frc971/971-Robot-Code/y2023_bot3/autonomous/splines/README.md

# Spline Descriptions
This folder contains reference material for what each spline does
