frc971/971-Robot-Code/y2022/localizer/kernel/README

As of 2022.02.08 this is the current version of the imu kernel driver being used
