frc971/971-Robot-Code/y2016/control_loops/python/2016_Controls_Physics_modeling.odt

2016 Robot Intake Physics Model

Michael Schuh

Spartan Robotics FRC Team 971

February 28, 2016

Models the chain on the intake as a spring. In the end, this problem was fixed by going from 25 chain to 35 chain. We considered including this physics model in the control code but never wrote code for it.

Notation

- i = i Subscript is for the Intake
- m = m Subscript is for the Motor
- B = Dampening Coefficient in N m/(rad/sec)
- G = the gear ratio and is dimensionless
- J = rotational inertia in kg m²
- Ks = Spring Constant in Nm/rad and %theta_{ i } is in rad.
- Kt = Motor Torque constant in N m/amp
- Kv = Motor Voltage constant in (rad/sec)/volt
- R = Resistance of the motor in ohms
- %theta = rotational angle in rad.
- ddot %theta = rotational angular speed in rad/sec
- ddot %theta = rotational angular acceleration in rad/sec²
- %tau = Torque in N m
- V = Volts in volts

The torques required to accelerate the inlet and motor rotational inertias are:

{%tau}_{Inertia_inlet} = {{ddot %theta}_{i} {J }_{i}} over {G} , {%tau}_{Inertia_motor} = {{ddot %theta}_{m} {J }_{m}} over {G}

As the motor angle moves ahead of the intake angle, the spring force increase and accelerates the intake faster in the positive %theta_{ m } direction and slows the motor.

{ %tau}_{Spring} = K_{s}( {{%theta}_{m}} over {G} - { %theta_{i}})

As the motor rotational speed moves ahead of the intake rotational speed, the damper force increase and accelerates the intake faster in the positive %theta_{ m } direction and slows the motor.

{ %tau}_{Damper} = B({ {{{dot %theta}}_{m}} over {G} - {dot %theta}_{i}} )

{ %tau}_{Motor} = {V K_{t}} over {R}- { {{{dot %theta}}_{m}} over {R {K}_{v}}}

The torques must balance on both the motor side of the chain and the intake side of the chain. It is easier to model the chain as a torsional spring with a damper than mess with the different radii. This will break down as the radius of the sprockets on the motor side and the intake side of the chain differ from each other.

For the motor,

{%tau}_{Inertia_motor} = {%tau}_{Motor}-{%tau}_{Spring} - {%tau}_{Damper}

{{ddot %theta}_{m} {J }_{m}} over {G} ~ = ~
{V K_{t}} over {R} ~ - ~ { {{{dot %theta}}_{m}} over {R {K}_{v}}}
~ - ~ K_{s}({{{%theta}_{m}} over {G}- %theta_{i} } )
~ - ~ B({{{{dot %theta}}_{m}} over {G} - {dot %theta}_{i}} )

collecting terms and isolating

{ddot %theta}_m ~ = ~

{G K_{t}} over {{R J_m}}V
~ - ~ { G over {R {K}_v J_m}}{{dot %theta}_m}
~ - ~ K_{s} over { J_m } {{%theta}_m}
~ + ~ {{ K_{s}G} over {J_m}%theta_i}
~ - ~ B over { J_m } {{dot %theta}_m}
~ + ~ {{ BG} over {J_m}{dot %theta}_i}

{ddot %theta}_m ~ = ~

~ - K_{s} over { J_m } {{%theta}_m}
~ - ~ ({{ G over {R {K}_v J_m}} + B over { J_m }}) {{dot %theta}_m}

~ + ~ {{ K_{s}G} over {J_m}%theta_i}
~ + ~ {{ BG} over {J_m}{dot %theta}_i}
~ + ~ {G K_{t}} over {{R J_m}}V

rewriting using coefficients

{ddot %theta }_m ~ = ~ -C_1 %theta_m
~ - ~ C_2 {dot%theta}_m
~ + ~ C_3 %theta_i
~ + ~ C_4 {dot%theta}_i
~ + ~ C_9 V

for the intake,

{%tau}_{Inertia_intake} = {%tau}_{Spring} + {%tau}_{Damper}

{{ddot %theta}_{i} {J }_{i}} over {G} = K_{s}( {{%theta}_{m}} over {G} - { %theta_{i}}) " " + " " B({ {{{dot %theta}}_{m}} over {G} - {dot %theta}_{i}} )

collecting terms and isolating {ddot %theta}_i

{ddot %theta}_i ~ = ~
K_{s} over { J_i } {{%theta}_m}
~ - ~ {{ K_{s}G} over {J_i}%theta_i}
~ + ~ B over { J_i } {{dot %theta}_m}
~ - ~ {{ BG} over {J_i}{dot %theta}_i}

rearranging

{ddot %theta}_i ~ = ~
K_{s} over { J_i } {{%theta}_m}
~ + ~ B over { J_i } {{dot %theta}_m}
~ - ~ {{ K_{s}G} over {J_i}%theta_i}
~ - ~ {{ BG} over {J_i}{dot %theta}_i}

{ddot %theta }_i ~ = ~ C_5 %theta_m
~ + ~ C_6 {dot%theta}_m
~ - ~ C_7 %theta_i
~ - ~ C_8 {dot%theta}_i

Putting in matrix form:

dot { left [ matrix{%theta_m ## %omega_m ## %theta_i ## %omega_i} right ] } ~ = ~
left [ matrix{ 0 # 1 # 0 # 0 ##
-C_1 #-C_2 # C_3 # C_4 ##
0 # 0 # 0 # 1 ##
C_5 # C_6 #-C_7 #-C_8} right ]
left [ matrix{%theta_m ## %omega_m ## %theta_i ## %omega_i} right ]
~ + ~ left [ matrix{ 0 ## C_9 ## 0 ## 0 } right ]left[ V right ]
