frc971/971-Robot-Code/documentation/README.md

# Robot Code Documentation
This folder contains reference material for how to write robot code, organized
as a set of markdown files.

# Tutorials Index

## Basic setup and development tools
* [Getting started](tutorials/getting-started.md)
* [Git and Gerrit basics](tutorials/git-and-gerrit-basics.md)
* [Submitting code for review](tutorials/submitting-code-for-a-review.md)
* [Set up access to the build server using vscode](tutorials/setup-ssh-vscode.md)
* [Install PyCharm on the build server](tutorials/setup-pycharm-on-build-server.md)

## Working with the robot
* [Putting code on the robot](tutorials/download-code-to-the-robot.md)
* [Network troubleshooting](tutorials/network_troubleshooting.md)
* [Running gdb on the rio](tutorials/rio-gdb.md)
