frc971/971-Robot-Code/frc971/control_loops/python/field_images/2019.png

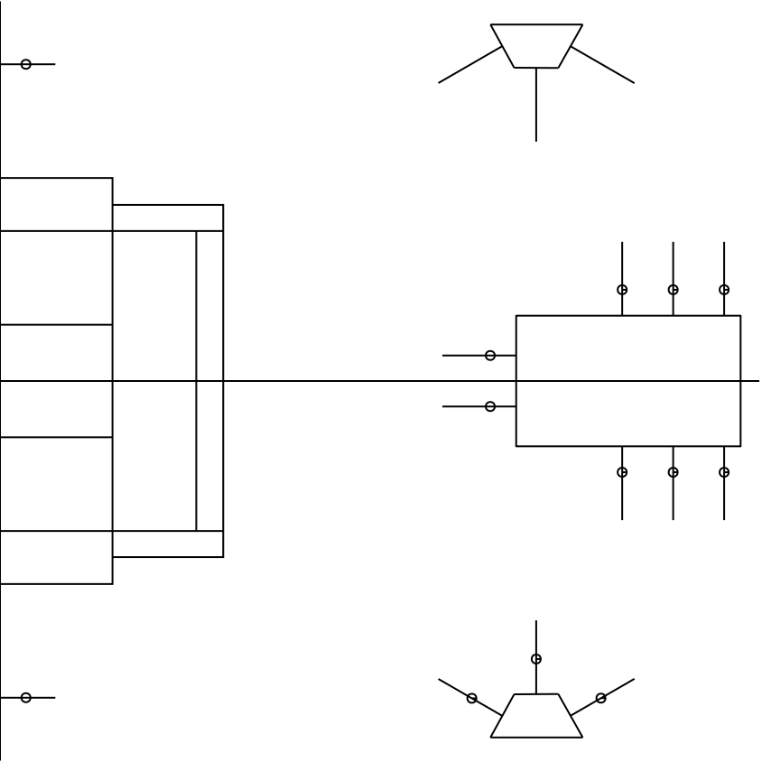
frc971/control_loops/python/field_images/2019.png
