frc971/971-Robot-Code/frc971/control_loops/python/field_images/autonav_barrel.png

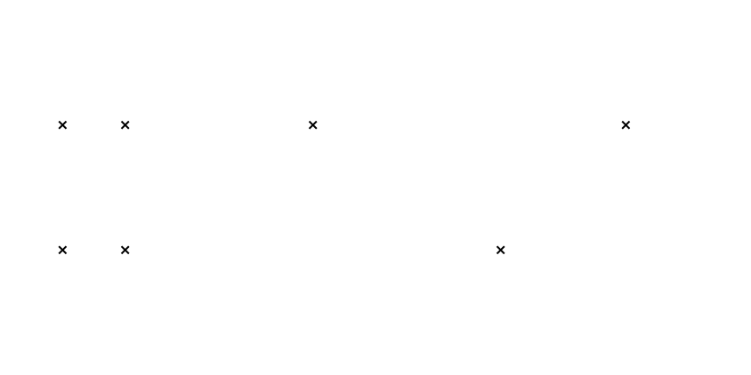
frc971/control_loops/python/field_images/autonav_barrel.png
