frc971/971-Robot-Code/frc971/control_loops/python/field_images/autonav_bounce.png

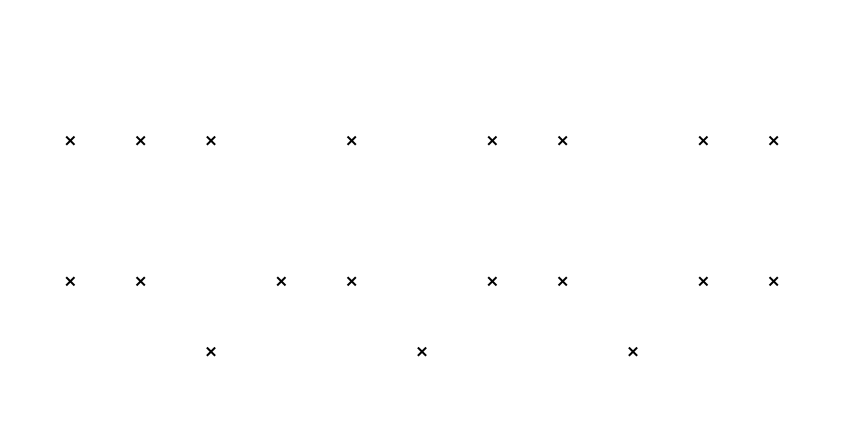
frc971/control_loops/python/field_images/autonav_bounce.png
