frc971/971-Robot-Code/frc971/control_loops/python/field_images/blue_b.png

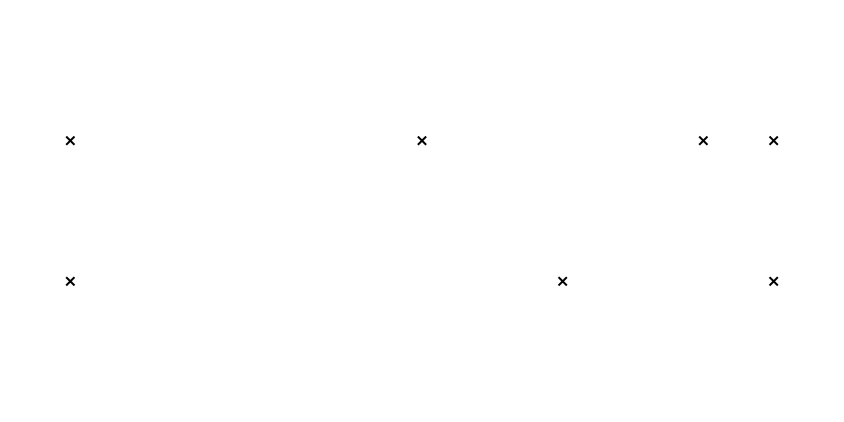
frc971/control_loops/python/field_images/blue_b.png
