frc971/971-Robot-Code/frc971/vision_codelab/blue_a.png

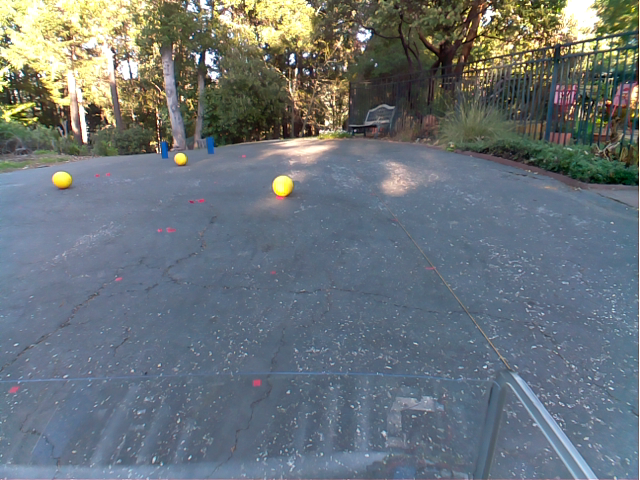
frc971/vision_codelab/blue_a.png
