frc971/971-Robot-Code/frc971/vision_codelab/red_b.png

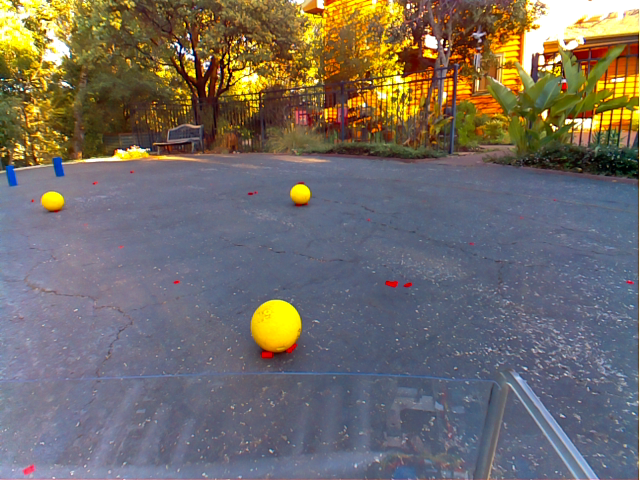
frc971/vision_codelab/red_b.png
