frc971/971-Robot-Code/frc971/vision_codelab/unknown.png

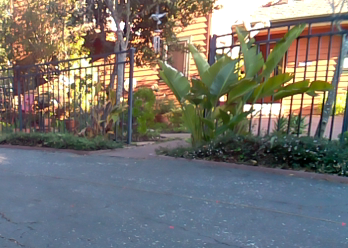
frc971/vision_codelab/unknown.png
