frc971/971-Robot-Code/scouting/www/assets/971_144.png

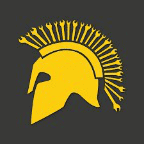
scouting/www/assets/971_144.png
