frc971/971-Robot-Code/circuit_boards/BuckBoost/RockPI-Power-Board/3dModels/IHLP2020CZ.step

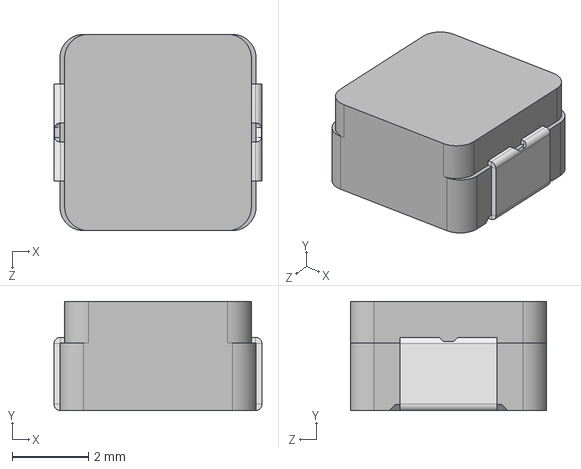
[picture p16: CAD file, 2022-12-15, last stored version]
circuit_boards/BuckBoost/RockPI-Power-Board/3dModels/IHLP2020CZ.step
5.45 x 2.86 x 5.15 mm
