frc971/971-Robot-Code/circuit_boards/BuckBoost/RockPI-Power-Board/Components/heatsink-1225-al-1.stp

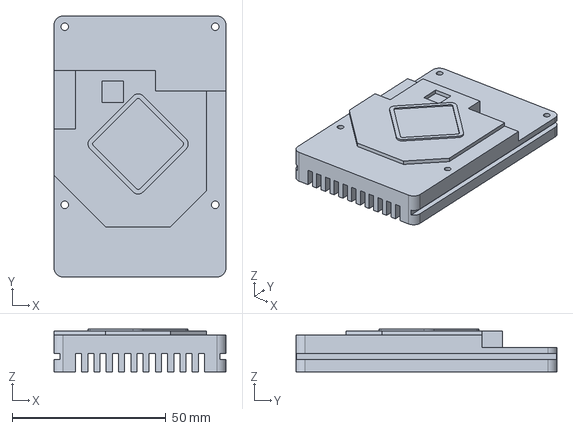
[picture p17: CAD file, 2022-12-15, last stored version]
circuit_boards/BuckBoost/RockPI-Power-Board/Components/heatsink-1225-al-1.stp
56.0 x 85.0 x 14.0 mm
