frc971/971-Robot-Code/circuit_boards/connector_boards/potentiometer_adapter/3d models/Bourns-3547.step

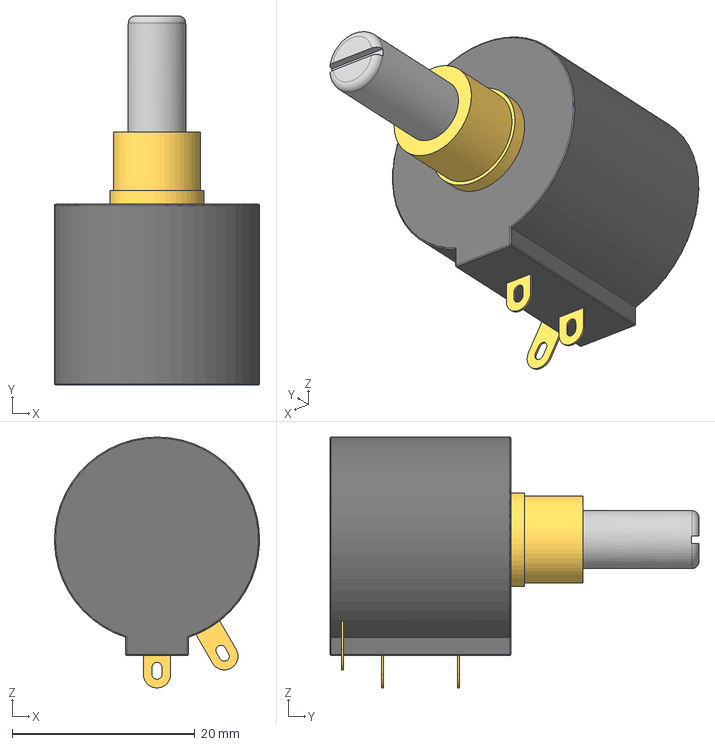
[picture p18: CAD file, 2022-10-24, last stored version]
circuit_boards/connector_boards/potentiometer_adapter/3d models/Bourns-3547.step
22.5 x 40.4 x 27.5 mm
