frc971/971-Robot-Code/circuit_boards/led-ring-driver/kicad/components/3D_Step/10 SIZE CODE G-L.stp

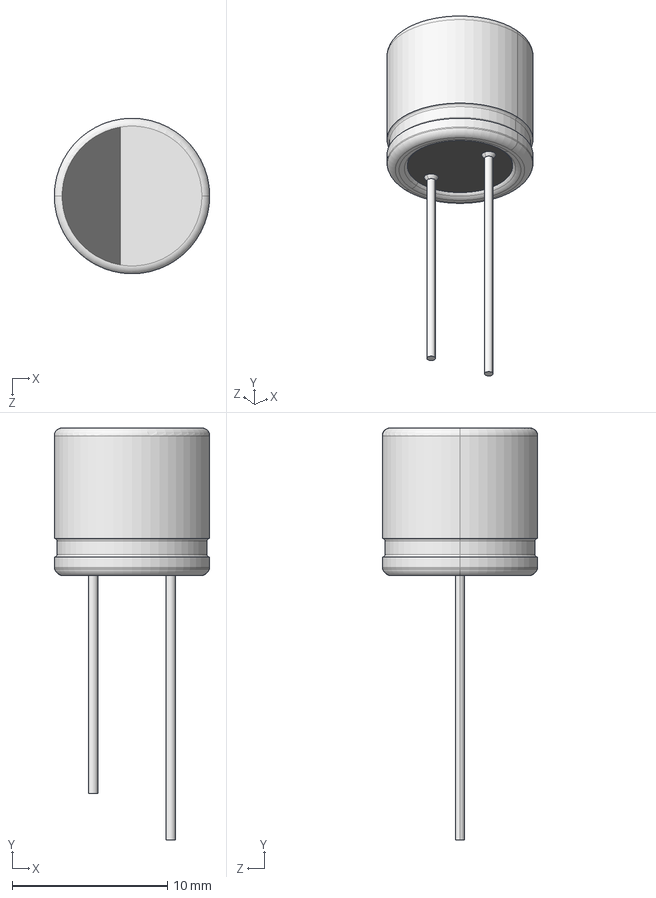
[picture p19: CAD file, 2022-02-21, last stored version]
circuit_boards/led-ring-driver/kicad/components/3D_Step/10 SIZE CODE G-L.stp
10.0 x 26.5 x 10.0 mm
