frc971/971-Robot-Code/circuit_boards/connector_boards/encoder_adapter/3d-model/CRCW08051K20FKEAC.STEP

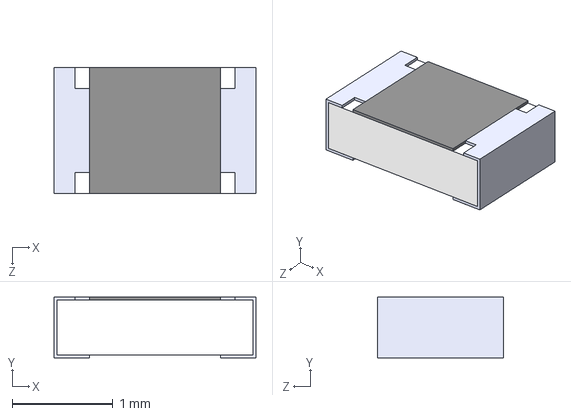
[picture p20: CAD file, 2022-10-15, last stored version]
circuit_boards/connector_boards/encoder_adapter/3d-model/CRCW08051K20FKEAC.STEP
2.00 x 0.6 x 1.25 mm
