frc971/971-Robot-Code/circuit_boards/led-ring-driver/kicad/components/3D_Step/LUXEON_2835_20160407_STEP.STEP

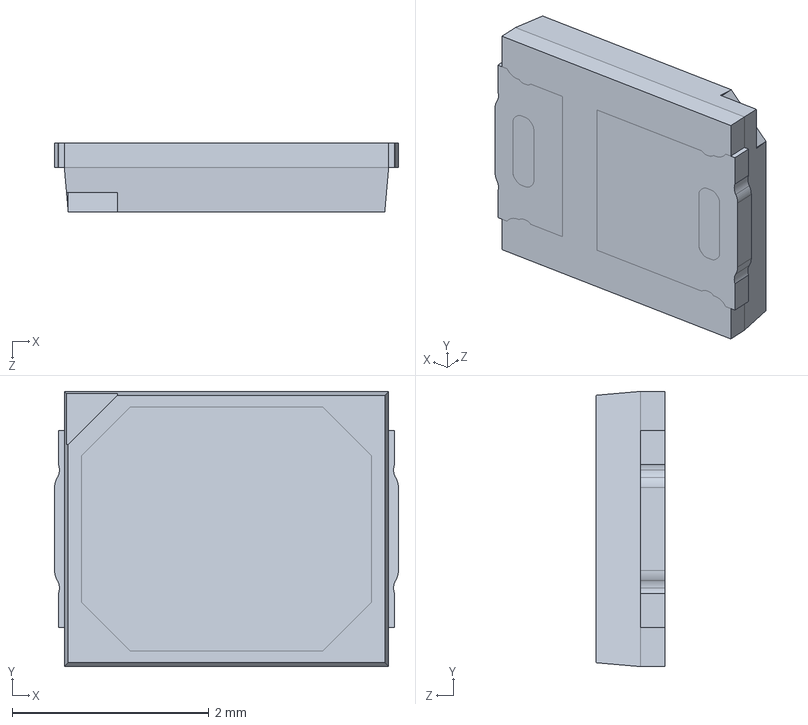
[picture p21: CAD file, 2022-02-21, last stored version]
circuit_boards/led-ring-driver/kicad/components/3D_Step/LUXEON_2835_20160407_STEP.STEP
3.50 x 2.80 x 0.701 mm
