frc971/971-Robot-Code/circuit_boards/BuckBoost/RockPI-Power-Board/3dModels/ECS-5032MV-400-CN-TR.STEP

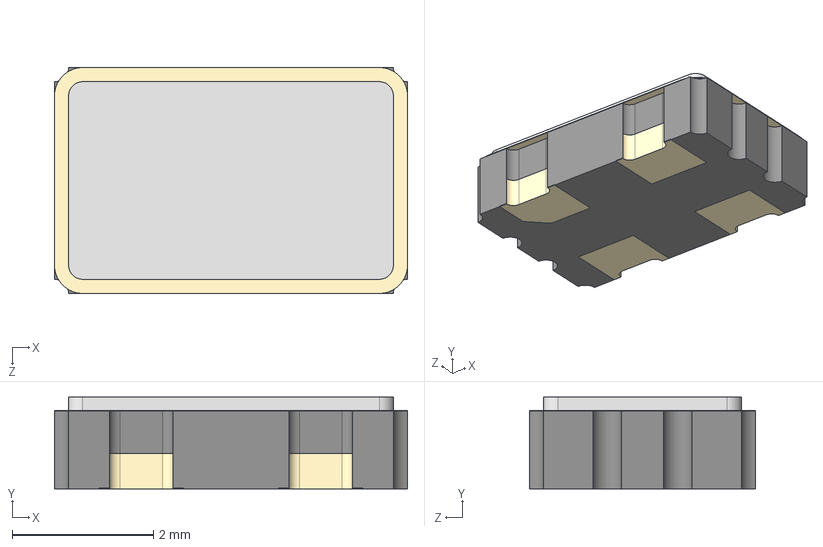
[picture p22: CAD file, 2022-12-15, last stored version]
circuit_boards/BuckBoost/RockPI-Power-Board/3dModels/ECS-5032MV-400-CN-TR.STEP
5.00 x 1.30 x 3.20 mm
