frc971/971-Robot-Code/circuit_boards/led-ring-driver/kicad/components/3D_Step/SRP3020C-1R0M_BRN.step

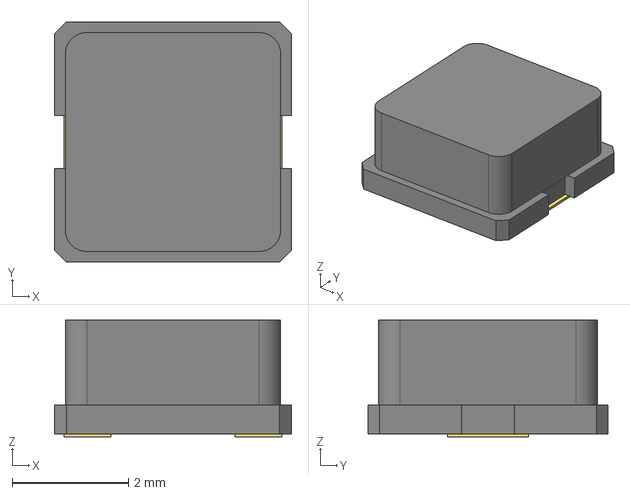
[picture p23: CAD file, 2022-02-21, last stored version]
circuit_boards/led-ring-driver/kicad/components/3D_Step/SRP3020C-1R0M_BRN.step
4.07 x 4.13 x 2.01 mm
