frc971/971-Robot-Code/circuit_boards/connector_boards/encoder_adapter/3d-model/S1-X-250-X-B-D.STEP

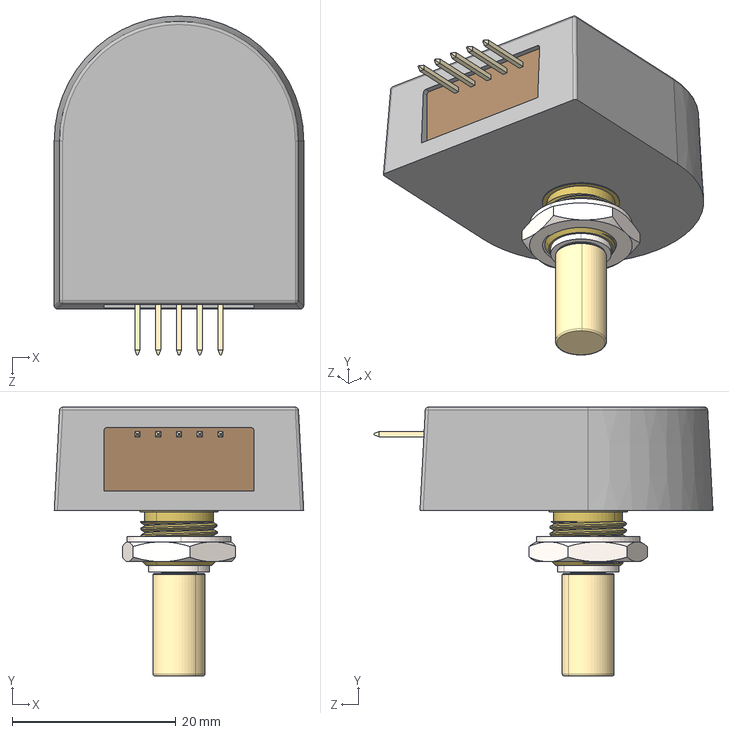
[picture p24: CAD file, 2022-10-15, last stored version]
circuit_boards/connector_boards/encoder_adapter/3d-model/S1-X-250-X-B-D.STEP
30.5 x 32.8 x 41.4 mm
