frc971/971-Robot-Code/circuit_boards/BuckBoost/RockPI-Power-Board/3dModels/VSON8-DQJ0008A.stp

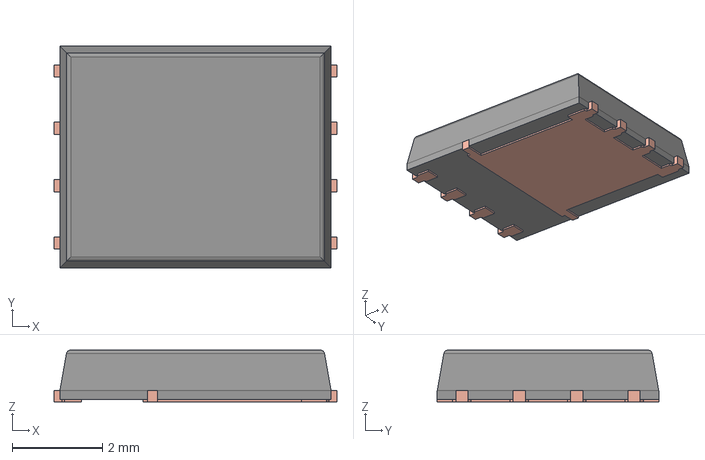
[picture p25: CAD file, 2022-12-15, last stored version]
circuit_boards/BuckBoost/RockPI-Power-Board/3dModels/VSON8-DQJ0008A.stp
6.26 x 4.90 x 1.15 mm
FRAME
MOLD
