frc971/971-Robot-Code/circuit_boards/BuckBoost/RockPI-Power-Board/3dModels/SH-7010TA.stp

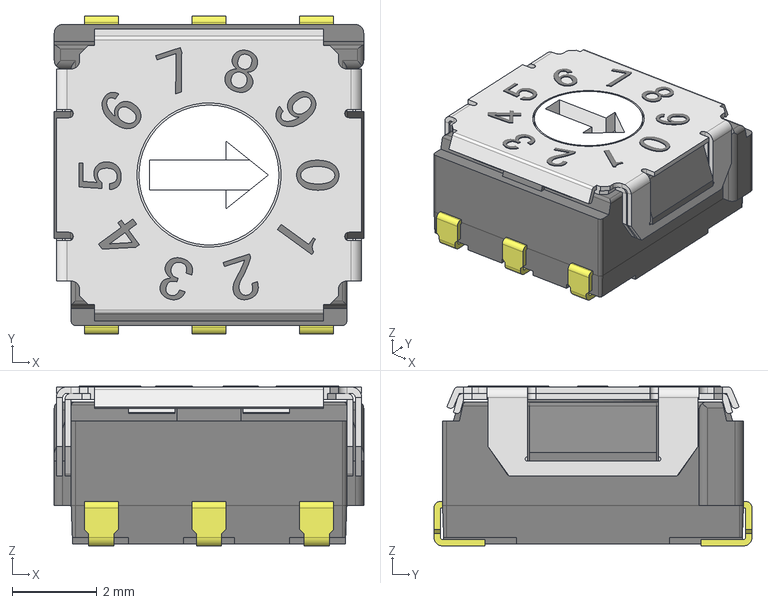
[picture p26: CAD file, 2022-12-15, last stored version]
circuit_boards/BuckBoost/RockPI-Power-Board/3dModels/SH-7010TA.stp
7.30 x 7.50 x 3.77 mm
SH-700-Without knob (Minus slot)
SH-7010A_body
