frc971/971-Robot-Code/circuit_boards/BuckBoost/RockPI-Power-Board/3dModels/m20-7812045_asm.stp

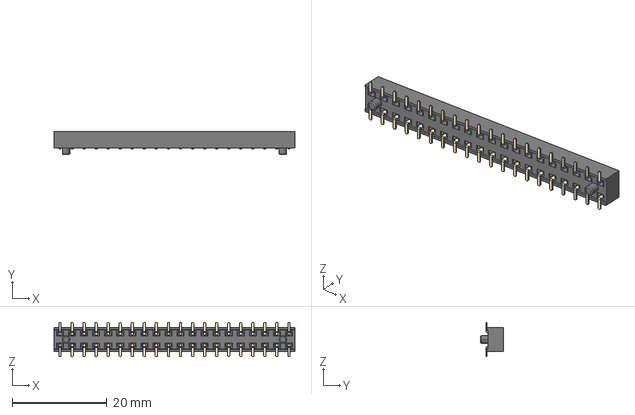
[picture p27: CAD file, 2022-12-15, last stored version]
circuit_boards/BuckBoost/RockPI-Power-Board/3dModels/m20-7812045_asm.stp
50.8 x 4.95 x 7.20 mm
M20-78120_MOULD
M20-781_CONTACT x 40
