frc971/971-Robot-Code/circuit_boards/BuckBoost/RockPI-Power-Board/3dModels/70555-0003.stp/705550003.stp

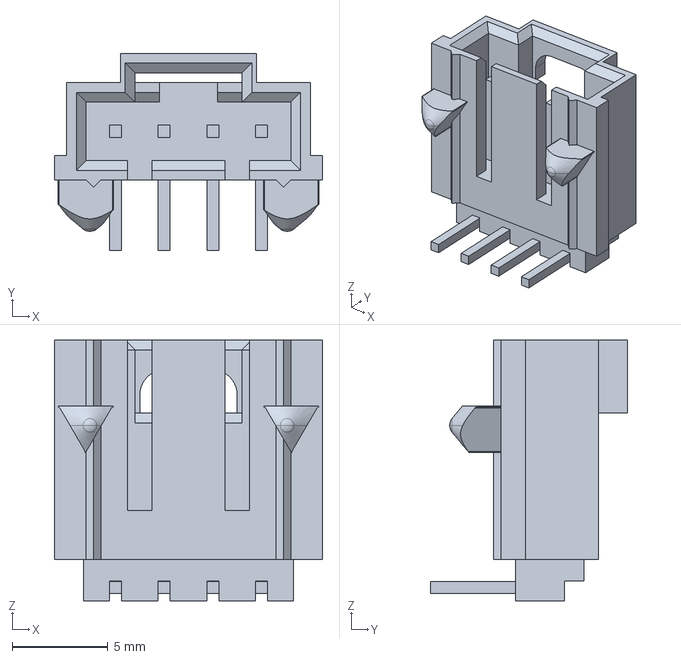
[picture p28: CAD file, 2022-12-15, last stored version]
circuit_boards/BuckBoost/RockPI-Power-Board/3dModels/70555-0003.stp/705550003.stp
14.0 x 10.3 x 13.6 mm
