frc971/971-Robot-Code/circuit_boards/CAN_boards/CAN_Terminator/3D model/70555-0036_stp/705550036.stp

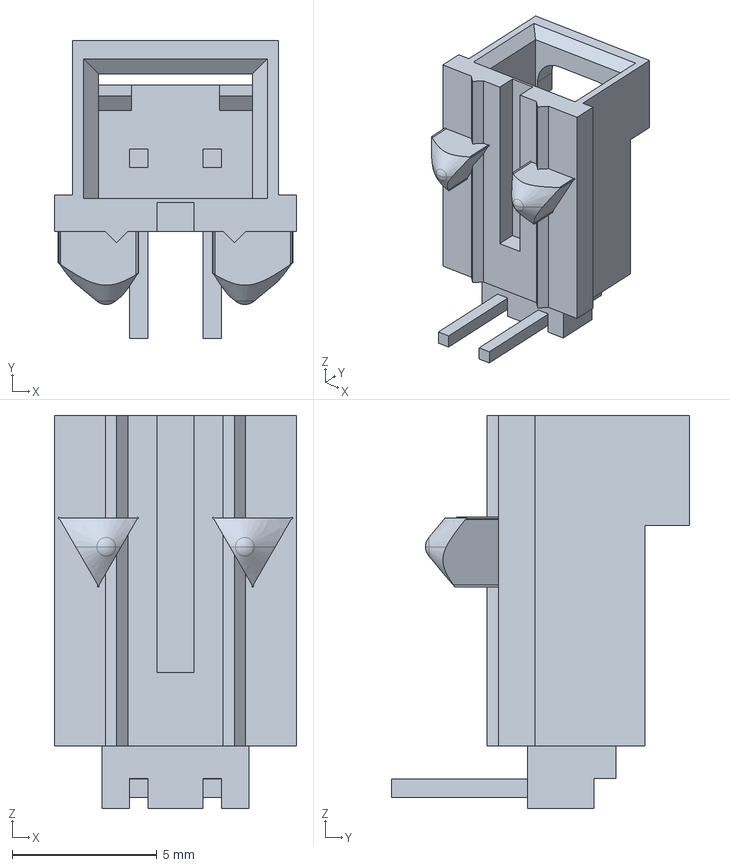
[picture p29: CAD file, 2024-02-19, last stored version]
circuit_boards/CAN_boards/CAN_Terminator/3D model/70555-0036_stp/705550036.stp
8.38 x 10.3 x 13.6 mm
