frc971/971-Robot-Code/circuit_boards/connector_boards/encoder_adapter/3d-model/150080AS75000_Download_STP_WL-SMCW-0805_rev1.stp

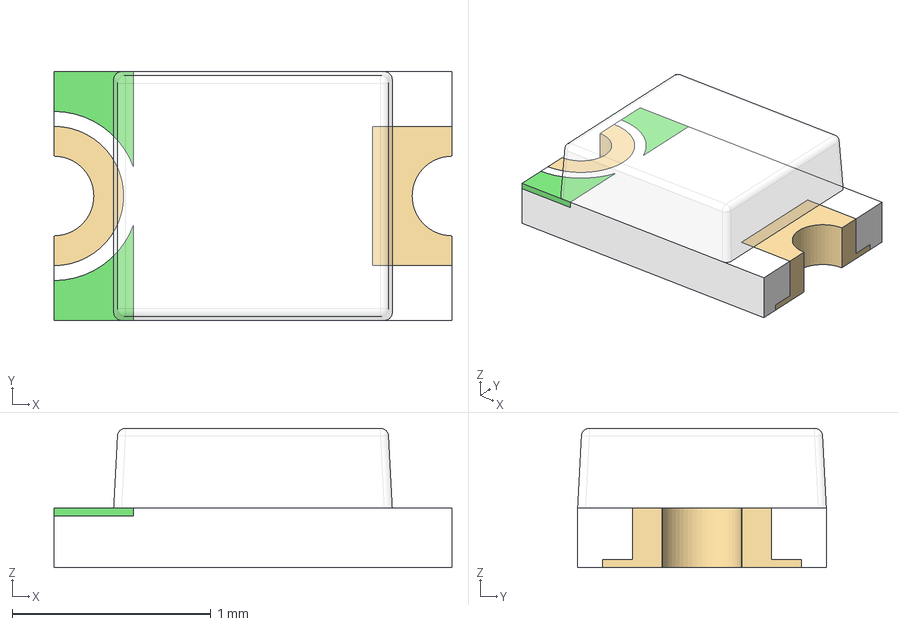
[picture p30: CAD file, 2022-10-15, last stored version]
circuit_boards/connector_boards/encoder_adapter/3d-model/150080AS75000_Download_STP_WL-SMCW-0805_rev1.stp
2.00 x 1.25 x 0.7 mm
housing
marking x 2
cover
base_2
base
