frc971/971-Robot-Code/circuit_boards/connector_boards/MAG_encoder_adapter/3D models/70555-0005--3DModel-STEP-361473.STEP

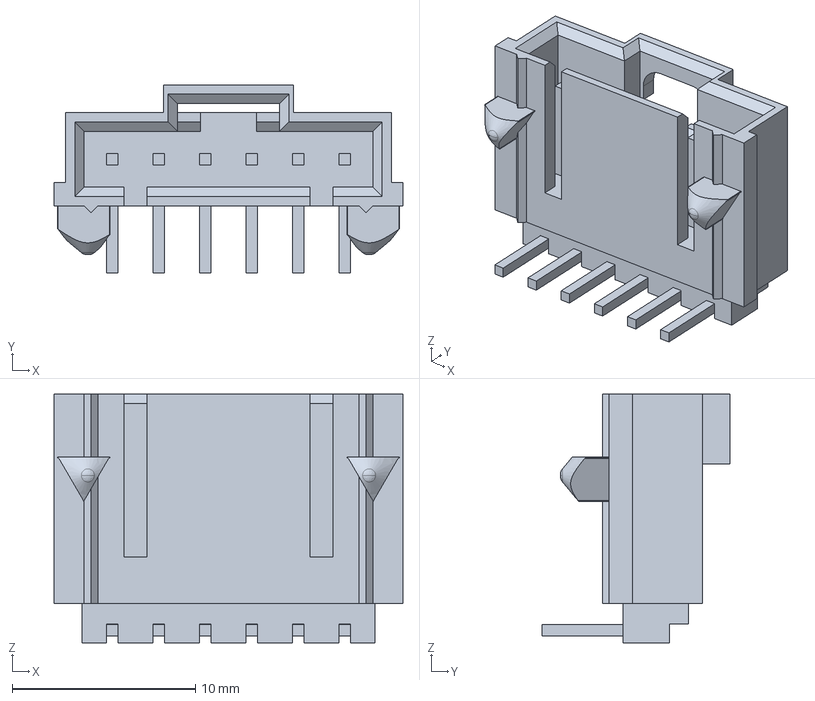
[picture p31: CAD file, 2022-10-24, last stored version]
circuit_boards/connector_boards/MAG_encoder_adapter/3D models/70555-0005--3DModel-STEP-361473.STEP
19.1 x 10.3 x 13.6 mm
