frc971/971-Robot-Code/circuit_boards/connector_boards/RRIB2/3dModels/705410005.stp

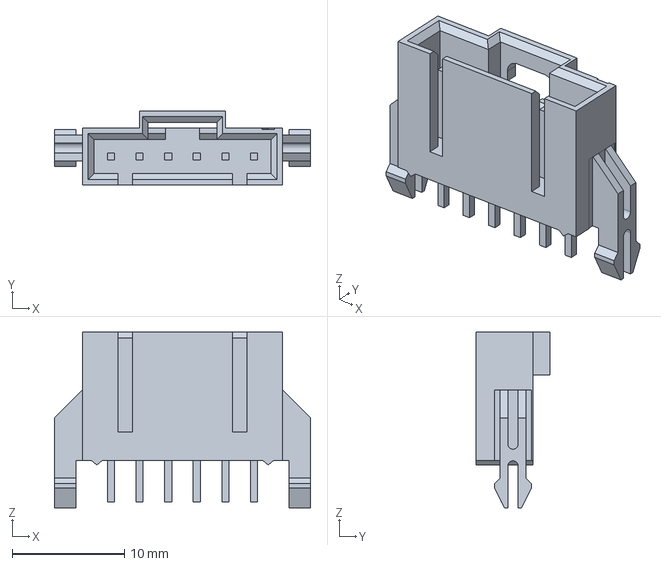
[picture p32: CAD file, 2023-02-12, last stored version]
circuit_boards/connector_boards/RRIB2/3dModels/705410005.stp
22.8 x 6.60 x 15.6 mm
