frc971/971-Robot-Code/(list of files, cad)

Other CAD files:
circuit_boards/BuckBoost/RockPI-Power-Board/3dModels/705550001.stp
circuit_boards/BuckBoost/RockPI-Power-Board/3dModels/705550002.stp
circuit_boards/BuckBoost/RockPI-Power-Board/3dModels/705550011.stp
circuit_boards/BuckBoost/RockPI-Power-Board/3dModels/744031001_Download_STP_WE-TPC-3816_rev1.stp
circuit_boards/connector_boards/MAG_encoder_adapter/3D models/20021521-00010XXLFc.stp
circuit_boards/connector_boards/MAG_encoder_adapter/3D models/705550002.stp
circuit_boards/connector_boards/RRIB2/3dModels/705410001.stp
circuit_boards/connector_boards/RRIB2/3dModels/705410002.stp
circuit_boards/connector_boards/RRIB2/3dModels/705410003.stp
circuit_boards/connector_boards/RRIB2/3dModels/705410004.stp
circuit_boards/connector_boards/RRIB2/3dModels/705410006.stp
circuit_boards/connector_boards/encoder_adapter/3d-model/705410074.stp
circuit_boards/hall-effect/3D-models/015913034.stp
circuit_boards/led-ring-driver/kicad/components/3D_Step/430450601.stp
motors/led-ring-driver/kicad/components/3D_Step/430450601.stp
