frc971/971-Robot-Code/y2020/vision/tools/python_code/test_images/test_game_manual.png

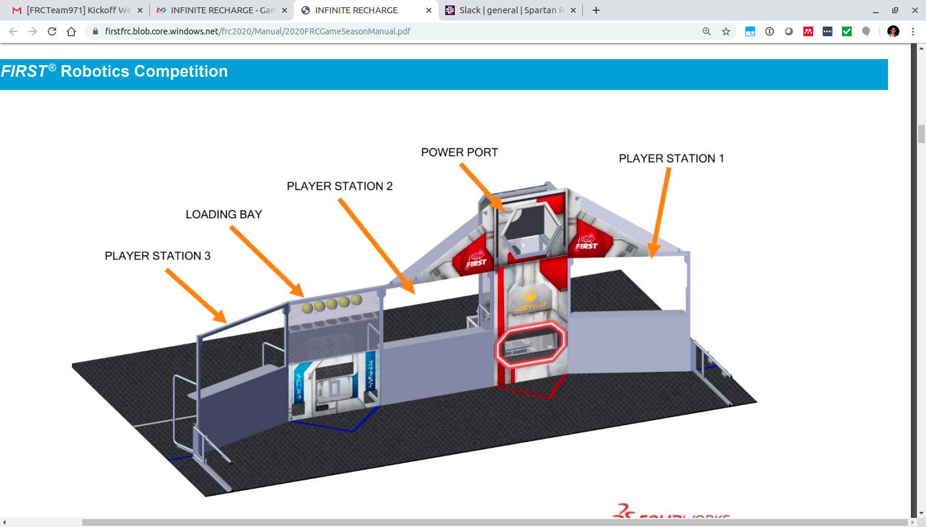
y2020/vision/tools/python_code/test_images/test_game_manual.png
