frc971/971-Robot-Code/y2020/vision/tools/python_code/test_images/cc_loading_bay_red-2021-10-29.png

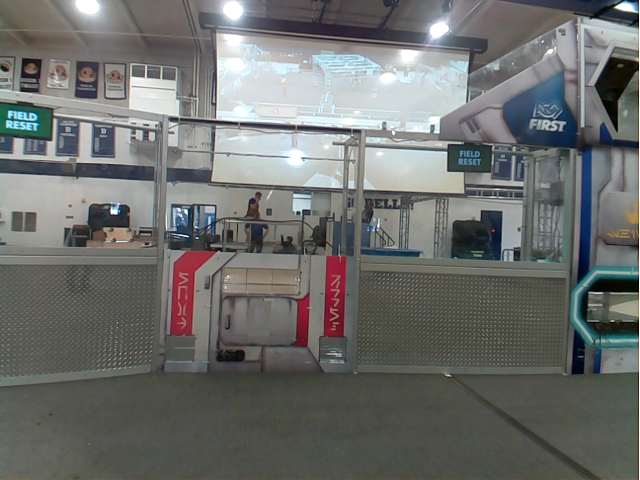
y2020/vision/tools/python_code/test_images/cc_loading_bay_red-2021-10-29.png
