frc971/971-Robot-Code/y2020/vision/tools/python_code/test_images/cc_power_port_blue-2021-10-29.png

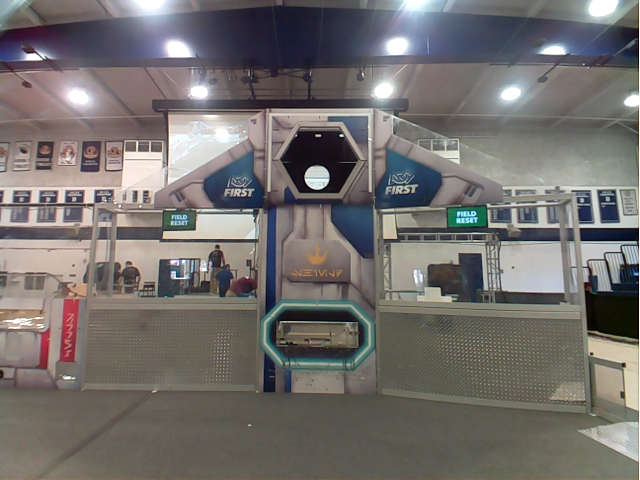
y2020/vision/tools/python_code/test_images/cc_power_port_blue-2021-10-29.png
