frc971/971-Robot-Code/y2020/vision/tools/python_code/test_images/ideal_loading_bay_blue.png

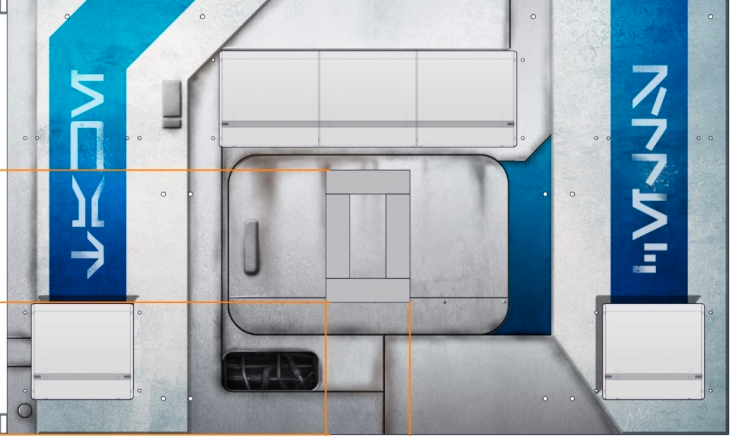
y2020/vision/tools/python_code/test_images/ideal_loading_bay_blue.png
