frc971/971-Robot-Code/y2020/vision/tools/python_code/test_images/ideal_power_port_red.png

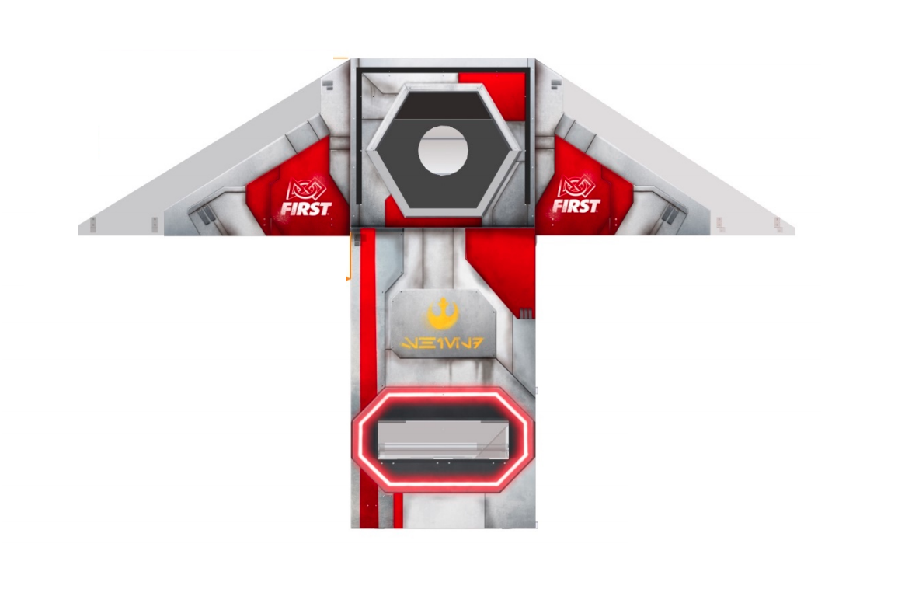
y2020/vision/tools/python_code/test_images/ideal_power_port_red.png
