frc971/971-Robot-Code/y2020/vision/tools/python_code/test_images/mvhs_power_port_red-2021-11-06.png

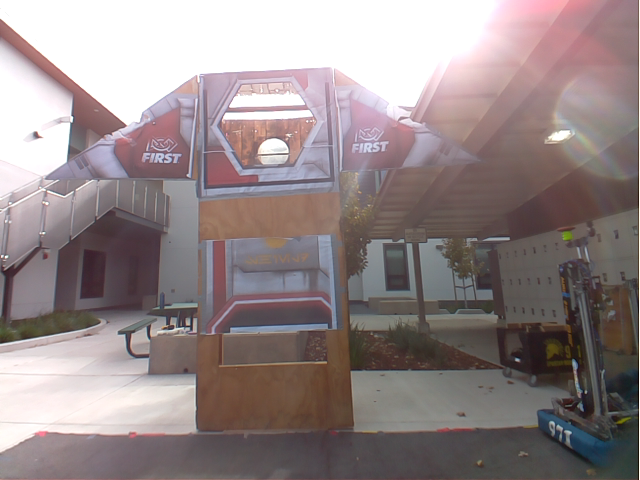
y2020/vision/tools/python_code/test_images/mvhs_power_port_red-2021-11-06.png
