frc971/971-Robot-Code/y2020/vision/tools/python_code/test_images/partial_971_power_port_red_daytime_far.png

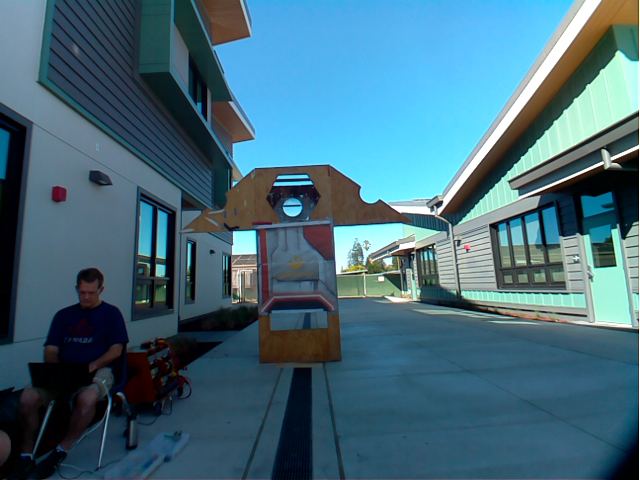
y2020/vision/tools/python_code/test_images/partial_971_power_port_red_daytime_far.png
