frc971/971-Robot-Code/y2020/vision/tools/python_code/test_images/test_train_shift_right_100.png

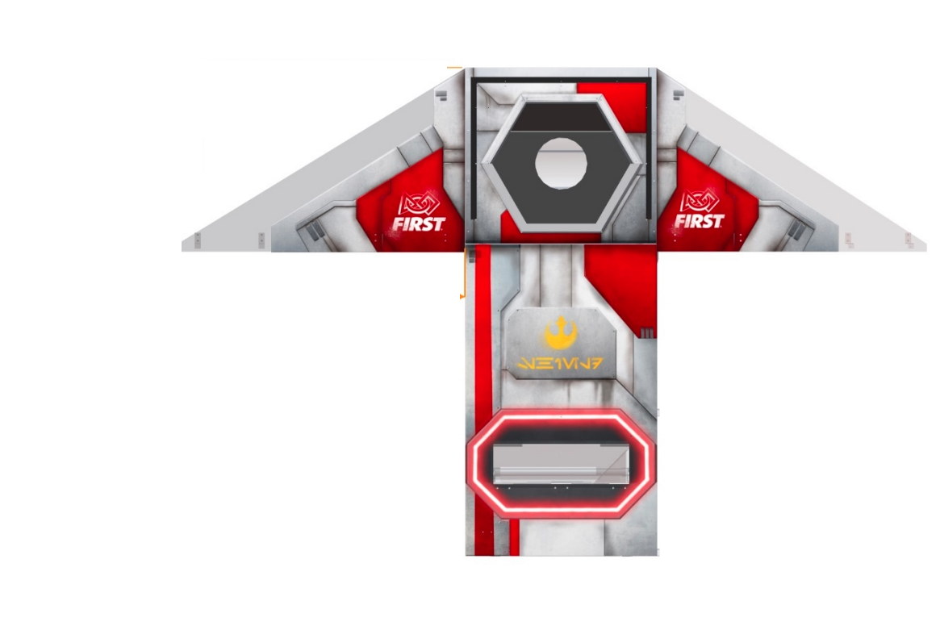
y2020/vision/tools/python_code/test_images/test_train_shift_right_100.png
