frc971/971-Robot-Code/y2020/vision/tools/python_code/test_images/train_power_port_red_webcam.png

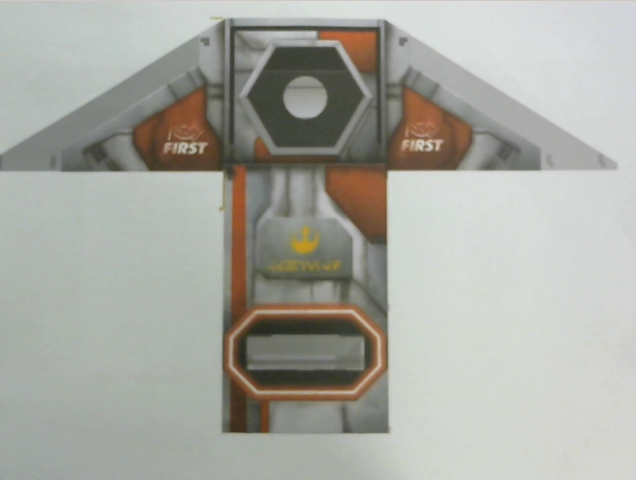
y2020/vision/tools/python_code/test_images/train_power_port_red_webcam.png
