frc971/971-Robot-Code/y2022/vision/test_ball_color_image.jpg

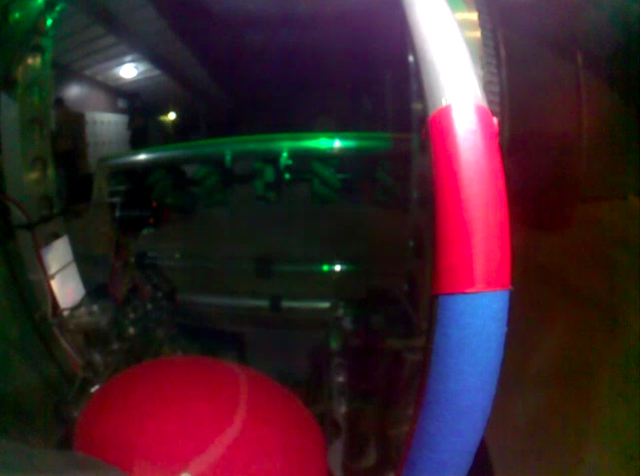
y2022/vision/test_ball_color_image.jpg
