frc971/971-Robot-Code/(threads)

Thread 6 (2022-03-13):

Add improved flatbuffer building API

jkuszmaul, 2022-03-13:
The current API is cumbersome, confusing, and prone to human error.

bsilver8192, 2022-03-13:
Oops, I opened #8 for this halfway through reading my notifications (before seeing this). Lots more detail over there.

Closed 2022-03-13.

Thread 8 (2022-03-13):

Better C++ flatbuffers API

bsilver8192, 2022-03-13:
The current flatbuffers C++ API requires building up messages inside-out. It should be possible to use the C++ stack for this instead, to allow the C++ code to build up messages from the outside in (which is often more natural).

More concretely, this means generating C++ classes for each flatbuffer struct which hold values for each field (and track which ones are set). Nested structs should be contained in their parent objects, because a major use case is calling functions which return a nested object, and there's no other easy place to store these objects. Then, these objects can do a depth-first traversal of the C++ object graph to actually write the flatbuffer (aka each object writes out its children, tracking the resulting offsets in local variables, then writes out itself and returns the offset to its parent).

I think writing the buffer should be done in a `offset_t Write` method (or similar), which is passed the FlatBufferBuilder. The top-level will normally be called via a templated wrapper type that holds onto the fbb with a destructor which calls `Write` on the top-level object and then `Finish`, to keep everything in outside-in order.

An alternative would be holding the fbb in each object, and then having their destructors write it out, but that means more stack space and makes it impossible to decide to skip writing it out later (for example, build up a sub object and then realize it's not actually needed, without taking up any space in the final buffer). Doing it in the destructor also means the parent object has to keep track of where the offsets to all its children are coming from.

Need to think through handling arrays of primitives. These can be big and variable-sized, neither of which interacts well with putting them on the stack. At the same time, allocating them immediately unlike other objects makes for a confusing API. Maybe provide APIs for both?

Handling arrays of objects is tricky. `ArrayWriter<T> StartArray(int max_size)` would work well for many cases, with convenience `void CreateArray(span<const T>)` when the temporary storage is managed externally. However, there's no place to stash C++ pointers to the intermediate objects. The flatbuffers array needs to be placed after those objects in the buffer, and C++ pointers are larger than offsets on 64-bit platforms. Forcing the user to allocate that array externally goes against making this API nice and easy to use, but that's the best I can think of right now. `void CreateArray(span<const T*>)`, with an extra level of indirection, could be handy but also looks like a big foot-gun with dangling references.

Do we need to manage shared subobjects? Writing them out redundantly is easy, but not helpful for space efficiency. Maybe use a bit in the bitmask to track whether it's been written out, and make a union for all the variable storage which gets overwritten to the offset it was written to?

This will increase stack usage, which may be undesirable. It's probably worth using a bitmask in the generated code to track which fields are set, rather than using `std::optional` or a separate `bool` for each one.

Copying sub-objects could become expensive. It should be possible to structure this so that RVO (return value optimization) constructs the sub-objects in place for the common case of a function returning an entire sub-object.

These classes end up looking similar to the existing `TableT`, but without storing data in the objects. Do we want to expose reading the fields (and checking if they're set) and/or building them from a `const Table*`?

Thread 11 (2022-04-02):

Dropping sent-too-fast messages in LogReader makes unreadable logs

jkuszmaul, 2022-04-02:
We currently drop replayed messages if they get sent too fast when replaying a log. This is itself somewhat dubious behavior, but also creates an issue where if you create a log of the replay, then you can get errors like

```F0402 12:20:39.001713  8892 logfile_utils.cc:1506] Check failed: result.timestamp == monotonic_remote_time ({.boot=0, .time=160.591261903sec} vs. {.boot=0, .time=160.623109070sec}) : Queue index matches, but timestamp doesn't.  Please investigate!```

jkuszmaul, 2022-05-06:
We now allow logger to send too fast.

Closed 2022-05-06.

Thread 15 (2022-05-16):

aos_dump doesn't respect maps

AustinSchuh, 2022-05-16:
If you have `/camera` -> `/pi1/camera` on pi1, `aos_dump /camera` complains and doesn't respect the map.

This is a bit subtle, since we really would like aos_dump to be able to subscribe to any channel for debugging.  But, it would also be nice to have aos_dump properly respect remaps.

Closed 2025-04-24.

Thread 19 (2022-08-03):

OOM killer leaks messages

AustinSchuh, 2022-08-03:
If the OOM killer kills a process, all it's handles get leaked.  This is because the OOM killer doesn't run the robust futex cleanup to free the messages.

It actually looks like /proc/pid/stat has a start time for the thread.  When opening the queue, we could look for any PIDs which are nonzero, see if they exist, and then check that the start time matches.  If it does, it's pretty much guaranteed to be the same process, and is actually running.

bsilver8192, 2022-08-03:
Another option is generating a unique ID and putting it into the environment (which can be read via /proc/pid/environ), and record that in shared memory so other threads can check it.

If there's currently a task with a matching TID but its environ either doesn't have the variable or has a different value, then it's a different process.

Closed 2025-04-24.

Thread 20 (2022-10-15):

JSON config should not accept timestamp_logger_nodes that different from source_node

yimmy13, 2022-10-15:
Guided by Austin-- I was looking at the following code out of y2022_roborio.json:

`    {
      "name": "/drivetrain",
      "type": "frc971.control_loops.drivetrain.Output",
      "source_node": "roborio",
      "frequency": 400,
      "max_size": 80,
      "num_senders": 2,
      "logger": "LOCAL_AND_REMOTE_LOGGER",
      "logger_nodes": [
        "imu"
      ],
      "destination_nodes": [
        {
          "name": "imu",
          "priority": 5,
          "timestamp_logger": "LOCAL_AND_REMOTE_LOGGER",
          "timestamp_logger_nodes": [
            "imu"
          ],
          "time_to_live": 5000000
        }
      ]
    },
`
The timestamp_logger_nodes should be the source_node, "roborio", rather than currently as "imu".  Our json creation/merging shouldn't accept other choices than the source_node.

Closed 2025-04-24.

Thread 23 (2023-01-17):

Year 2018 arm feedforward

gaborszita, 2023-01-17:
Hey,

I'm Gabor from team 114 and we're looking at your arm feed forward code to try to implement it in our robot. It's in the `y2018/control_loops/python/arm_trajectory.py` file. Can you please explain us a few things?

1. What are the `G1` and `G2` constants? I think this is the gear ratio of the motors, but I'm not 100% sure.

The following questions are not essential to be answered, but if you have time, we'd appreciate if you do

2. What is the difference between the `K2` and `K4` matrices? I understand what the other matrices do, but `K2` and `K4` are both multiplied by omega - which would imply that both are used to relate torque to omega. But I don't understand why you would need two matrices for the same thing. Can you please clarify what the exact purpose of these matrices are?
3. Can you please clarify how exactly the constant matrices are calculated and what the values in it are?

@AustinSchuh @platipus25 I'm pinging you because it seems that you are the contributors to this file, so I assume you know the implementation details.

Thanks in advance,
Gabor and team 114

jkuszmaul, 2023-01-21:
@gaborszita

* G1 and G2 are gear ratios for each joint
* K2 and K4 capture different physical effects. K2 has to do with the impacts of centripetal accelerations/coriolis force; K4 has to do with the backEMF of the motors.
* Not sure what you are asking re: constant matrices.

AustinSchuh, 2023-01-24:
I think we've lost the derivation over time, but the derivation is done using lagrangian mechanics.  These things suck to do by hand.

Closed 2023-03-27.

Thread 25 (2023-04-09):

Ran out of signals

AustinSchuh, 2023-04-09:
We have a watcher which blocks forever (different bug).  This makes it so the event loop isn't able to process signals.

RT signals queue up.  RLIMIT_SIGPENDING is the limit per process, which defaults to somewhere around 7k of them.

Once this happens, we are unable to wake up any process, and everything gets triggered off timers.  We need a way to not accumulate signals forever.

Closed 2025-04-24.

Thread 26 (2023-04-12):

irq_affinity should report top results

AustinSchuh, 2023-04-12:
This would be incredibly handy to be able to debug what is happening when something goes wrong to see what else is happening in the system.  1hz is plenty (as we dredge through /proc to see how things are going), or lower frequency when we are dredging through.

We should also put the scheduler + affinity + priority in that report too, along with memory usage.

Thread 30 (2023-08-14):

Faster DARE solver

calcmogul, 2023-08-14:
I thought you may be interested that I contributed a [new DARE solver](https://github.com/wpilibsuite/allwpilib/pull/5536) to WPILib that's 2.8x faster than SLICOT, the solver you use now, based on [roboRIO benchmarking](https://github.com/calcmogul/DAREBench/#roborio) on a 5 state, 2 input differential drive LQR problem.

The gist of the algorithm from DOI 10.1080/00207170410001714988 is:
```cpp
#include <Eigen/Cholesky>
#include <Eigen/Core>
#include <Eigen/LU>

template <int States, int Inputs>
Eigen::Matrix<double, States, States> DARE(
    const Eigen::Matrix<double, States, States>& A,
    const Eigen::Matrix<double, States, Inputs>& B,
    const Eigen::Matrix<double, States, States>& Q,
    const Eigen::Matrix<double, Inputs, Inputs>& R) {
  // [1] E. K.-W. Chu, H.-Y. Fan, W.-W. Lin & C.-S. Wang
  //     "Structure-Preserving Algorithms for Periodic Discrete-Time
  //     Algebraic Riccati Equations",
  //     International Journal of Control, 77:8, 767-788, 2004.
  //     DOI: 10.1080/00207170410001714988
  //
  // Implements SDA algorithm on p. 5 of [1] (initial A, G, H are from (4)).
  using StateMatrix = Eigen::Matrix<double, States, States>;

  StateMatrix A_k = A;
  StateMatrix G_k = B * R.llt().solve(B.transpose());
  StateMatrix H_k;
  StateMatrix H_k1 = Q;

  do {
    H_k = H_k1;

    StateMatrix W = StateMatrix::Identity() + G_k * H_k;
    auto W_solver = W.lu();

    StateMatrix V_1 = W_solver.solve(A_k);

    // Solve V₂Wᵀ = Gₖ for V₂
    //
    // V₂Wᵀ = Gₖ
    // (V₂Wᵀ)ᵀ = Gₖᵀ
    // WV₂ᵀ = Gₖᵀ
    // V₂ᵀ = W.solve(Gₖᵀ)
    // V₂ = W.solve(Gₖᵀ)ᵀ
    StateMatrix V_2 = W_solver.solve(G_k.transpose()).transpose();

    G_k += A_k * V_2 * A_k.transpose();
    H_k1 = H_k + V_1.transpose() * H_k * A_k;
    A_k *= V_1;
  } while ((H_k1 - H_k).norm() > 1e-10 * H_k1.norm());

  return H_k1;
}
```
The preconditions necessary for convergence are:
1. Q is symmetric positive semidefinite
2. R is symmetric positive definite
3. The (A, B) pair is stabilizable
4. The (A, C) pair where Q = CᵀC is detectable

The paper proves convergence under weaker conditions, but it seems to involve solving a generalized eigenvalue problem with the QZ algorithm. SLICOT and Drake use that to solve the whole problem, so it seemed too expensive to bother attempting.

The precondition checks turned out to be 50-60% of the total algorithm runtime, so WPILib exposed a function that skips them if the user knows they'll be satisfied. This would be a good candidate for your Kalman filter error covariance init code, since a comment in there mentioned it didn't use the DARE solver because it had unnecessary checks.

Here's WPILib's impl, which supports static sizing (for performance) and dynamic sizing (for JNI) and throws exceptions on precondition violations.
https://github.com/wpilibsuite/allwpilib/blob/main/wpimath/src/main/native/include/frc/DARE.h

I'd recommend [std::expected](https://en.cppreference.com/w/cpp/utility/expected) instead of exceptions for your use case.

jkuszmaul, 2023-08-14:
Thanks for the heads up! May swap this in if we end up leaning heavily on this again. I don't think that DARE solving has been _the_ bottleneck on anything recently, although discretization definitely has been, so this'll be helpful.

Closed 2025-04-24.

Thread 35 (2024-10-08):

static flatbuffers codegen doesn't place nice with external repos

jameskuszmaul-brt, 2024-10-08:
Currently the codegen for the static flatbuffers API produces `#include`s with an `external/` prefix (when generating code inside of an external repo) which doesn't seem to play too nice; try to provide better options for specifying how include paths get generated.

Closed 2025-04-24.
