frc971/971-Robot-Code/(list of files, drawings)

Other design files:
bbb_cape/schematic/cape.pcb
circuit_boards/BuckBoost/RspBuckBoost/RspPiPS.pcb
circuit_boards/BuckBoost/RspBuckBoostv2/RspPiPS.pcb
circuit_boards/BuckBoost/RspBuckBoostv3/RspPiPS.pcb
motors/big_schematic/control.pcb
motors/big_schematic/fet12.pcb
motors/big_schematic/fet12connectors.pcb
motors/big_schematic/fet12logic.pcb
motors/big_schematic/fet12v2.pcb
motors/big_schematic/fet12v2accessory.pcb
motors/big_schematic/fet12v2logic.pcb
motors/big_schematic/power.pcb
motors/encoder_schematic/board.pcb
motors/encoder_schematic/commutation.pcb
motors/hid_schematic/board.pcb
motors/hid_schematic/led.pcb
motors/little_schematic/board.pcb
motors/receiver_schematic/board.pcb
motors/receiver_schematic/capx4.pcb
motors/receiver_schematic/simple.pcb
motors/RspBuckBoost/RspPiPS.pcb
motors/RspBuckBoostv2/RspPiPS.pcb
motors/RspBuckBoostv3/RspPiPS.pcb
motors/uart_schematic/uart.pcb
