frc971/971-Robot-Code/circuit_boards/connector_boards/MAG_encoder_adapter/MAG_encoder_adapter.kicad_pcb

## KiCad design circuit_boards/connector_boards/MAG_encoder_adapter/MAG_encoder_adapter.kicad_pcb (2023-02-12, last stored version)

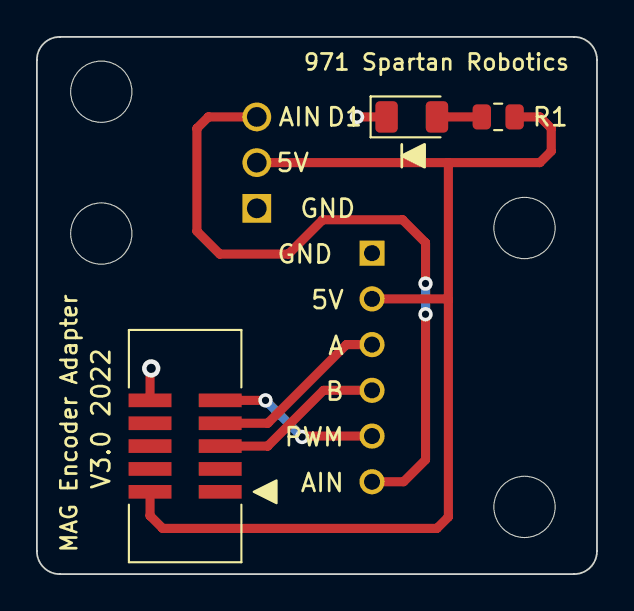
[picture p49: board MAG_encoder_adapter.kicad_pcb from above]

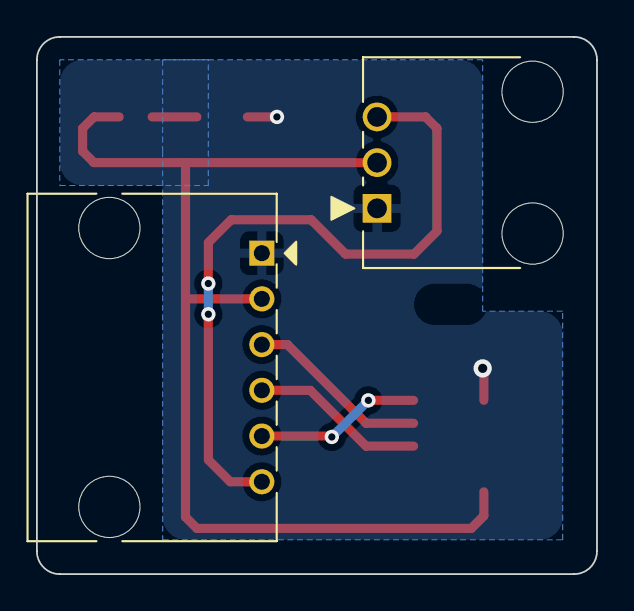
[picture p50: board MAG_encoder_adapter.kicad_pcb from below]

Board: 2 copper layers, 31.1 x 29.8 mm, 5 parts (2 on the bottom side), 7 nets.

Parts:
D1: LED; LED_1206_3216Metric
J2: POT; 70555-0002
J3: RIO; 705550005
R1: 2.0k 1%; R_0805_2012Metric
locked: Mag-encoder; 20021521-00010T1LF

Connections:
+5V: J2.2, J3.2, R1.2, locked.2
/A: J3.3, locked.7
/AIN: J2.3, J3.6
/B: J3.4, locked.5
/PWM: J3.5, locked.9
GND: D1.1 (K), J2.1, J3.1, locked.10
unnamed: D1.2 (A), R1.1
