frc971/971-Robot-Code/circuit_boards/hall-effect/hall-effect.kicad_pcb

## KiCad design circuit_boards/hall-effect/hall-effect.kicad_pcb (2023-02-12, last stored version)

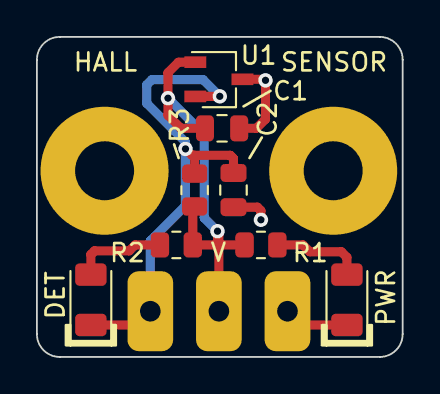
[picture p51: board hall-effect.kicad_pcb from above]

Board: 2 copper layers, 20.3 x 17.8 mm, 11 parts (0 on the bottom side), 5 nets.

Parts:
C1: 0.1uF-25V-0805; C_0805_2012Metric
C2: 4.7nF-50V-0805; C_0805_2012Metric
D1: PWR; LED_1206_3216Metric
D2: DET; LED_1206_3216Metric
H1, H2: mounting-hole
J1: Conn_01x03_Male; 3PIN header
R1, R2: 1.0k-1%-0805; R_0805_2012Metric
R3: 10k-1%-0805; R_0805_2012Metric
U1: US5881LSE; TSOT-23

Connections:
/5V0: C1.1, J1.2, R1.1, R2.1, R3.1, U1.1 (VDD)
/GND: C1.2, C2.2, D1.1 (K), J1.1, U1.3 (GND)
/OUT: C2.1, D2.1 (K), J1.3, R3.2, U1.2 (OUT)
unnamed: D1.2 (A), R1.2
unnamed: D2.2 (A), R2.2
