frc971/971-Robot-Code/circuit_boards/BuckBoost/RockPI-Power-Board/PI-Power-Board.kicad_pcb

## KiCad design circuit_boards/BuckBoost/RockPI-Power-Board/PI-Power-Board.kicad_pcb (2022-12-15, last stored version)

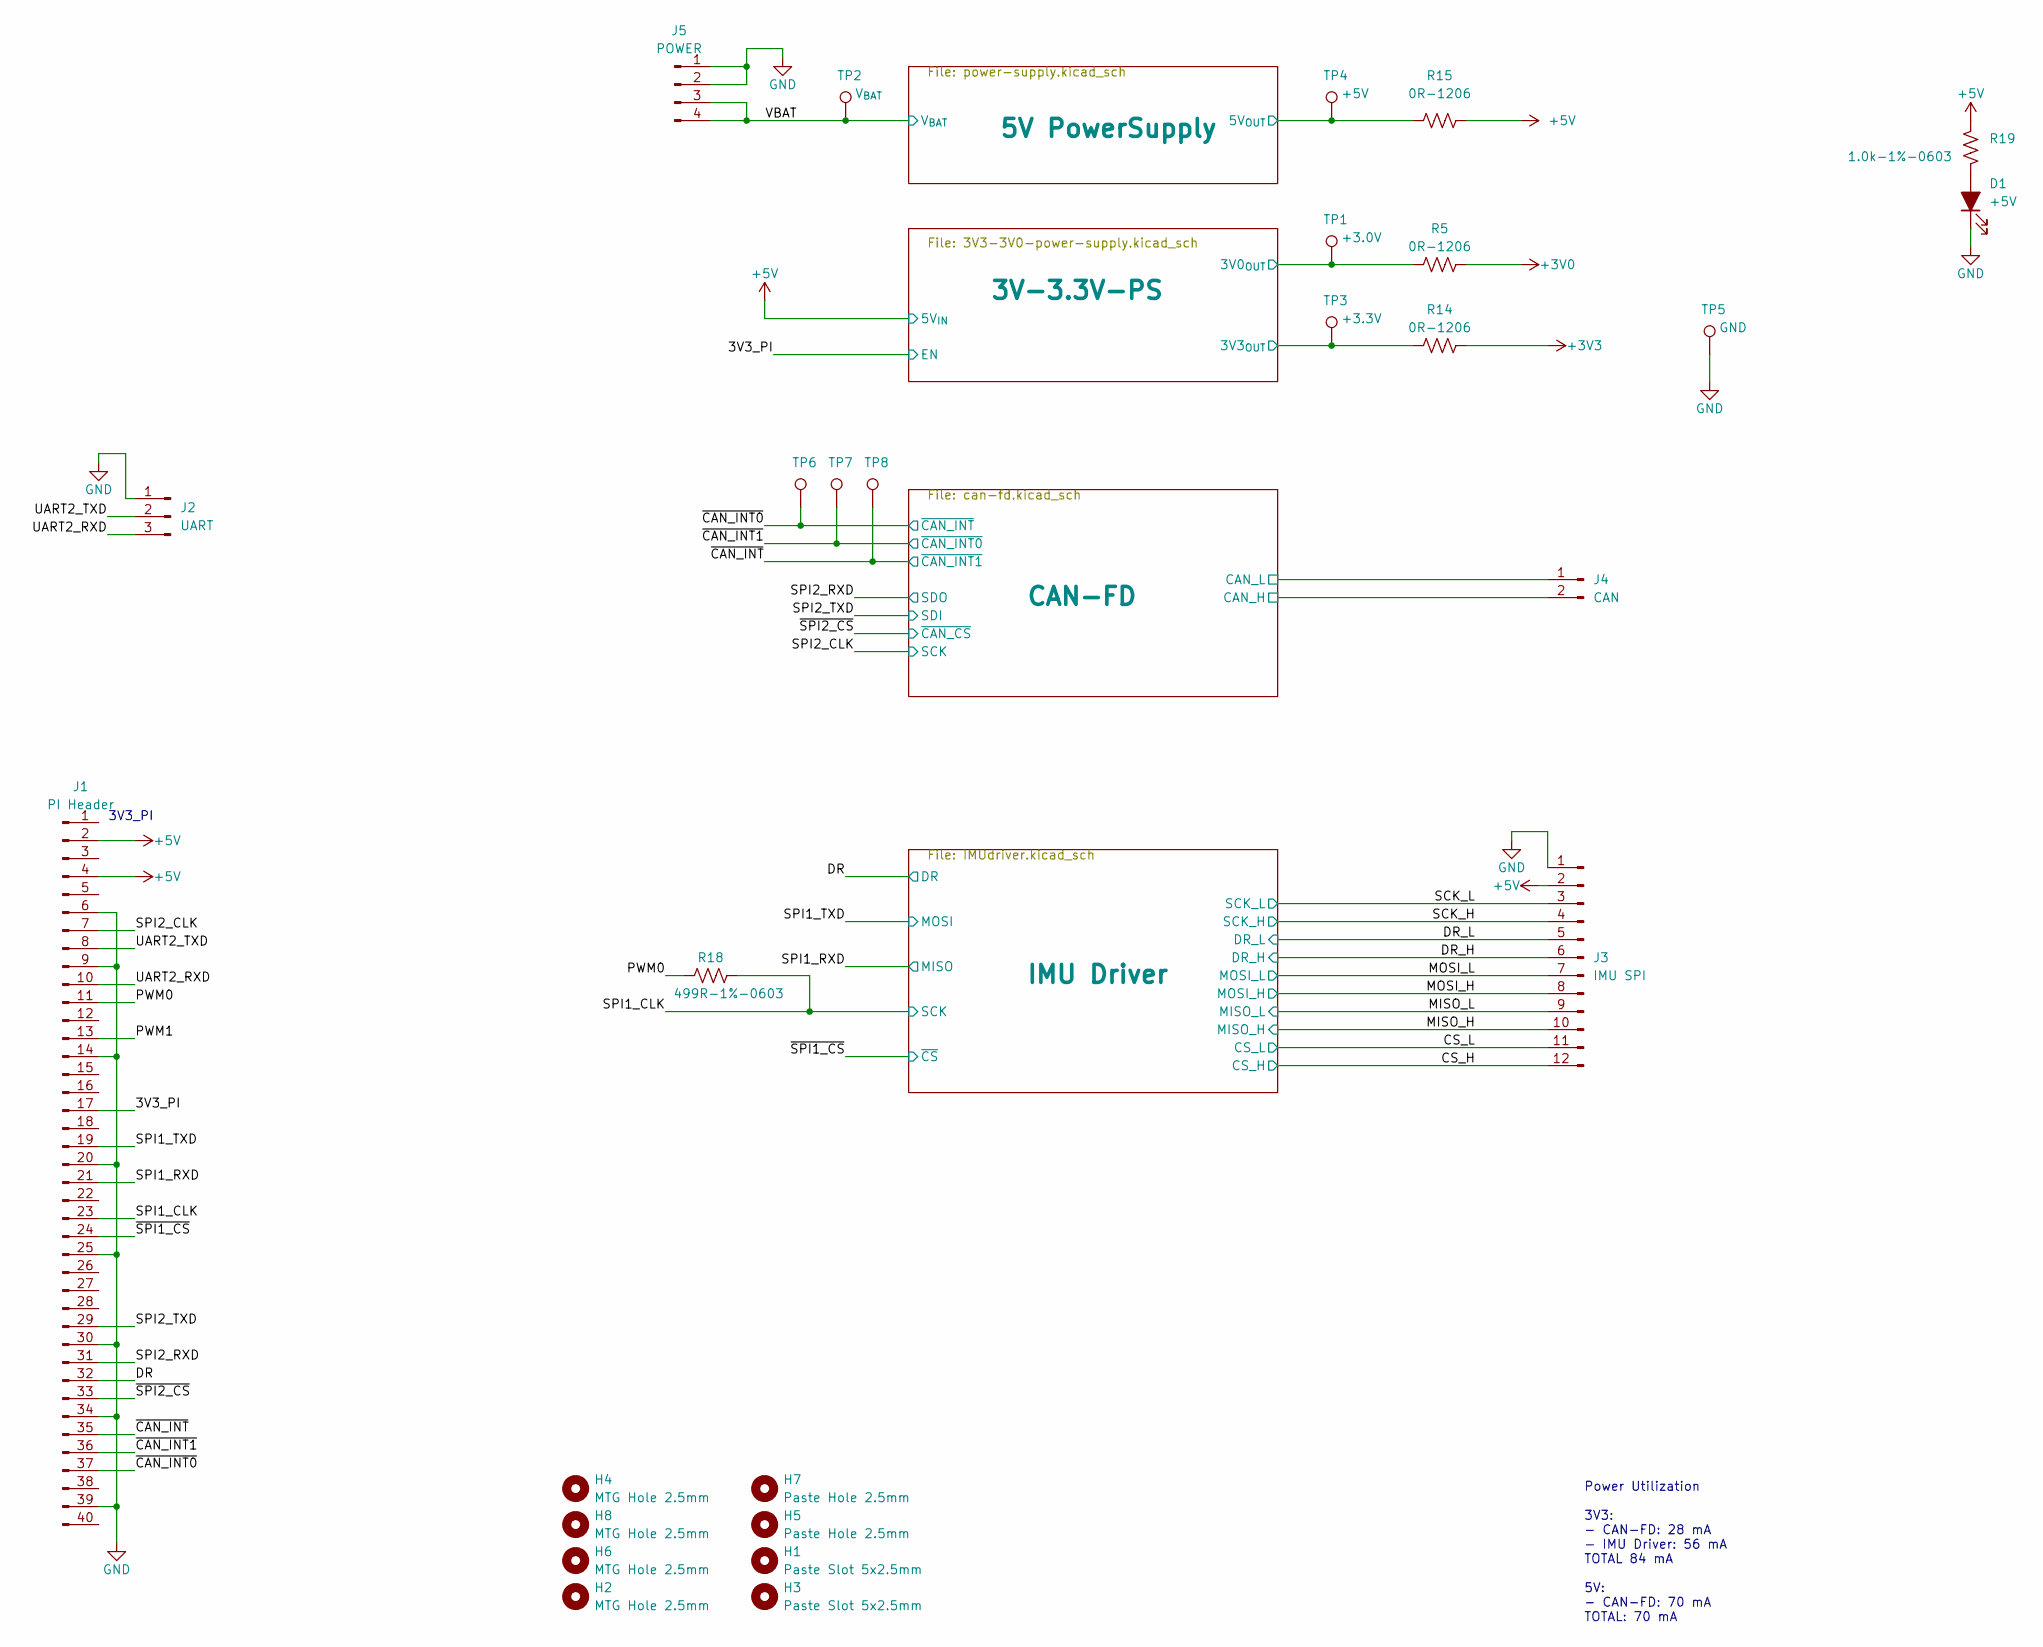
[picture p52: schematic PI-Power-Board.kicad_sch, Pi Power Board 2]

Parts:
D1: +5V; LED_1206_3216Metric; MFG P/N QTLP650D4TR
H1, H3: Paste Slot 5x2.5mm; PASTE-SLOT-5x2.5mm
H2, H4, H6, H8: MTG Hole 2.5mm; MountingHole_2.5mm
H5, H7: Paste Hole 2.5mm; PASTE-HOLE-2.5mm
J1: PI Header; M20-782045; MFG P/N M20-7812045
J2: UART; 70555-0002; MFG P/N 70555-0002
J3: IMU SPI; 70555-0011; MFG P/N 70555-0011
J4: CAN; 70555-0001; MFG P/N 70555-0001
J5: POWER; 70555-0003; MFG P/N 70555-0003
R5, R14, R15: 0R-1206; R_1206_3216Metric; MFG P/N RC1206JR-070RL
R18: 499R-1%-0603; R_0603_1608Metric; MFG P/N RC0603FR-07499RL
R19: 1.0k-1%-0603; R_0603_1608Metric; MFG P/N RC0603FR-071KL
TP1: +3.0V; TestPoint_Keystone_5000-5004_Miniature; MFG P/N 5002
TP2: V_{BAT}; TestPoint_Keystone_5000-5004_Miniature; MFG P/N 5002
TP3, TP6, TP7, TP8: +3.3V; TestPoint_Keystone_5000-5004_Miniature; MFG P/N 5002
TP4: +5V; TestPoint_Keystone_5000-5004_Miniature; MFG P/N 5002
TP5: GND; TestPoint_Keystone_5000-5004_Miniature; MFG P/N 5002

Connections:
+3V0: R5.2; also elsewhere on the board
+3V3: R14.2; also elsewhere on the board
+5V: J1.2, J1.4, J3.2, R15.2, R19.2; also elsewhere on the board
/3V3_PI: J1.17; also elsewhere on the board
/3V-3.3V-PS/3V0_{OUT}: R5.1, TP1.1; also elsewhere on the board
/3V-3.3V-PS/3V3_{OUT}: R14.1, TP3.1; also elsewhere on the board
/5V PowerSupply/V_{OSNS}: R15.1, TP4.1; also elsewhere on the board
/CAN-FD/CAN_H: J4.2; also elsewhere on the board
/CAN-FD/CAN_L: J4.1; also elsewhere on the board
/CS_H: J3.12; also elsewhere on the board
/CS_L: J3.11; also elsewhere on the board
/DR: J1.32; also elsewhere on the board
/DR_H: J3.6; also elsewhere on the board
/DR_L: J3.5; also elsewhere on the board
/MISO_H: J3.10; also elsewhere on the board
/MISO_L: J3.9; also elsewhere on the board
/MOSI_H: J3.8; also elsewhere on the board
/MOSI_L: J3.7; also elsewhere on the board
/PWM0: J1.11, R18.1
/PWM1: J1.13
/SCK_H: J3.4; also elsewhere on the board
/SCK_L: J3.3; also elsewhere on the board
/SPI1_CLK: J1.23, R18.2; also elsewhere on the board
/SPI1_RXD: J1.21; also elsewhere on the board
/SPI1_TXD: J1.19; also elsewhere on the board
/SPI2_CLK: J1.7; also elsewhere on the board
/SPI2_RXD: J1.31; also elsewhere on the board
/SPI2_TXD: J1.29; also elsewhere on the board
/UART2_RXD: J1.10, J2.3
/UART2_TXD: J1.8, J2.2
/VBAT: J5.3, J5.4, TP2.1; also elsewhere on the board
/~CAN_INT0: J1.37, TP6.1; also elsewhere on the board
/~CAN_INT1: J1.36, TP7.1; also elsewhere on the board
/~CAN_INT: J1.35, TP8.1; also elsewhere on the board
/~SPI1_CS: J1.24; also elsewhere on the board
/~SPI2_CS: J1.33; also elsewhere on the board
GND: D1.1 (K), J1.6, J1.9, J1.14, J1.20, J1.25, J1.30, J1.34, J1.39, J2.1, J3.1, J5.1, J5.2, TP5.1; also elsewhere on the board
unnamed: D1.2 (A), R19.1

Notes on the sheet:
3V3_PI
Power Utilization 3V3: - CAN-FD: 28 mA - IMU Driver: 56 mA TOTAL 84 mA 5V: - CAN-FD: 70 mA TOTAL: 70 mA

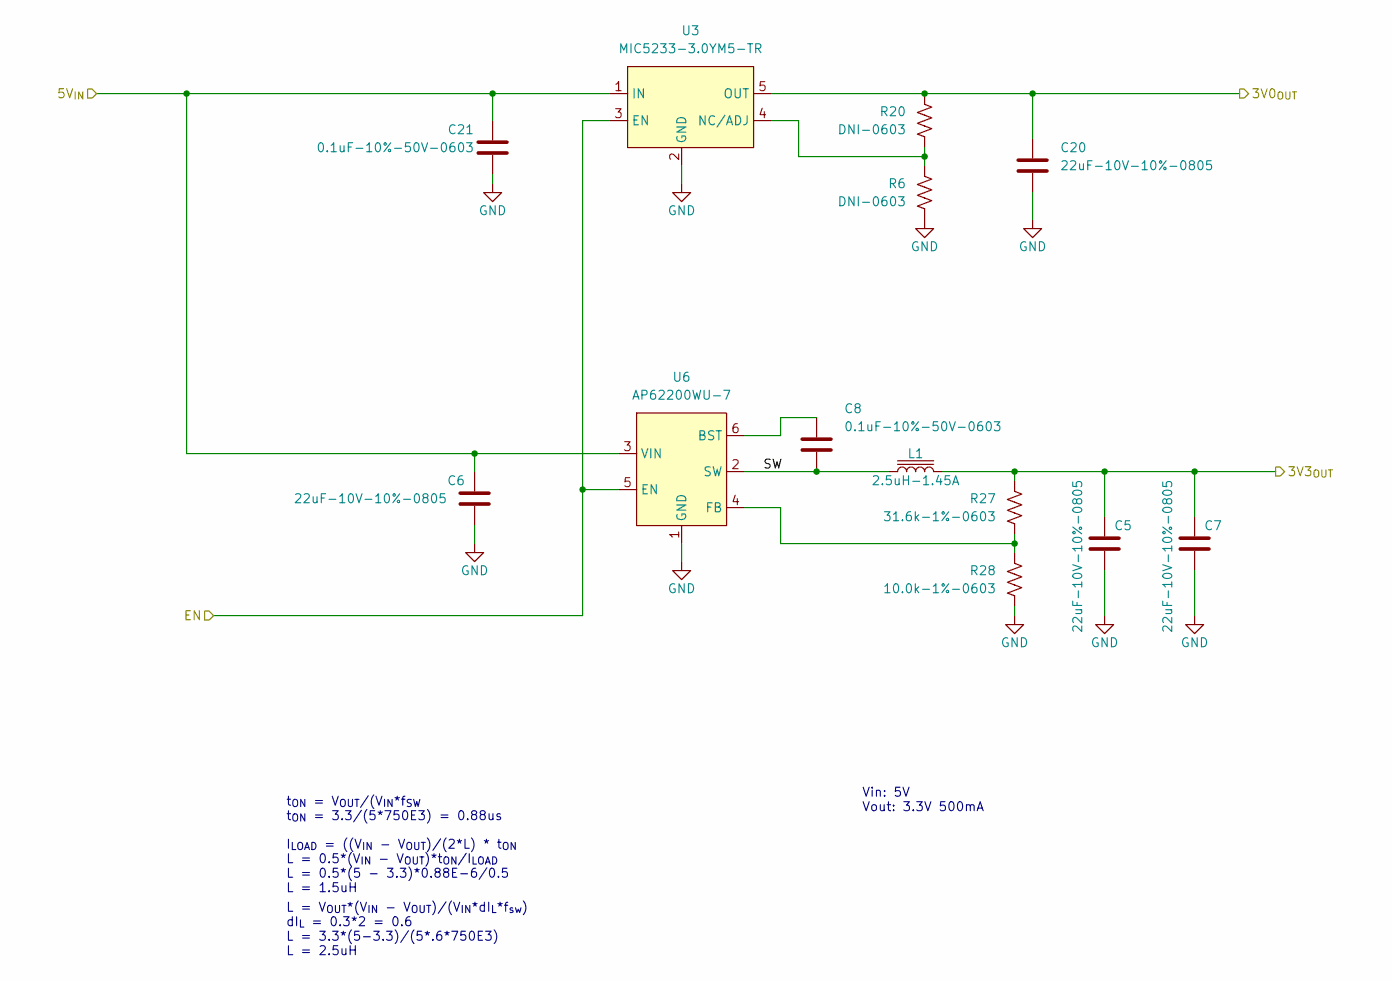
[picture p53: schematic 3V3-3V0-power-supply.kicad_sch, Pi Power Board 2]

Parts:
C5, C6, C7, C20: 22uF-10V-10%-0805; C_0805_2012Metric; MFG P/N CL21A226KPCLRNC
C8, C21: 0.1uF-10%-50V-0603; C_0603_1608Metric; MFG P/N CL10B104KB8NNNC
L1: 2.5uH-1.45A; WE-TPC-744031002; MFG P/N 744031002
R6, R20: DNI-0603; R_0603_1608Metric
R27: 31.6k-1%-0603; R_0603_1608Metric; MFG P/N RMCF0603FT31K6
R28: 10.0k-1%-0603; R_0603_1608Metric; MFG P/N RC0603FR-0710KL
U3: MIC5233-3.0YM5-TR; SOT-23-5; MFG P/N MIC5233-3.0YM5-TR
U6: AP62200WU-7; TSOT-23-6; MFG P/N AP62200WU-7

Connections:
+5V: C6.1, C21.1, U3.1 (IN), U6.3 (VIN); also elsewhere on the board
/3V3_PI: U3.3 (EN), U6.5 (EN); also elsewhere on the board
/3V-3.3V-PS/3V0_{OUT}: C20.1, R20.1, U3.5 (OUT); also elsewhere on the board
/3V-3.3V-PS/3V3_{OUT}: C5.1, C7.1, L1.2, R27.1; also elsewhere on the board
/3V-3.3V-PS/SW: C8.2, L1.1, U6.2 (SW)
GND: C5.2, C6.2, C7.2, C20.2, C21.2, R6.2, R28.2, U3.2 (GND), U6.1 (GND); also elsewhere on the board
unnamed: C8.1, U6.6 (BST)
unnamed: R6.1, R20.2, U3.4 (NC/ADJ)
unnamed: R27.2, R28.1, U6.4 (FB)

Notes on the sheet:
Vin: 5V Vout: 3.3V 500mA
I_{LOAD} = ((V_{IN} - V_{OUT})/(2*L) * t_{ON} L = 0.5*(V_{IN} - V_{OUT})*t_{ON}/I_{LOAD} L = 0.5*(5 - 3.3)*0.88E-6/0.5 L = 1.5uH
L = V_{OUT}*(V_{IN} - V_{OUT})/(V_{IN}*dI_{L}*f_{sw}) dI_{L} = 0.3*2 = 0.6 L = 3.3*(5-3.3)/(5*.6*750E3) L = 2.5uH
t_{ON} = V_{OUT}/(V_{IN}*f_{SW} t_{ON} = 3.3/(5*750E3) = 0.88us

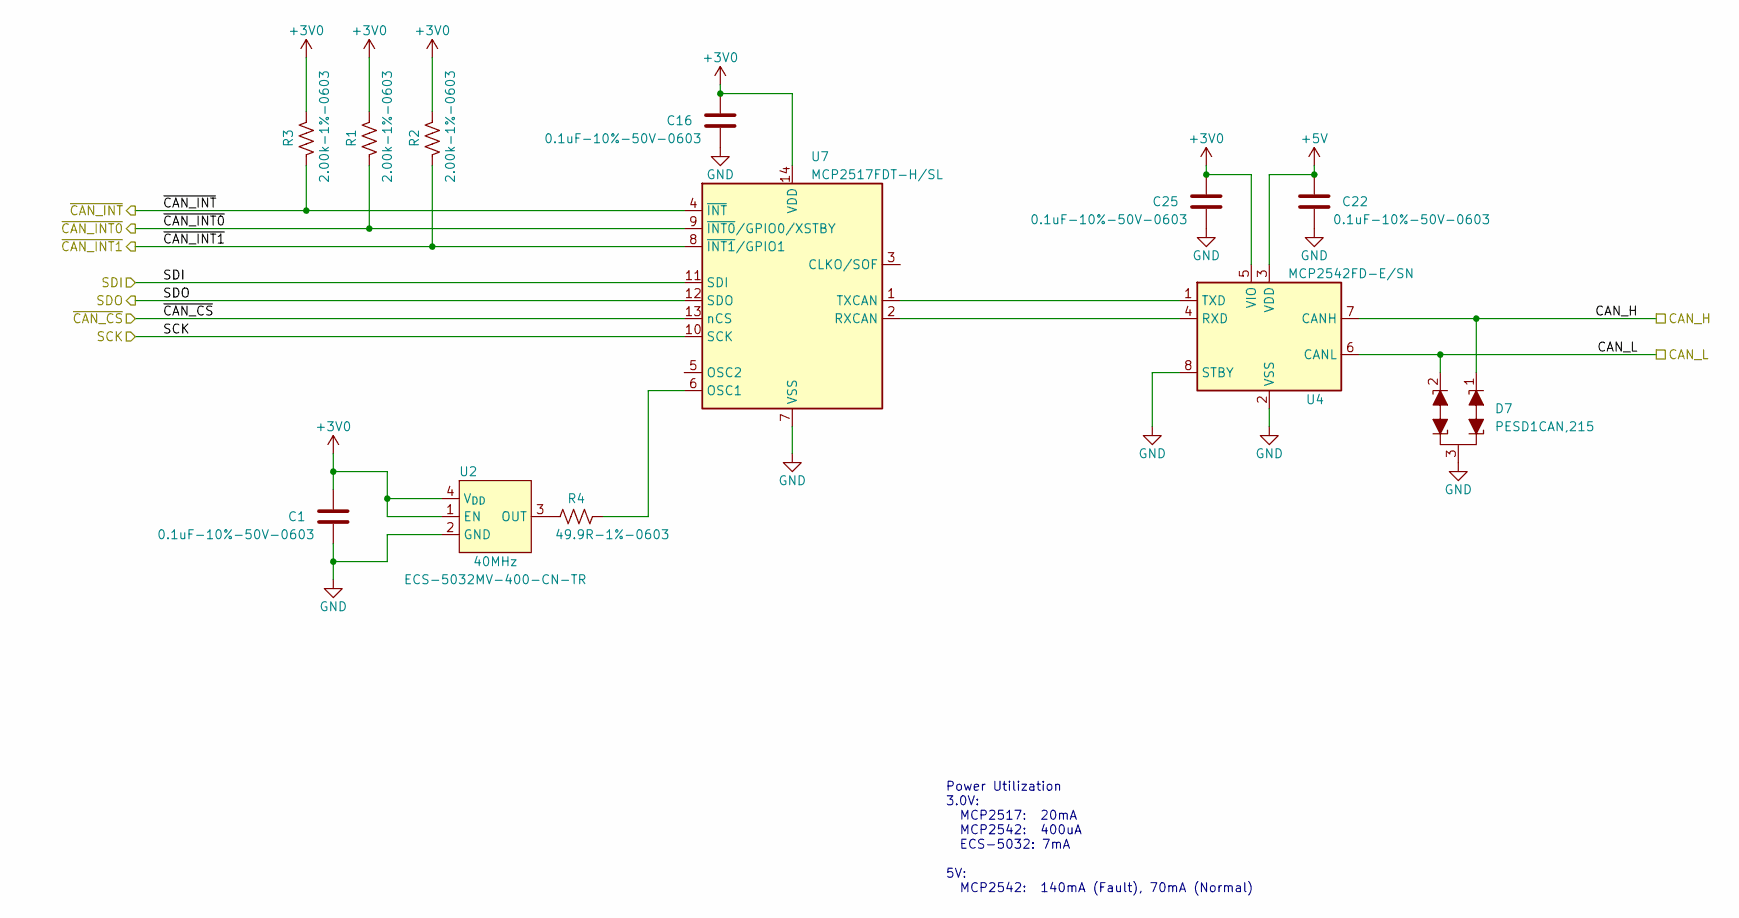
[picture p54: schematic can-fd.kicad_sch, Pi Power Board 2]

Parts:
C1, C16, C22, C25: 0.1uF-10%-50V-0603; C_0603_1608Metric; MFG P/N CL10B104KB8NNNC
D7: PESD1CAN; SOT-23; MFG P/N PESD1CAN,215
R1, R2, R3: 2.00k-1%-0603; R_0603_1608Metric; MFG P/N RC0603FR-072KL
R4: 49.9R-1%-0603; R_0603_1608Metric; MFG P/N RC0603FR-0749R9L
U2: 40MHz; ECS-5032MV; MFG P/N ECS-5032MV-400-CN-TR
U4: MCP2542FD-E/SN; SO-8_3.9x4.9mm_P1.27mm; MFG P/N MCP2542FD-E/SN
U7: MCP2517FDT-H/SL; SOIC-14_3.9x8.7mm_P1.27mm; MFG P/N MCP2517FDT-H/SL

Connections:
+3V0: C1.1, C16.1, C25.1, R1.1, R2.1, R3.1, U2.1 (EN), U2.4 (V_{DD}), U4.5 (VIO), U7.14 (VDD); also elsewhere on the board
+5V: C22.1, U4.3 (VDD); also elsewhere on the board
/CAN-FD/CAN_H: D7.1 (K1), U4.7 (CANH); also elsewhere on the board
/CAN-FD/CAN_L: D7.2 (K1), U4.6 (CANL); also elsewhere on the board
/SPI2_CLK: U7.10 (SCK); also elsewhere on the board
/SPI2_RXD: U7.12 (SDO); also elsewhere on the board
/SPI2_TXD: U7.11 (SDI); also elsewhere on the board
/~CAN_INT0: R3.2, U7.4 (~INT); also elsewhere on the board
/~CAN_INT1: R1.2, U7.9 (~INT0/GPIO0/XSTBY); also elsewhere on the board
/~CAN_INT: R2.2, U7.8 (~INT1/GPIO1); also elsewhere on the board
/~SPI2_CS: U7.13 (nCS); also elsewhere on the board
GND: C1.2, C16.2, C22.2, C25.2, D7.3 (KK), U2.2 (GND), U4.2 (VSS), U4.8 (STBY), U7.7 (VSS); also elsewhere on the board
unnamed: R4.1, U2.3 (OUT)
unnamed: R4.2, U7.6 (OSC1)
unnamed: U4.1 (TXD), U7.1 (TXCAN)
unnamed: U4.4 (RXD), U7.2 (RXCAN)

Notes on the sheet:
Power Utilization 3.0V: MCP2517: 20mA MCP2542: 400uA ECS-5032: 7mA 5V: MCP2542: 140mA (Fault), 70mA (Normal)

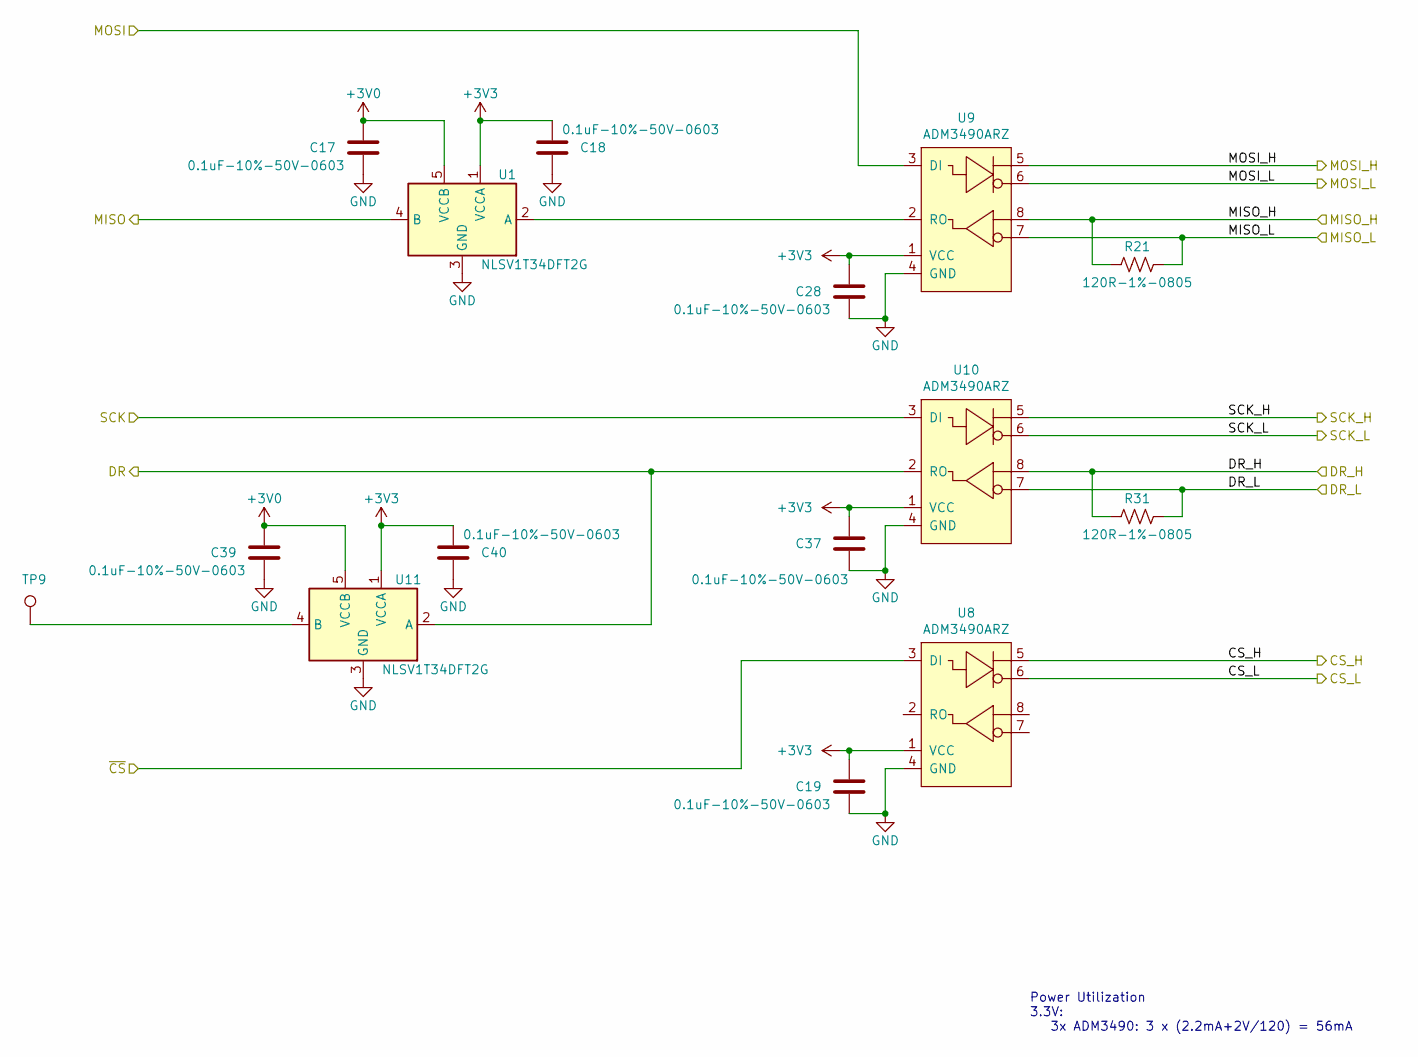
[picture p55: schematic IMUdriver.kicad_sch, Pi Power Board 2]

Parts:
C17, C18, C19, C28, C37, C39, C40: 0.1uF-10%-50V-0603; C_0603_1608Metric; MFG P/N CL10B104KB8NNNC
R21, R31: 120R-1%-0805; R_0805_2012Metric; MFG P/N RMCF0805FT120R
TP9: +3.3V; TestPoint_Keystone_5000-5004_Miniature; MFG P/N 5002
U1, U11: NLSV1T34DFT2G; SOT-353_SC-70-5; MFG P/N NLSV1T34DFT2G
U8, U9, U10: ADM3490ARZ; SO-8_3.9x4.9mm_P1.27mm; MFG P/N ADM3490ARZ

Connections:
+3V0: C17.1, C39.1, U1.5 (VCCB), U11.5 (VCCB); also elsewhere on the board
+3V3: C18.1, C19.1, C28.1, C37.1, C40.1, U1.1 (VCCA), U8.1 (VCC), U9.1 (VCC), U10.1 (VCC), U11.1 (VCCA); also elsewhere on the board
/CS_H: U8.5; also elsewhere on the board
/CS_L: U8.6; also elsewhere on the board
/DR: U10.2 (RO), U11.2 (A); also elsewhere on the board
/DR_H: R31.1, U10.8; also elsewhere on the board
/DR_L: R31.2, U10.7; also elsewhere on the board
/MISO_H: R21.1, U9.8; also elsewhere on the board
/MISO_L: R21.2, U9.7; also elsewhere on the board
/MOSI_H: U9.5; also elsewhere on the board
/MOSI_L: U9.6; also elsewhere on the board
/SCK_H: U10.5; also elsewhere on the board
/SCK_L: U10.6; also elsewhere on the board
/SPI1_CLK: U10.3 (DI); also elsewhere on the board
/SPI1_RXD: U1.4 (B); also elsewhere on the board
/SPI1_TXD: U9.3 (DI); also elsewhere on the board
/~SPI1_CS: U8.3 (DI); also elsewhere on the board
GND: C17.2, C18.2, C19.2, C28.2, C37.2, C39.2, C40.2, U1.3 (GND), U8.4 (GND), U9.4 (GND), U10.4 (GND), U11.3 (GND); also elsewhere on the board
unnamed: TP9.1, U11.4 (B)
unnamed: U1.2 (A), U9.2 (RO)

Notes on the sheet:
Power Utilization 3.3V: 3x ADM3490: 3 x (2.2mA+2V/120) = 56mA

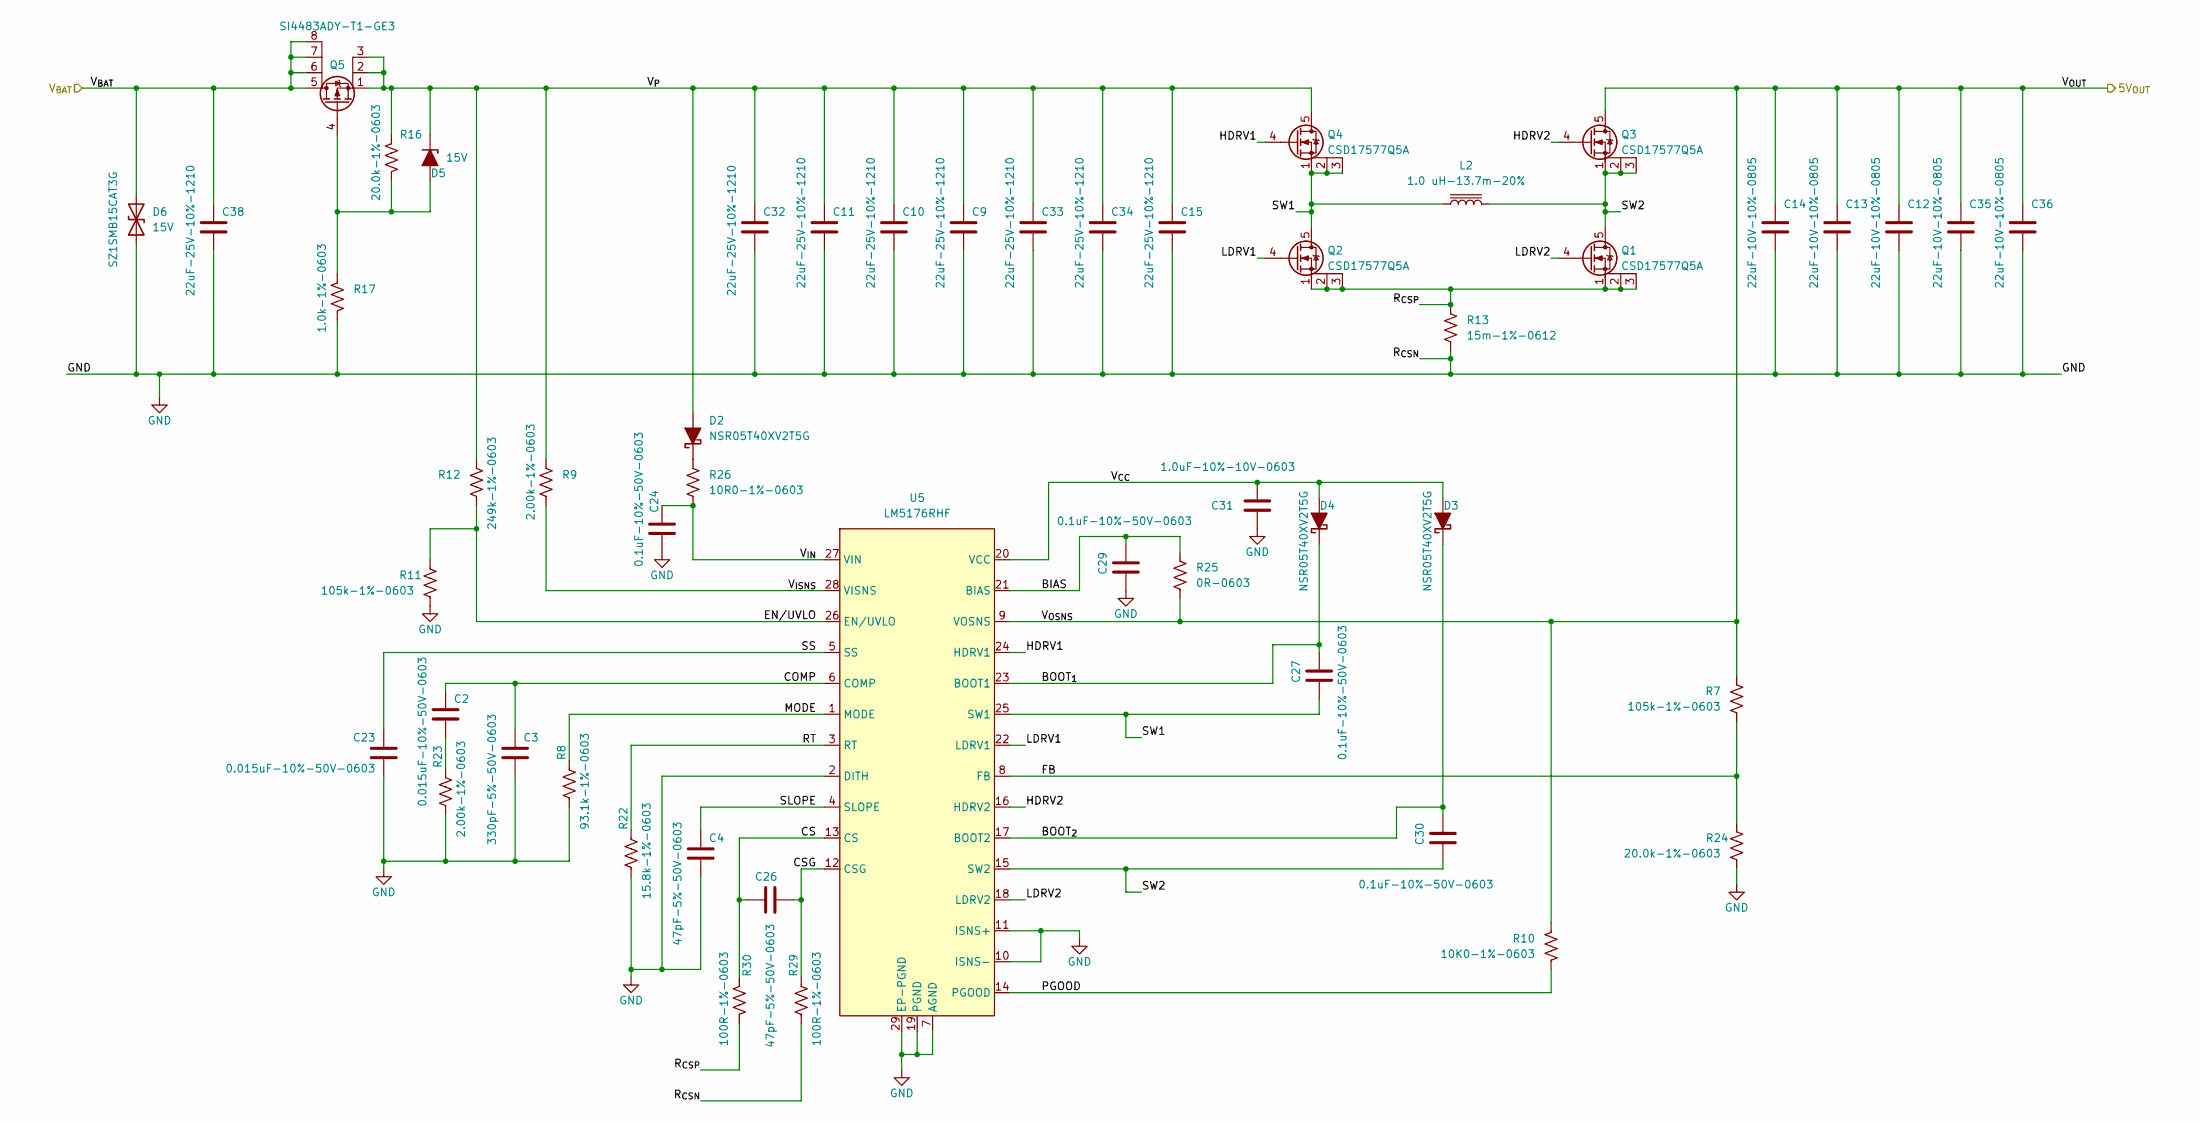
[picture p56: schematic power-supply.kicad_sch, Pi Power Board 2]

Parts:
C2, C23: 0.015uF-10%-50V-0603; C_0603_1608Metric; MFG P/N CC0603KRX7R9BB153
C3: 330pF-5%-50V-0603; C_0603_1608Metric; MFG P/N GCM1885C2A331FA16D
C4, C26: 47pF-5%-50V-0603; C_0603_1608Metric; MFG P/N CL10C470JB8NNNC
C9, C10, C11, C15, C32, C33, C34, C38: 22uF-25V-10%-1210; C_1210_3225Metric; MFG P/N GRM32ER61E226KE15L
C12, C13, C14, C35, C36: 22uF-10V-10%-0805; C_0805_2012Metric; MFG P/N CL21A226KPCLRNC
C24, C27, C29, C30: 0.1uF-10%-50V-0603; C_0603_1608Metric; MFG P/N CL10B104KB8NNNC
C31: 1.0uF-10%-10V-0603; C_0603_1608Metric; MFG P/N CL10B105KP8NNNC
D2, D3, D4: NSR05T40XV2T5G; D_SOD-523; MFG P/N NSR05T40XV2T5G
D5: 15V; D_SOD-123F; MFG P/N BZT52H-C15,115
D6: 15V; D_SMB; MFG P/N SZ1SMB15CAT3G
L2: 1.0 uH-13.7m-20%; IHLP2020CZER; MFG P/N IHLP2020CZER1R0M01
Q1, Q2, Q3, Q4: CSD17577Q5A; TI-SON5x6; MFG P/N CSD17577Q5A
Q5: SI4483ADY-T1-GE3; SOIC-8_3.9x4.9mm_P1.27mm; MFG P/N SI4483ADY-T1-GE3
R7, R11: 105k-1%-0603; R_0603_1608Metric; MFG P/N RC0603FR-07105KL
R8: 93.1k-1%-0603; R_0603_1608Metric; MFG P/N ERJ-3EKF9312V
R9, R23: 2.00k-1%-0603; R_0603_1608Metric; MFG P/N RC0603FR-072KL
R10: 10K0-1%-0603; R_0603_1608Metric; MFG P/N RC0603FR-0710KL
R12: 249k-1%-0603; R_0603_1608Metric; MFG P/N RC0603FR-07249KL
R13: 15m-1%-0612; R_0612_1632Metric; MFG P/N WU732BTTD15L0F
R16, R24: 20.0k-1%-0603; R_0603_1608Metric; MFG P/N RC0603FR-0720KL
R17: 1.0k-1%-0603; R_0603_1608Metric; MFG P/N RC0603FR-071KL
R22: 15.8k-1%-0603; R_0603_1608Metric; MFG P/N RC0603FR-0715K8L
R25: 0R-0603; R_0603_1608Metric; MFG P/N RMCF0603ZT0R00
R26: 10R0-1%-0603; R_0603_1608Metric; MFG P/N RC0603FR-0710RL
R29, R30: 100R-1%-0603; R_0603_1608Metric; MFG P/N RC0603FR-07100RL
U5: LM5176RHF; QFN-28-1EP_4x5mm_P0.5mm_EP2.55x3.55mm_ThermalVias; MFG P/N LM5176RHFT

Connections:
/5V PowerSupply/BIAS: C29.1, R25.1, U5.21 (BIAS)
/5V PowerSupply/BOOT_{1}: C27.1, D4.1 (K), U5.23 (BOOT1)
/5V PowerSupply/BOOT_{2}: C30.1, D3.1 (K), U5.17 (BOOT2)
/5V PowerSupply/COMP: C2.1, C3.1, U5.6 (COMP)
/5V PowerSupply/CS: C26.1, R30.1, U5.13 (CS)
/5V PowerSupply/CSG: C26.2, R29.1, U5.12 (CSG)
/5V PowerSupply/EN/UVLO: R11.1, R12.2, U5.26 (EN/UVLO)
/5V PowerSupply/FB: R7.2, R24.1, U5.8 (FB)
/5V PowerSupply/HDRV1: Q4.4 (G), U5.24 (HDRV1)
/5V PowerSupply/HDRV2: Q3.4 (G), U5.16 (HDRV2)
/5V PowerSupply/LDRV1: Q2.4 (G), U5.22 (LDRV1)
/5V PowerSupply/LDRV2: Q1.4 (G), U5.18 (LDRV2)
/5V PowerSupply/MODE: R8.1, U5.1 (MODE)
/5V PowerSupply/PGOOD: R10.2, U5.14 (PGOOD)
/5V PowerSupply/RT: R22.1, U5.3 (RT)
/5V PowerSupply/R_{CSP}: Q1.1 (S), Q1.2 (S), Q1.3 (S), Q2.1 (S), Q2.2 (S), Q2.3 (S), R13.1, R30.2
/5V PowerSupply/SLOPE: C4.1, U5.4 (SLOPE)
/5V PowerSupply/SS: C23.1, U5.5 (SS)
/5V PowerSupply/SW1: C27.2, L2.1, Q2.5 (D), Q4.1 (S), Q4.2 (S), Q4.3 (S), U5.25 (SW1)
/5V PowerSupply/SW2: C30.2, L2.2, Q1.5 (D), Q3.1 (S), Q3.2 (S), Q3.3 (S), U5.15 (SW2)
/5V PowerSupply/V_{CC}: C31.1, D3.2 (A), D4.2 (A), U5.20 (VCC)
/5V PowerSupply/V_{IN}: C24.1, R26.2, U5.27 (VIN)
/5V PowerSupply/V_{ISNS}: R9.2, U5.28 (VISNS)
/5V PowerSupply/V_{OSNS}: C12.1, C13.1, C14.1, C35.1, C36.1, Q3.5 (D), R7.1, R10.1, R25.2, U5.9 (VOSNS); also elsewhere on the board
/5V PowerSupply/V_{P}: C9.2, C10.2, C11.2, C15.2, C32.2, C33.2, C34.2, D2.2 (A), D5.1 (K), Q4.5 (D), Q5.1 (S), Q5.2 (S), Q5.3 (S), R9.1, R12.1, R16.2
/VBAT: C38.2, D6.2 (A2), Q5.5 (D), Q5.6 (D), Q5.7 (D), Q5.8 (D); also elsewhere on the board
GND: C3.2, C4.2, C9.1, C10.1, C11.1, C12.2, C13.2, C14.2, C15.1, C23.2, C24.2, C29.2, C31.2, C32.1, C33.1, C34.1, C35.2, C36.2, C38.1, D6.1 (A1), R8.2, R11.2, R13.2, R17.1, R22.2, R23.2, R24.2, R29.2, U5.2 (DITH), U5.7 (AGND), U5.10 (ISNS-), U5.11 (ISNS+), U5.19 (PGND), U5.29 (EP-PGND); also elsewhere on the board
unnamed: C2.2, R23.1
unnamed: D2.1 (K), R26.1
unnamed: D5.2 (A), Q5.4 (G), R16.1, R17.2

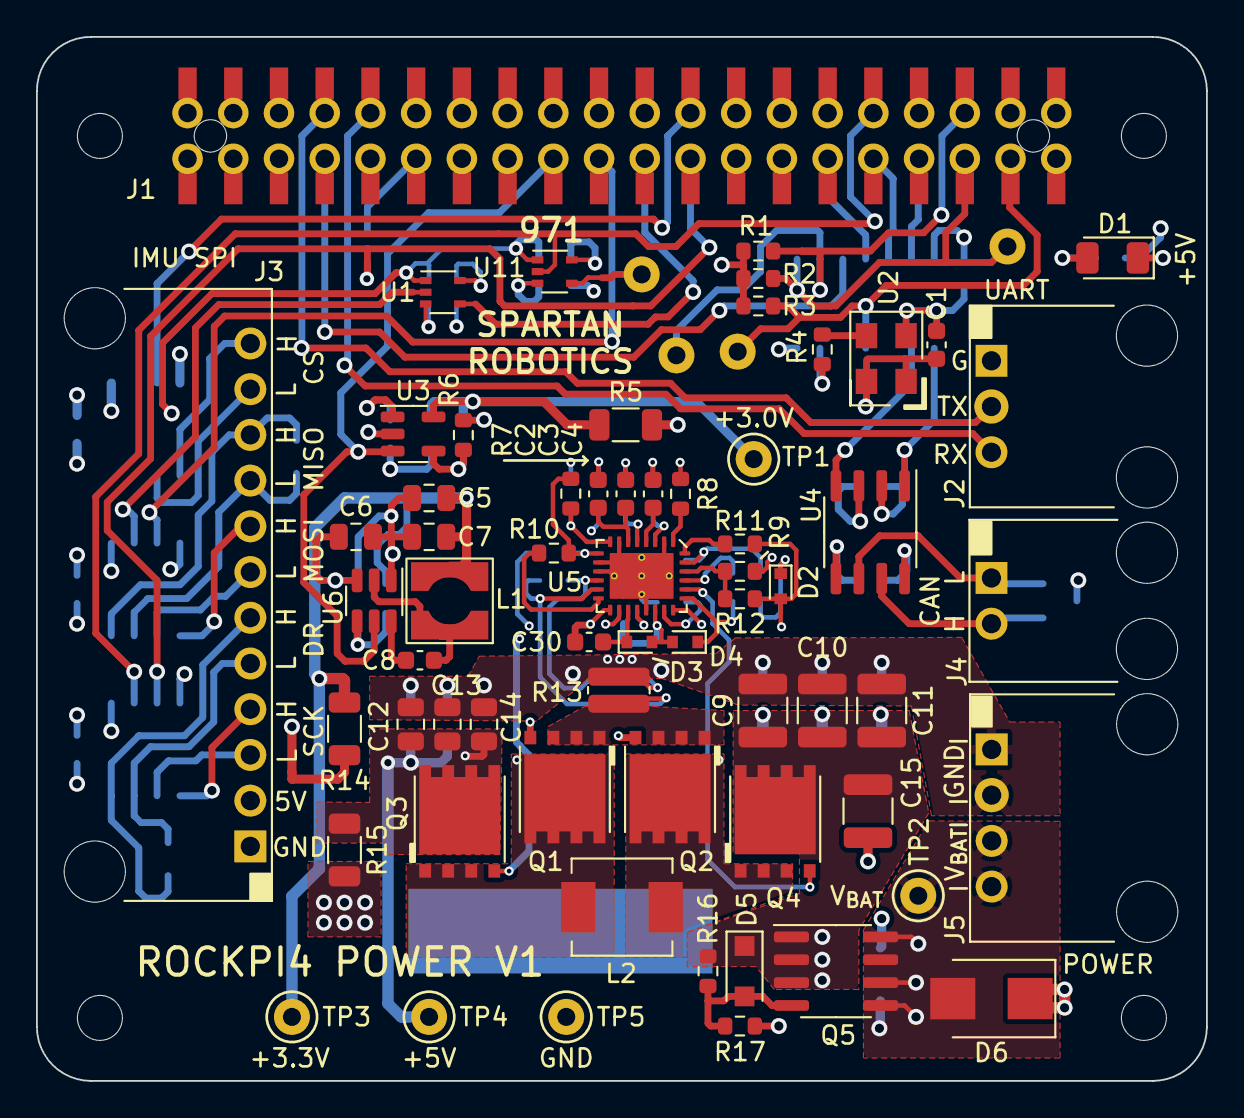
[picture p57: board PI-Power-Board.kicad_pcb from above]

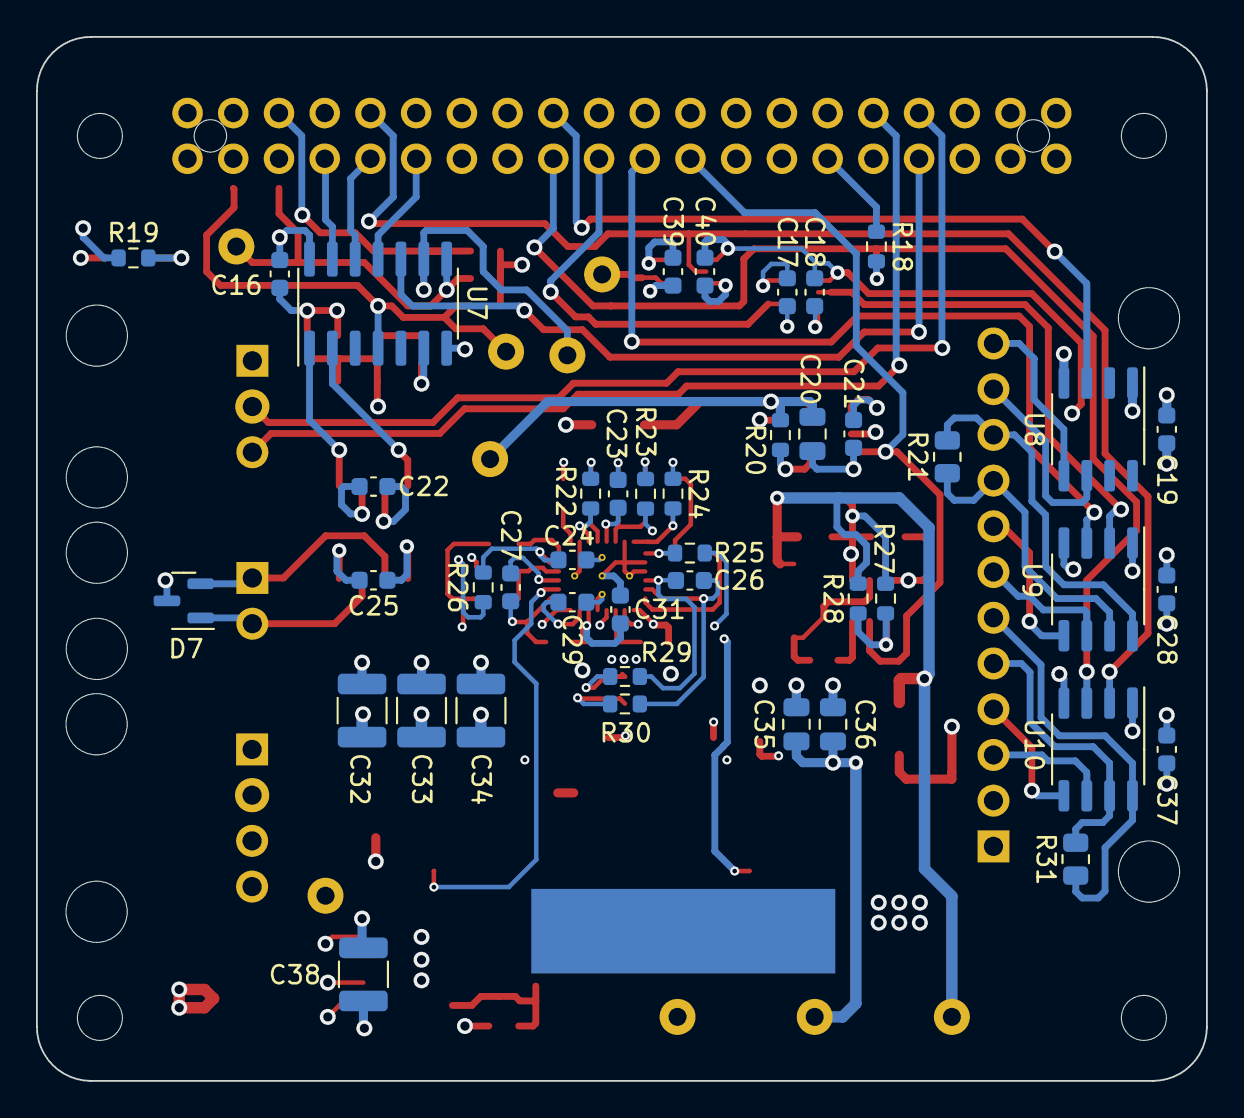
[picture p58: board PI-Power-Board.kicad_pcb from below]

Board: 4 copper layers, 65.0 x 58.0 mm, 118 parts (43 on the bottom side), 74 nets.
