frc971/971-Robot-Code/circuit_boards/connector_boards/encoder_adapter/encoder_adapter.kicad_pcb

## KiCad design circuit_boards/connector_boards/encoder_adapter/encoder_adapter.kicad_pcb (2022-10-15, last stored version)

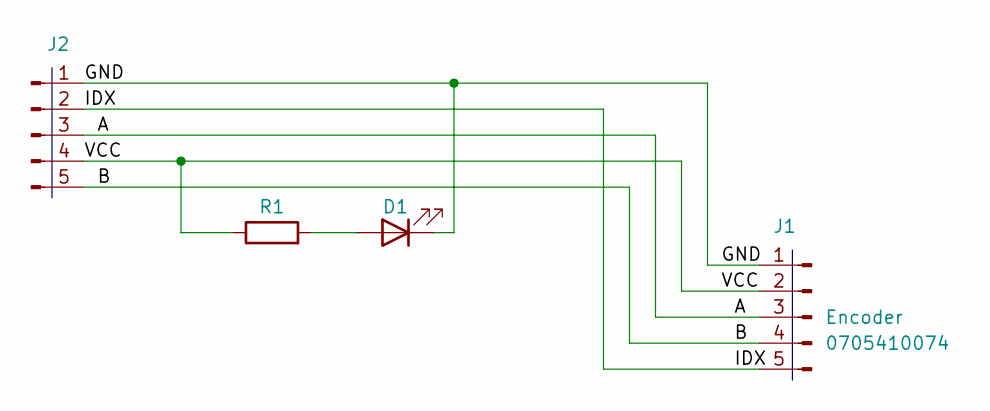
[picture p61: schematic encoder_adapter.kicad_sch, Shaft Encoder Adapter PCB]

Parts:
D1: LED; LED_1206_3216Metric; MFG P/N QTLP650D4TR
J1: Encoder; MOLEX_0705410074; MFG P/N 0705410074
J2: Conn_01x05_Male; PinHeader_1x05_P2.54mm_Vertical
R1: R; R_0805_2012Metric

Connections:
/A: J1.3, J2.3
/B: J1.4, J2.5
/GND: D1.1 (K), J1.1, J2.1
/IDX: J1.5, J2.2
/VCC: J1.2, J2.4, R1.1
unnamed: D1.2 (A), R1.2
