frc971/971-Robot-Code/circuit_boards/connector_boards/encoder_adapter/encoder_adapter.kicad_pcb

## KiCad design circuit_boards/connector_boards/encoder_adapter/encoder_adapter.kicad_pcb (continued)

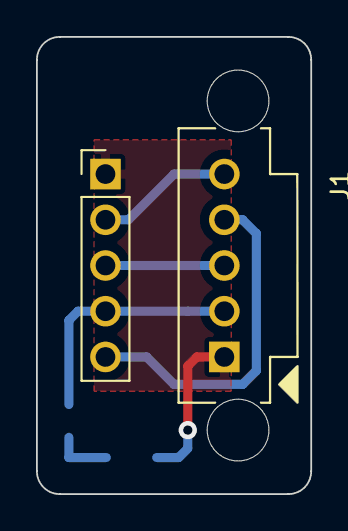
[picture p62: board encoder_adapter.kicad_pcb from above]

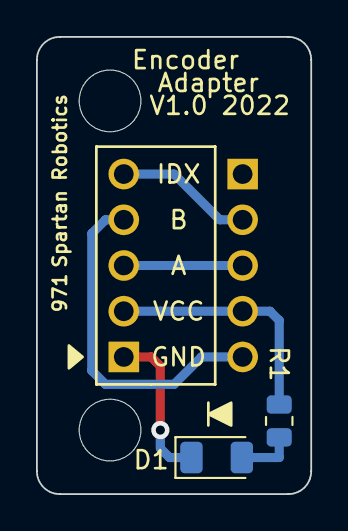
[picture p63: board encoder_adapter.kicad_pcb from below]

Board: 2 copper layers, 15.2 x 25.4 mm, 4 parts (2 on the bottom side), 6 nets.
