frc971/971-Robot-Code/roborio_expansion_boards/analog_adapter.brd

## EAGLE design roborio_expansion_boards/analog_adapter.brd (2014-08-19, last stored version)

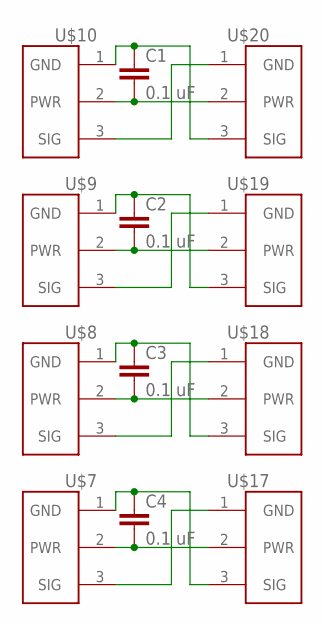
[picture p72: schematic analog_adapter.sch]

Parts:
C1, C2, C3, C4: 0.1 uF; 0603
U$7, U$8, U$9, U$10: 22-23-2031GENERIC; PWM_1X3
U$17, U$18, U$19, U$20: 22-23-2031

Connections:
unnamed: C1.1, U$10.1 (GND), U$20.3 (SIG)
unnamed: C1.2, U$10.2 (PWR), U$20.2 (PWR)
unnamed: U$10.3 (SIG), U$20.1 (GND)
unnamed: C2.2, U$9.2 (PWR), U$19.2 (PWR)
unnamed: U$9.3 (SIG), U$19.1 (GND)
unnamed: C3.2, U$8.2 (PWR), U$18.2 (PWR)
unnamed: U$8.3 (SIG), U$18.1 (GND)
unnamed: C4.2, U$7.2 (PWR), U$17.2 (PWR)
unnamed: U$7.3 (SIG), U$17.1 (GND)
unnamed: C4.1, U$7.1 (GND), U$17.3 (SIG)
unnamed: C3.1, U$8.1 (GND), U$18.3 (SIG)
unnamed: C2.1, U$9.1 (GND), U$19.3 (SIG)

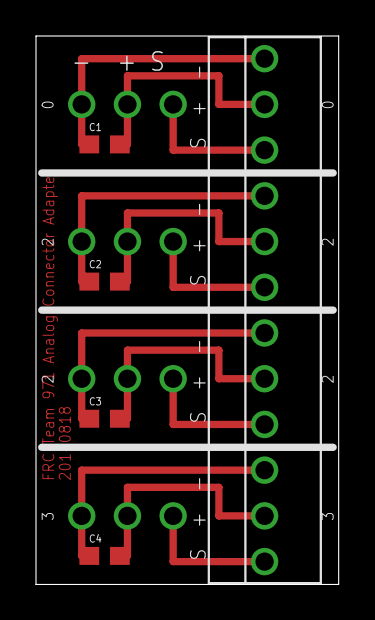
[picture p73: board analog_adapter.brd from above]

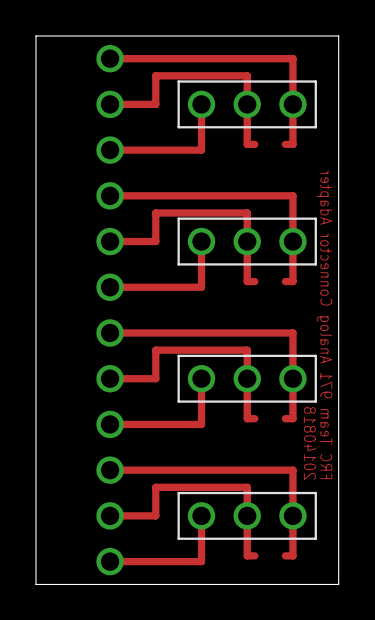
[picture p74: board analog_adapter.brd from below]

Board: 2 copper layers, 16.8 x 30.5 mm, 12 parts (4 on the bottom side), 12 nets.
