frc971/971-Robot-Code/roborio_expansion_boards/expansion_board.brd

## EAGLE design roborio_expansion_boards/expansion_board.brd (2014-08-19, last stored version)

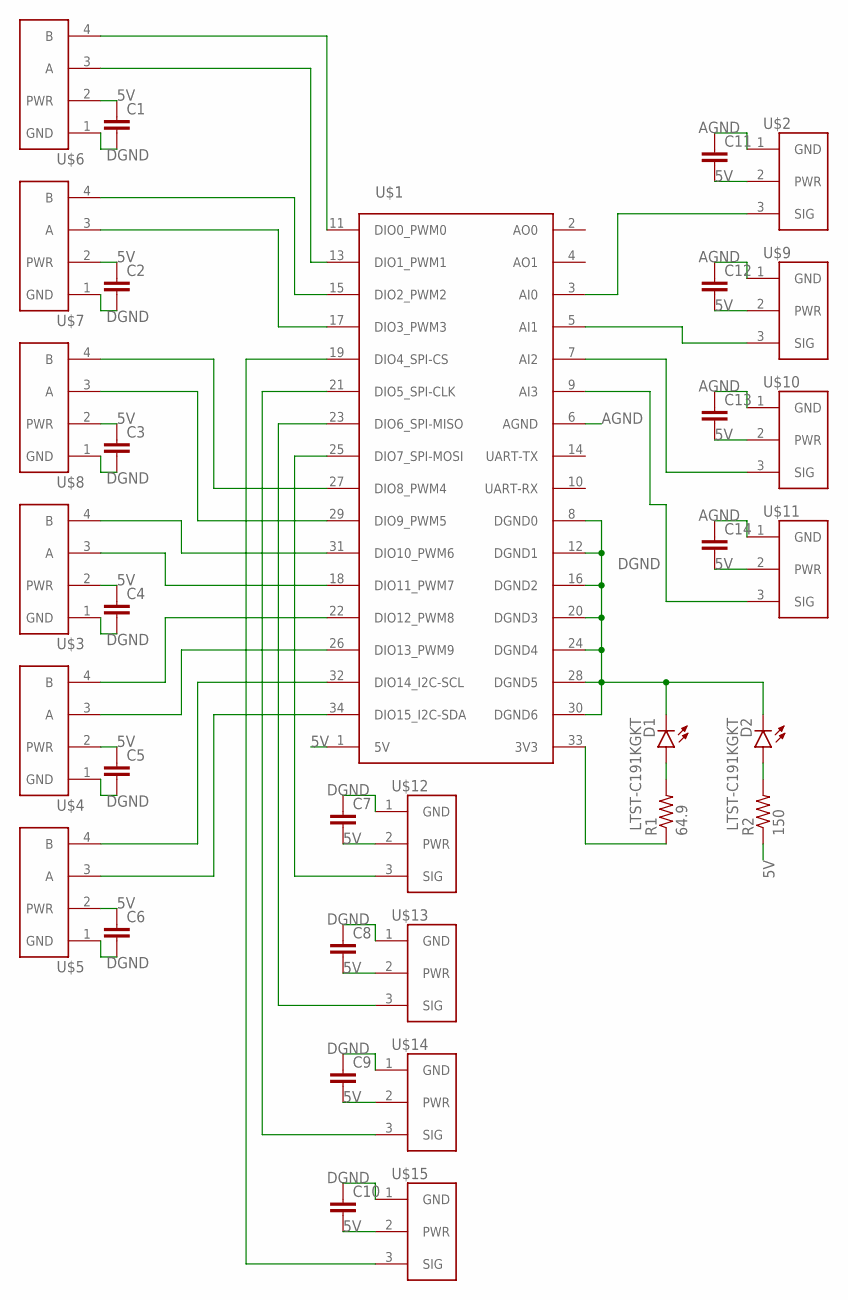
[picture p75: schematic expansion_board.sch]

Parts:
C1, C2, C3, C4, C5, C6, C7, C8, C9, C10, C11, C12, C13, C14: CAP0603; 0603
D1, D2: LTST-C191KGKT; LED-0603
R1: 64.9; 0603-RES
R2: 150; 0603-RES
U$1: MXP; SFH11-PBPC-D17-ST-BK
U$2, U$9, U$10, U$11, U$12, U$13, U$14, U$15: 22-23-2031
U$3, U$4, U$5, U$6, U$7, U$8: 22-23-2041

Connections:
5V: C1.1, C2.1, C3.1, C4.1, C5.1, C6.1, C7.2, C8.2, C9.2, C10.2, C11.2, C12.2, C13.2, C14.2, R2.1, U$1.1 (5V), U$2.2 (PWR), U$3.2 (PWR), U$4.2 (PWR), U$5.2 (PWR), U$6.2 (PWR), U$7.2 (PWR), U$8.2 (PWR), U$9.2 (PWR), U$10.2 (PWR), U$11.2 (PWR), U$12.2 (PWR), U$13.2 (PWR), U$14.2 (PWR), U$15.2 (PWR)
AGND: C11.1, C12.1, C13.1, C14.1, U$1.6 (AGND), U$2.1 (GND), U$9.1 (GND), U$10.1 (GND), U$11.1 (GND)
DGND: C1.2, C2.2, C3.2, C4.2, C5.2, C6.2, C7.1, C8.1, C9.1, C10.1, D1.C, D2.C, U$1.8 (DGND0), U$1.12 (DGND1), U$1.16 (DGND2), U$1.20 (DGND3), U$1.24 (DGND4), U$1.28 (DGND5), U$1.30 (DGND6), U$3.1 (GND), U$4.1 (GND), U$5.1 (GND), U$6.1 (GND), U$7.1 (GND), U$8.1 (GND), U$12.1 (GND), U$13.1 (GND), U$14.1 (GND), U$15.1 (GND)
unnamed: U$1.11 (DIO0_PWM0), U$6.4 (B)
unnamed: U$1.13 (DIO1_PWM1), U$6.3 (A)
unnamed: U$1.15 (DIO2_PWM2), U$7.4 (B)
unnamed: U$1.17 (DIO3_PWM3), U$7.3 (A)
unnamed: U$1.27 (DIO8_PWM4), U$8.4 (B)
unnamed: U$1.29 (DIO9_PWM5), U$8.3 (A)
unnamed: U$1.31 (DIO10_PWM6), U$3.4 (B)
unnamed: U$1.18 (DIO11_PWM7), U$3.3 (A)
unnamed: U$1.22 (DIO12_PWM8), U$4.4 (B)
unnamed: U$1.26 (DIO13_PWM9), U$4.3 (A)
unnamed: U$1.32 (DIO14_I2C-SCL), U$5.4 (B)
unnamed: U$1.34 (DIO15_I2C-SDA), U$5.3 (A)
unnamed: U$1.3 (AI0), U$2.3 (SIG)
unnamed: U$1.5 (AI1), U$9.3 (SIG)
unnamed: U$1.7 (AI2), U$10.3 (SIG)
unnamed: U$1.9 (AI3), U$11.3 (SIG)
unnamed: U$1.25 (DIO7_SPI-MOSI), U$12.3 (SIG)
unnamed: U$1.23 (DIO6_SPI-MISO), U$13.3 (SIG)
unnamed: U$1.21 (DIO5_SPI-CLK), U$14.3 (SIG)
unnamed: U$1.19 (DIO4_SPI-CS), U$15.3 (SIG)
unnamed: D1.A, R1.2
unnamed: R1.1, U$1.33 (3V3)
unnamed: D2.A, R2.2

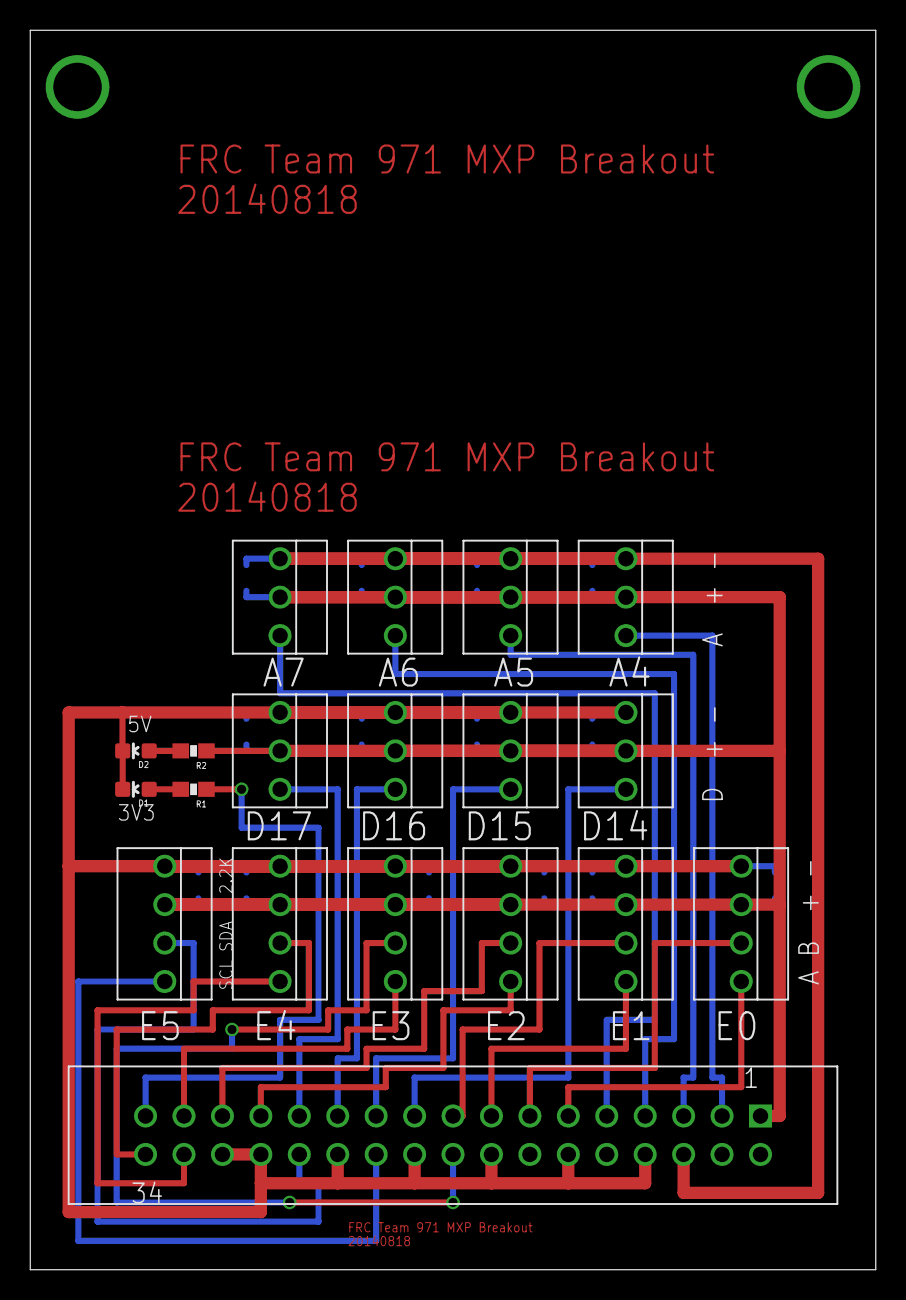
[picture p76: board expansion_board.brd from above]

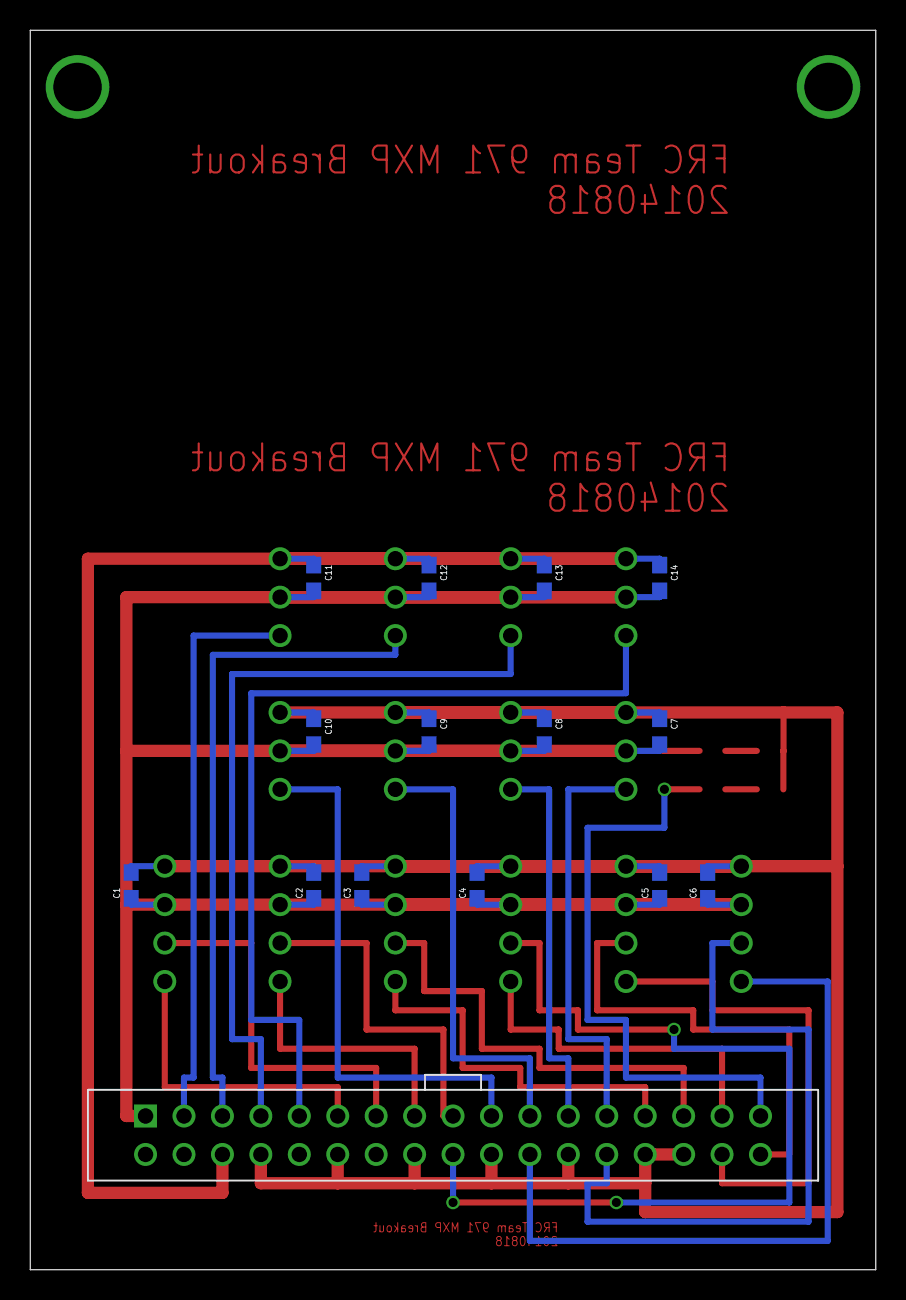
[picture p77: board expansion_board.brd from below]

Board: 2 copper layers, 55.9 x 81.9 mm, 33 parts (14 on the bottom side), 26 nets.
