frc971/971-Robot-Code/roborio_expansion_boards/pwm_adapter.brd

## EAGLE design roborio_expansion_boards/pwm_adapter.brd (2014-08-19, last stored version)

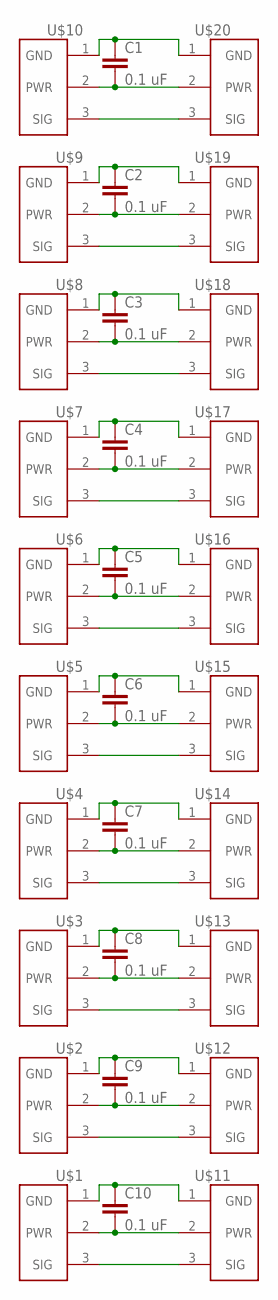
[picture p78: schematic pwm_adapter.sch]

Parts:
C1, C2, C3, C4, C5, C6, C7, C8, C9, C10: 0.1 uF; 0603
U$1, U$2, U$3, U$4, U$5, U$6, U$7, U$8, U$9, U$10: 22-23-2031GENERIC; PWM_1X3
U$11, U$12, U$13, U$14, U$15, U$16, U$17, U$18, U$19, U$20: 22-23-2031

Connections:
unnamed: C1.1, U$10.1 (GND), U$20.1 (GND)
unnamed: C1.2, U$10.2 (PWR), U$20.2 (PWR)
unnamed: U$10.3 (SIG), U$20.3 (SIG)
unnamed: C10.1, U$1.1 (GND), U$11.1 (GND)
unnamed: C2.2, U$9.2 (PWR), U$19.2 (PWR)
unnamed: U$9.3 (SIG), U$19.3 (SIG)
unnamed: C9.1, U$2.1 (GND), U$12.1 (GND)
unnamed: C3.2, U$8.2 (PWR), U$18.2 (PWR)
unnamed: U$8.3 (SIG), U$18.3 (SIG)
unnamed: C8.1, U$3.1 (GND), U$13.1 (GND)
unnamed: C4.2, U$7.2 (PWR), U$17.2 (PWR)
unnamed: U$7.3 (SIG), U$17.3 (SIG)
unnamed: C7.1, U$4.1 (GND), U$14.1 (GND)
unnamed: C5.2, U$6.2 (PWR), U$16.2 (PWR)
unnamed: U$6.3 (SIG), U$16.3 (SIG)
unnamed: C6.1, U$5.1 (GND), U$15.1 (GND)
unnamed: C6.2, U$5.2 (PWR), U$15.2 (PWR)
unnamed: U$5.3 (SIG), U$15.3 (SIG)
unnamed: C5.1, U$6.1 (GND), U$16.1 (GND)
unnamed: C7.2, U$4.2 (PWR), U$14.2 (PWR)
unnamed: U$4.3 (SIG), U$14.3 (SIG)
unnamed: C4.1, U$7.1 (GND), U$17.1 (GND)
unnamed: C8.2, U$3.2 (PWR), U$13.2 (PWR)
unnamed: U$3.3 (SIG), U$13.3 (SIG)
unnamed: C3.1, U$8.1 (GND), U$18.1 (GND)
unnamed: C9.2, U$2.2 (PWR), U$12.2 (PWR)
unnamed: U$2.3 (SIG), U$12.3 (SIG)
unnamed: C2.1, U$9.1 (GND), U$19.1 (GND)
unnamed: C10.2, U$1.2 (PWR), U$11.2 (PWR)
unnamed: U$1.3 (SIG), U$11.3 (SIG)

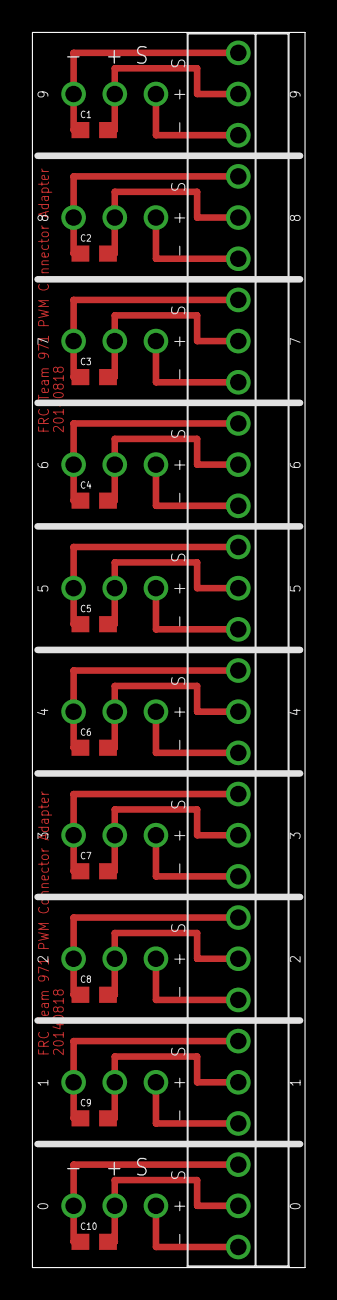
[picture p79: board pwm_adapter.brd from above]

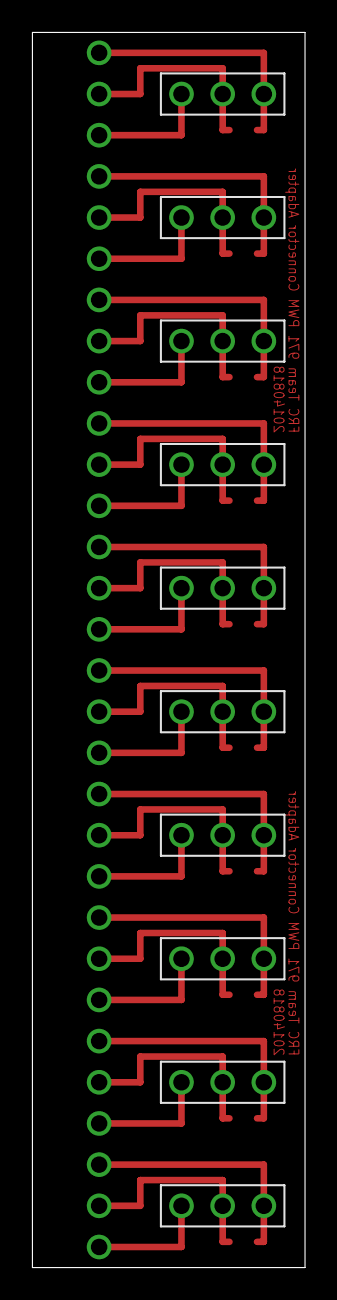
[picture p80: board pwm_adapter.brd from below]

Board: 2 copper layers, 16.8 x 76.2 mm, 30 parts (10 on the bottom side), 30 nets.
