frc971/971-Robot-Code/gyro_board/schematic/power_converter.brd

## EAGLE design gyro_board/schematic/power_converter.brd (2013-01-31, last stored version)

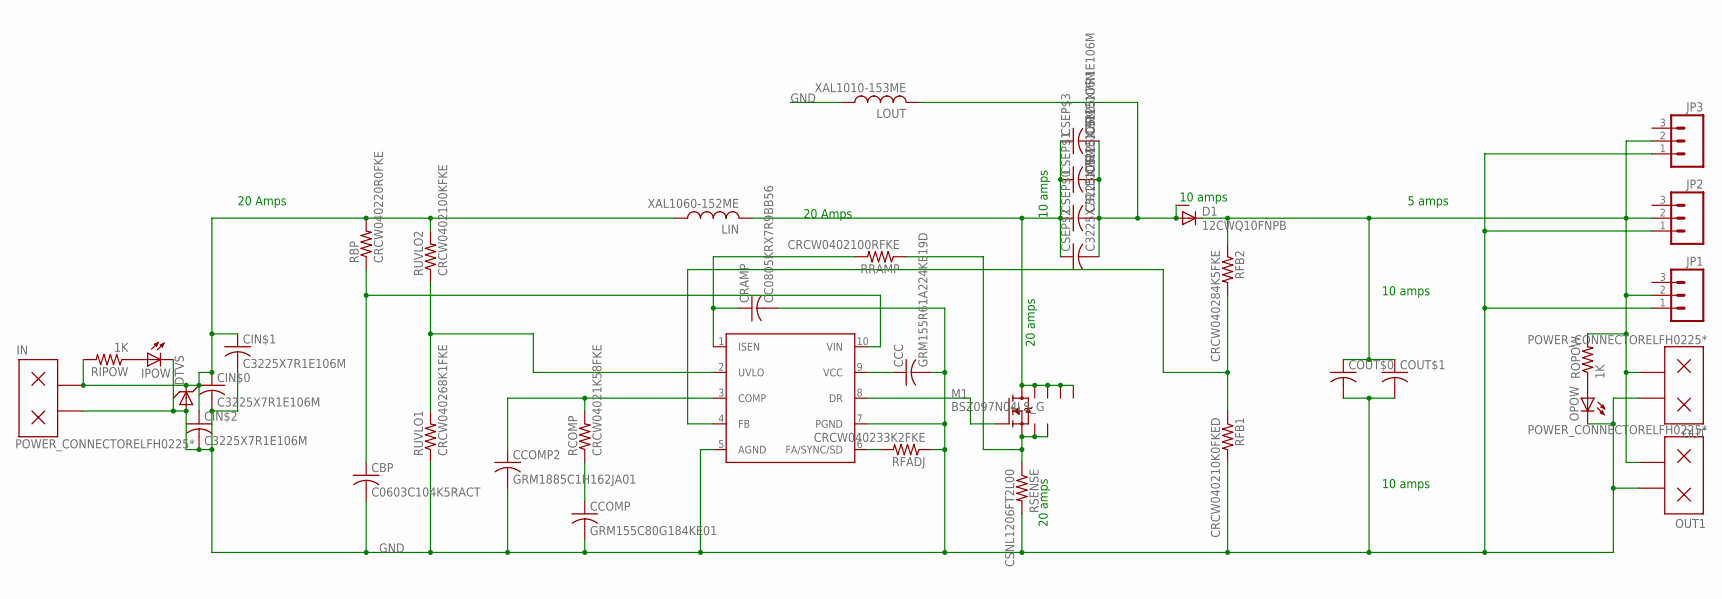
[picture p81: schematic power_converter.sch]

Parts:
CBP: C0603C104K5RACT; C0603
CCC: GRM155R61A224KE19D; C0402
CCOMP: GRM155C80G184KE01; C0402
CCOMP2: GRM1885C1H162JA01; C0603
CIN$0, CIN$1, CIN$2: C3225X7R1E106M; C1210
COUT$0, COUT$1: C-USRR71C331MDN1; RR71C331MDN1
CRAMP: CC0805KRX7R9BB56; C0805
CSEP$0, CSEP$1, CSEP$2, CSEP$3: C3225X7R1E106M; C1210
D1: 12CWQ10FNPB; D-PAK
DTVS: MMSZ5246BT1G; SOD-123
IN: POWER_CONNECTORELFH0225*; ELFH0225*
IPOW: LEDCHIPLED_0805; CHIPLED_0805
JP1, JP2, JP3: M03PTH; 1X03
LIN: XAL1060-152ME; 1060-152
LOUT: XAL1010-153ME; 1010-153
M1: BSZ097N04LS_G; PG-TSDSON8
OPOW: LEDCHIPLED_0805; CHIPLED_0805
OUT, OUT1: POWER_CONNECTORELFH0225*; ELFH0225*
RBP: CRCW040220R0FKE; R0402
RCOMP: CRCW04021K58FKE; R0402
RFADJ: CRCW040233K2FKE; R0402
RFB1: CRCW040210K0FKED; R0402
RFB2: CRCW040284K5FKE; R0402
RIPOW: 1K; R1206
ROPOW: 1K; R1206
RRAMP: CRCW0402100RFKE; R0402
RSENSE: CSNL1206FT2L00; M1206
RUVLO1: CRCW040268K1FKE; R0402
RUVLO2: CRCW0402100KFKE; R0402
U$1: LM3481; MSOP10

Connections:
GND: CBP.2, CCC.2, CCOMP.2, CCOMP2.2, CIN$0.2, CIN$1.2, CIN$2.2, COUT$0.- (2), COUT$1.- (2), CRAMP.2, DTVS.ANODE (A), IN.P$1, IPOW.C, JP1.1, JP2.1, JP3.1, LOUT.P$1 (1), OPOW.C, OUT.P$2, OUT1.P$2, RFADJ.1, RFB1.2, RSENSE.2, RUVLO1.1, U$1.5 (AGND), U$1.7 (PGND)
unnamed: CBP.1, RBP.1, U$1.10 (VIN)
unnamed: CIN$0.1, CIN$1.1, CIN$2.1, DTVS.CATHODE (C), IN.P$2, LIN.P$1 (1), RBP.2, RIPOW.2, RUVLO2.2
unnamed: CCC.1, U$1.9 (VCC)
unnamed: RUVLO1.2, RUVLO2.1, U$1.2 (UVLO)
unnamed: CCOMP2.1, RCOMP.2, U$1.3 (COMP)
unnamed: CCOMP.1, RCOMP.1
unnamed: CRAMP.1, RRAMP.2, U$1.1 (ISEN)
unnamed: RFADJ.2, U$1.6 (FA/SYNC/SD)
unnamed: M1.S$0 (S), M1.S$1, M1.S$2, RRAMP.1, RSENSE.1
unnamed: M1.G, U$1.8 (DR)
unnamed: CSEP$0.2, CSEP$1.2, CSEP$2.2, CSEP$3.2, D1.ANODE$0 (A), D1.ANODE$1 (A1), LOUT.P$2 (2)
unnamed: CSEP$0.1, CSEP$1.1, CSEP$2.1, CSEP$3.1, LIN.P$2 (2), M1.D$0 (D), M1.D$1, M1.D$2, M1.D$3, M1.D$4
unnamed: COUT$0.+ (1), COUT$1.+ (1), D1.CATHODE (C), JP1.2, JP2.2, JP3.2, OUT.P$1, OUT1.P$1, RFB2.1, ROPOW.2
unnamed: RFB1.1, RFB2.2, U$1.4 (FB)
unnamed: IPOW.A, RIPOW.1
unnamed: OPOW.A, ROPOW.1

Notes on the sheet:
20 Amps
10 amps
20 amps
5 amps

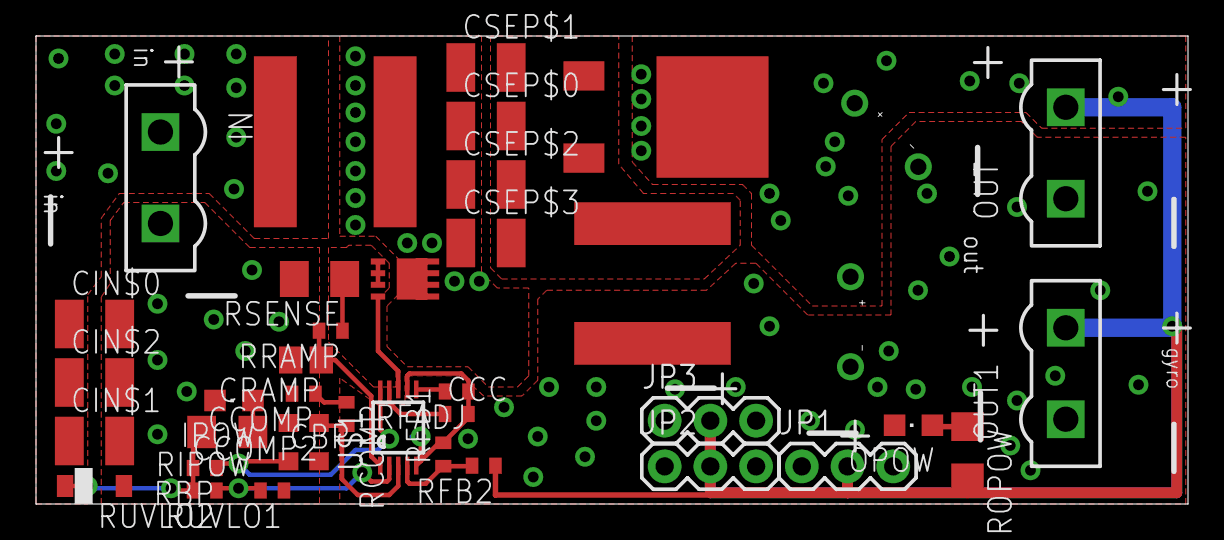
[picture p82: board power_converter.brd from above]

Board: 2 copper layers, 64.0 x 26.0 mm, 39 parts (0 on the bottom side), 17 nets.
