frc971/971-Robot-Code/frc971/control_loops/control_loop-tmpl.h

#include <cinttypes>
#include <cstddef>

#include "aos/logging/logging.h"

namespace frc971::controls {

// TODO(aschuh): Tests.

template <class GoalType, class PositionType, class StatusType,
          class OutputType>
constexpr ::std::chrono::milliseconds ControlLoop<
    GoalType, PositionType, StatusType, OutputType>::kStaleLogInterval;
template <class GoalType, class PositionType, class StatusType,
          class OutputType>
constexpr ::std::chrono::milliseconds ControlLoop<
    GoalType, PositionType, StatusType, OutputType>::kPwmDisableTime;

template <class GoalType, class PositionType, class StatusType,
          class OutputType>
void ControlLoop<GoalType, PositionType, StatusType,
                 OutputType>::ZeroOutputs() {
  auto builder = BuilderType<OutputType>::MakeBuilder(&output_sender_);
  BuilderType<OutputType>::SendZeroFlatbuffer(this, &builder);
}

template <class GoalType, class PositionType, class StatusType,
          class OutputType>
void ControlLoop<GoalType, PositionType, StatusType,
                 OutputType>::IteratePosition(const PositionType &position) {
  no_goal_.Print();
  no_sensor_state_.Print();
  motors_off_log_.Print();

  // Fetch the latest control loop goal. If there is no new
  // goal, we will just reuse the old one.
  goal_fetcher_.Fetch();
  const GoalType *goal = goal_fetcher_.get();

  const bool new_robot_state = robot_state_fetcher_.Fetch();
  if (!robot_state_fetcher_.get()) {
    AOS_LOG_INTERVAL(no_sensor_state_);
    return;
  }
  if (sensor_reader_pid_ != robot_state_fetcher_->reader_pid()) {
    AOS_LOG(INFO, "new sensor reader PID %" PRId32 ", old was %" PRId32 "\n",
            robot_state_fetcher_->reader_pid(), sensor_reader_pid_);
    reset_ = true;
    sensor_reader_pid_ = robot_state_fetcher_->reader_pid();
  }

  bool outputs_enabled = robot_state_fetcher_->outputs_enabled();

  // Check to see if we got a driver station packet recently.
  if (new_robot_state) {
    if (robot_state_fetcher_->outputs_enabled()) {
      // If the driver's station reports being disabled, we're probably not
      // actually going to send motor values regardless of what the FPGA
      // reports.
      last_pwm_sent_ = robot_state_fetcher_.context().monotonic_event_time;
    }
  }

  const ::aos::monotonic_clock::time_point monotonic_now =
      event_loop_->monotonic_now();
  const bool motors_off = monotonic_now >= kPwmDisableTime + last_pwm_sent_;
  joystick_state_fetcher_.Fetch();
  if (motors_off) {
    if (joystick_state_fetcher_.get() && joystick_state_fetcher_->enabled()) {
      AOS_LOG_INTERVAL(motors_off_log_);
    }
    outputs_enabled = false;
  }

  StatusBuilder status = BuilderType<StatusType>::MakeBuilder(&status_sender_);
  if (outputs_enabled) {
    OutputBuilder output =
        BuilderType<OutputType>::MakeBuilder(&output_sender_);
    RunIteration(goal, &position, &output, &status);

    BuilderType<OutputType>::CheckSent(&output);
  } else {
    // The outputs are disabled, so pass nullptr in for the output.
    RunIteration(goal, &position, nullptr, &status);
    ZeroOutputs();
  }

  BuilderType<StatusType>::CheckSent(&status);
}

}  // namespace frc971::controls
