frc971/971-Robot-Code/(commit log)

2020-11-12 Move more .data()'s to .span() inside flatbuffers.h
    We missed a couple...
2020-11-14 Squashed 'third_party/allwpilib/' changes from 00e090877..66b57f032
    66b57f032 [wpimath] Copy child constraint in region constraints (#2831)
    cfac22b4c [wpilib] Reset odometry in path following examples (#2859)
    2ef67f20a [wpilib] Add way to silence joystick connection warnings (#2845)
    7a73946ce [build] Update OpenCV to remove WITH_GTK (#2856)
    6d22b5a3c [wpigui] Render during resize events (#2857)
    50050a0e5 [wpilibc] Update C++ DiffDriveSim example to match Java (#2839)
    de1742279 [wpilib] Add IsJoystickConnected method (#2847)
    6b5e83ce1 [wpilibj] DrivetrainSim: Initialize m_u to default value (#2854)
    17d75d8a3 [wpilibj] SimDeviceSim: Make register device callbacks static (#2835)
    616405f7a [wpil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
    [DriveTrain.h, constants.h, math.h, util.h]
2020-11-14 Create zeroing estimator for absolute and absolute encoder
    The same as pot and absolute encoder, but with an absolute encoder that
    doesn't do index pulses, but can only go through one rotation.
    [absolute_and_absolute_encoder.cc, absolute_and_absolute_encoder.h, constants.h]
2020-11-15 Squashed 'third_party/flatbuffers/' changes from acc9990ab..d6a8dbd26
    d6a8dbd26 Experimental fix for failing oss-fuzz coverage build (#6259)
    ed391e177 BREAKING: Rust flexbuffers serde human readable set to false (#6257)
    a49531414 Update to flags in fuzzing-cmake file (#6256)
    de1f0342c Remove _POSIX_C_SOURCE and _XOPEN_SOURCE definitions when compiling o… (#6205)
    d0d51e2a5 flatc should support --binary --schema with optional scalar fields. (#6252)
    33ab26017 Bump version of rules_go to 0.24.5 (#6234)
    febb9d87c Union As Accessors for C# (#6251)
    8778dc7c2 Resets buffer without deallocating current pointer (#6247)
    aae376e9a Add GetBufferSpan() function to bufferbuilder (#6235)
    0ff047148 Moderni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
    [util.h]
2020-11-19 Add (default off) support for dying on malloc in RT code
    Our malloc is not realtime. We shouldn't be using it in RT code. To
    enforce this, add a hook into tcmalloc to LOG_RAW(FATAL) whenever an
    application tries to allocate memory inside code running at the RT
    priority level.
    We have code in our drivetrain code which is allocating memory still
    when realtime. That prevents us from enabling it yet.
2020-11-20 Make messages sent between RunFor call watchers in sim
    The prior behavior was that watchers only got called for messages sent
    while running. This caught a lot of people off guard for no good
    reason and interacted poorly with simulated_message_gateway.
    There is still a small edge case where you:
    1) run
    2) send a message on event loop 2 on channel 1
    3) make a watcher on event loop 1 on channel 1
    4) run
    It is a bit hard to define what "correct" is here. Instead, just
    prevent the user from writing that for now until we get a better
    requirement. The analog for the real world is a bit wonky since if you
    did this with a ShmEventLoop, you'd be quite not realtime and probably
    cause problems wit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
2020-12-03 Update bazel to fix some Incompatible Target Skipping bugs
    This is the same version as 4.0.0rc2 except with 2 cherry-picks:
    a3c94ec2ed Fix builds for filegroup targets with incompatible dependencies
    b3c9d7381c Fix a couple of bugs with Incompatible Target Skipping
    The patch for the filegroup fix has already merged on master:
    https://github.com/bazelbuild/bazel/pull/12601
    The other patch is still under review:
    https://github.com/bazelbuild/bazel/pull/12560
    This should enable us to convert the code base to use platforms.
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2020-12-05 Switch LogReader to the new API, and remove the old
    Now that we have a fancy new log sorter, lets flip over to using it.
    This doesn't simplify anything yet on the log reader side to take
    advantage of the simpler code.
    While we are here, the new API really wants a LogFiles object instead of
    vectors of strings. Convert any calls over to the new LogFiles API.
    The log file was updated to add UUIDs. They are required with
    multi-node log files, and it doesn't seem worth changing that
    requirement for this old log.
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2020-12-13 Upgrade bazel to 4.0.0rc6
    This is the upstream rc6 branch with two cherry-picks:
    Fix a couple of bugs with Incompatible Target Skipping
    Add --{no,}autodetect_server_javabase
    https://github.com/bazelbuild/bazel/pull/12542
    This patch also uses the new --noautodetect_server_javabase flag.
    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
2020-12-13 Fix builds for "download_stripped" targets
    We were seeing this:
    bazel run -c opt --config=roborio //y2020:download_stripped -- 971
    ERROR: Target //y2020:download_stripped is incompatible and cannot be built, but was explicitly requested.
    Dependency chain:
    //y2020:download_stripped
    //aos:prime_start_binaries_stripped
    //aos/events/logging:logger_main
    //aos/events/logging:logger
    //aos/events/logging:logfile_utils
    //aos/events/logging:lzma_encoder
    //third_party:lzma
    //third_party:unavailable <-- target platform didn't satisfy constraint @platforms//:incompatible
    INFO: Elapsed time: 31.343s
    INFO: 0 processes.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
2020-12-13 Fix bazel query
    We currently see this error when running a query:
    $ bazel query //...
    ERROR: /bazel-cache/phil/bazel/_bazel_phil/f1328168c8ac7d35b10d44d44011b547/external/build_bazel_rules_nodejs/internal/node/node.bzl:87:45: invalid escape sequence: \/. You can enable unknown escape sequences by passing the flag --incompatible_restrict_string_escapes=false
    ERROR: /bazel-cache/phil/bazel/_bazel_phil/f1328168c8ac7d35b10d44d44011b547/external/build_bazel_rules_nodejs/internal/node/node.bzl:87:64: invalid escape sequence: \.. You can enable unknown escape sequences by passing the flag --incompatible_restrict_string_escapes=false
    ERROR: error loading package '': in /bazel-cache/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
2020-12-16 Fix mouse button processing in plotter
    Turns out that I'd reversed the logic for a couple of the fields. The
    current plotter also doesn't actually use either the middle click or
    right click buttons, so this didn't actually matter.
2020-12-16 Refactor code in gmp/mpn.bzl to support msan
    The code was coppied, factor it out and add support for skipping
    assembly when msan is turned on. This isn't everything needed for msan
    yet.
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2020-12-16 Print channel which is missing matching data.
    When we observe a timestamp without data, the first question is "which
    channel?". Add that info to the CHECK statement.
2020-12-17 Switch magic timestamp channel to RemoteMessage
    In order to track reboots and such, we really need to communicate more
    information from the message_bridge to the logger. It is a shame to
    have to modify the MessageHeader to do this, even though it would be
    nice. Switch the remote timestamp channels over to a new RemoteMessage
    channel instead, and add code to rename the channel when replaying.
    There are no known log files with a MessageHeader actually logged, so
    most of this should be pretty safe. I've tested this on an old log file
    by hand.
    [configuration.h]
2020-12-17 Quiet down message_bridge_test to reduce flakes
    I'm seeing random test failures locally. Printing in the critical loop
    can't be helping.
2020-12-19 Fix debug print in logger
    The condition was completely backwards... This makes the print trigger
    when it should now.
2020-12-20 Rotate log files when the remote reboots
    Add a logger_boot_uuid to track the difference between the logger node's
    and the remote node's boot uuids, and also a logger start time. This
    gives us enough information to enforce only 1 boot per node, and to also
    detect which log came first if a node rebooted. Order detection isn't
    used today, but before we generate more logs, we should fix the issue.
    Also, enforce one boot per node when replaying. We don't manage
    timestamps well enough to do anything else.
2020-12-20 Pull multi-node timestamp estimation into a class
    There is enough code there and enough interactions to justify an
    interface. Put it behind an interface to make it much more clear and
    easier to enforce what updates when and with what guarentees.
    This should provide no functional change.
    [configuration.h]
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2020-12-20 Support reading logs without a matching peer
    If you only have log files from one node, but timestamps which need data
    from another node, we CHECK. Instead, propegate this as an error up the
    chain.
2020-12-20 Fix max voltage in ssdrivetrain
    The max voltage was getting set to a boolean,
    and it was true so the max voltage was 1.
2020-12-26 Add queue buffers & simulation support to web proxy
    This makes a couple of major changes:
    -Directly uses EPoll class for managing Seasocks events.
    -Adds buffers of queues to web proxy Subscribers so that we can
    transfering data losslessly in log replay.
    -Modifies the flatbuffer used for the RTC communications so that
    the webpage can specify whether it wants every message or subsampled
    messages.
    -Adds an option to LogReader to let us run past the end of the logfile.
    Note that these changes do mean that, for log replay, the web proxy will
    load the *entire* logfile into memory. Future changes can optimize this
    to, e.g., only load the required channels into memory.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
    [configuration.h]
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2020-12-28 Support disconnecting nodes.
    We have a case where message bridge client failed to connect on only one
    of the nodes. This resulted in an unreadable log file. Add the ability
    for simulated event loop to recreate this situation.
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2020-12-30 Fix up synchronization with WebRTC calls
    We were both calling one of the WebRTC functions from the wrong thread
    and were modifying data structures from multiple threads simultaneously.
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2021-01-02 Add a TimestampProblem class to solve the timestamp estimation problem
    The timestamp estimation problem is actually really close to a
    MPC. It can be phrased to have a nice piecewise quadratic cost,
    linear constraints, and solves well with similar solvers. The cost
    function chosen is to penalize the squared difference between the
    measured and filtered offset, and the difference in the corresponding
    times.
    The solver chosen in NLOPT, NLOPT_LD_SLSQP, is designed for exactly this
    problem type, and uses the gradient to produce a really accurate answer.
    Multiple solutions attempted are accurate to full double precision with
    gmp.
    The next step is to replace the current timestamp estimation algo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
2021-01-02 Add Debug method to print the time optimization problem
    This helps a lot in seeing what is being solved and understanding why
    something is hard to solve.
2021-01-02 Add the messages skipped when time skips an event
    The first question ends up being "what messages triggered this?", so
    let's just print them out
2021-01-02 Add a drivetrain typescript plot config
    Also, add a few extra comments/error messages to other pieces of
    the plotting infrastructure.
2021-01-03 Switch to using 128 bit math for time interpolation
    This gets rid of any rounding errors and allows us to be *perfect*.
2021-01-05 Add NodesCount and fix comment to aos/configuration.h
    Jim points out that a comment is confusing, so fix it.
    Also, a number of users want to count the number of nodes both in
    multinode and single node. Put that in a library.
    [configuration.h]
2021-01-05 Add Consume, Observe, and FreezeUntil to track timestamps
    This lets us solve at every corner and track which corners have been
    solved. It also then lets us report back which points have been
    used and need to be frozen.
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2021-01-09 Add drivetrain position plot to drivetrain plotter
    It is useful to look at the position plot next to the voltage one
    when we are debugging the jerkiness of the drivetrain.
    Also, Austin found that we have a bug in drivetrain code by looking
    at this plot, so if this commit gets merged then we can all use this
    plot to find that bug.
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2021-01-11 Use the new solver to compute time
    Now that all the infrastructure exists, hook it up. Track which nodes
    are connected, if there are any orphaned nodes, and everything else the
    old code used to do.
    This doesn't yet handle single directions going and coming.
2021-01-12 Set NodeEventLoopFactory boot_uuid to logged boot_uuid
    Previously, we couldn't replay relogged logfiles because they
    did not correctly track the boot uuid from the ServerStatistics message,
    which was very unfortunate. Since the goal of replay is to reproduce
    the state of the world when we were running, set the simulated boot UUID
    to match what was logged.
    I still don't seem to be able to fully replay relogged files (see
    comments in drivetrain_replay.cc), but I think that those issues are
    likely independent of this particular problem and I haven't yet written
    a test to conveniently reproduce it.
2021-01-12 Track file ending more carefully
    The old method was failing on long compressed logs with unclean
    shutdown. We were getting large differences in end times between parts
    and CHECKing. Instead, track when we stop seeing data on a channel, and
    when that happens, eat the rest of the log file, confirming that the data
    on that channel doesn't come back. This makes it so we don't try to
    determine if we got to the end or not, and instead just confirm that we
    don't have gaps in the data. That is a more direct measurement of what
    we actually care about.
2021-01-17 Squashed 'third_party/rawrtc/rawrtc/' content from commit aa3ae4b24
    git-subtree-dir: third_party/rawrtc/rawrtc
    git-subtree-split: aa3ae4b247275cc6e69c30613b3a4ba7fdc82d1b
    [configuration.h]
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2021-01-22 Add source and destination node to error messages
    This helps figure out exactly which filter fails.
2021-01-22 Switch LogReader::Nodes to LoggedNodes
    If folks want a list of nodes from the simulated config, they should
    instead use the factory configuration. Most of the time, we want to
    instead use the nodes from the logged configuration. Flip everything
    over.
    We should probably consider removing the helper since it doesn't really
    add much.
2021-01-23 Set the slope to 0 before the start in NoncausalTimestampFilter
    We were assuming that the slope for a 2 point filter before the start is
    whatever the line is. This means 2 things.
    1) If we've frozen before the start and add a second point, we change the
    slope.
    2) The individual slopes are generally pretty rubbish. They suffer from
    lots of noise. So, instead of using any individual value, a slope of
    0 is more accurate.
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2021-01-23 Add Position Encoder and Reader PID Plots
    The position encoder plot is useful for debugging drivetrain issues
    and the reader pid plot tells us if wpilib interface gets reset.
    I created a new file for all robot state plots because there is a
    maximum number of plots in one plotting function and the limit
    was exceeded.
2021-01-24 Make starter actually start on the roboRIO
    Some of the commands run need to actually run as root. Make sure you
    are root for those.
    We also were missing channels, and some channels needed to be bigger.
    [wpilib_robot_base.h]
2021-01-24 Add voltage error plot and improve drivetrain.py comments
    When tuning the 2020/2021 robot, we found that the voltage error was
    significantly miss-tuned. It was resulting in significant oscillations.
    To tune it, we need a plot showing the step response. Make one.
    While we were debugging, we found the wording to be confusing for some
    of the fields in the parameters. Update them.
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2021-01-24 Refactor starter_cmd a bit
    This patch switches the order of arguments for starter_cmd. In
    particular, the subcommand now comes first and then you specify the
    name of the application.
    For example:
    $ starter_cmd start <app>
    $ starter_cmd stop <app>
    $ starter_cmd status <app>
    This patch also enhances the "status" command to work without any
    arguments. In this case, it will print out a high-level status for all
    applications.
    The error reporting on incorrect arguments to starter_cmd should also
    be quite a bit improved with this change.
2021-01-24 Tune y2020/2021 drivetrain controller
    The falcons are proving to be way more aggressive than CIMs were. The
    higher kt means that the controllers are more aggressive by default.
    Detune both the voltage error and the controller enough to make it
    stable and smooth.
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2021-01-27 Add nodes to all the rest of the prints in NoncausalTimestampFilter
    This makes it a lot easier to understand which filter is the problem
    when something explodes, or when otherwise debugging.
2021-01-27 Queue filters until there are at least 2 points each
    We were seeing issues where each channel had 1 message at start, then a
    *long* time gap, then the body of the messages. We would queue the 1
    message up, do time estimation, freeze past that message, then find the
    body of data. That was resulting in us not being able to read
    reasonably phrased logs.
    The fix is to make sure to queue 2 points for each active filter (plus a
    bit after so we don't immediately try to modify it).
2021-01-27 Added check in CompareTimes for case when one node solution hasn't moved
    Returns kInvalid in that case. Also added tests around CompareTimes and
    InvalidDistance calcs
    Rebased with the extrapolated time calcs and fix for normalized times
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2021-01-31 Tune spline and linear move for the classroom
    Shorten the spline, lower the speed and acceleration,
    and switch the default back to the spline.
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2021-02-01 Verify exact wakeup times in event loop test
    I thought we weren't able to reschedule a timer well, so I improved the
    tests. Turns out the bug was elsewhere in my code. Phew
2021-02-02 Handle missing data at startup better
    We had a case where the data was sent *before* the start of the log
    file, and the timestamp was sent *after* the start of the log file. So,
    we couldn't match the data because it wasn't logged, but the data wasn't
    supposed to be logged whereas the timestamp was supposed to be logged.
    The CHECK that fires is trying to catch when data goes away in the
    middle of a log and notify the user that we have missing data. That is
    not the case here.
    Be more aggressive here and declare any message with missing data where
    the data was before the start of the log to be fine and ignore it.
    We'll see if there are more cases.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
2021-02-03 Switch to python3 and scipy from slycot
    Turns out we need python3 matplotlib to make scipy work well enough to
    place the poles correctly for our systems. Rather than do it piecemeal,
    do it all at once.
    This includes a python opencv upgrade too to support the new python, and
    a matplotlib upgrade.
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2021-02-08 Run watchers even if a timer is firing constantly
    Also make sure to drain the signalfd each time through.
    There can only be so many outstanding signals on a system, and this
    bounds that much better. It also handles events which take too long to
    handle and other events are ready to be handled.
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2021-02-08 Refactor out GetApplication for reuse
    No need to duplicate the logic elsewhere.
    [configuration.h]
2021-02-13 Make --max_invalid_distance_ns errors more helpful
    Print out the exact flag to save a lot of time.
2021-02-13 Handle finishing a log file more gracefully
    Once one file ended, we were spinning until the end and popping
    continually. This was resulting in us removing all the intermediate
    data, and then adding it back in with the reverse timestamps.
    There are 2 parts to the fix. 1 is detection and the other is fixing
    the issue.
    1) Instead of tracking a frozen bool, track the frozen time. This more
    accurately captures what is going on, and handles things being popped
    off the front. Also, make sure Validate won't certify an answer
    which needs data we popped.
    2) When we are spinning to the end of the log, don't forget the
    timestamps yet. We need those for solving the problem still.
    T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
2021-02-27 Add flatbuffer schema for galatic search challenge path
    The flatbuffer will be send on the /camera channel indicating the path on the field so that the correct spline can be run.
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2021-03-07 Fix hood geometry error
    The ballscrew was a 1/2", not 12mm. This works out perfectly to the
    error.
    [constants.h]
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2021-03-08 Add install of matplotlib to raspberry pi disk image
    Had to increase the disk image size to support this. Looks like it requires
    at least 2.4 GB. I moved it to 3 GB to give some extra buffer-- not sure
    if there are any issues with this size.
2021-03-09 Automatically reload page when changing plots
    Due to limitations of the current plotter, we don't handle swapping
    between plots cleanly, so just forcibly reload the page.
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2021-03-15 Add remote_boot_uuid to Context
    This lets us track which boot a message came from and finally fix the
    logger relying on ServerStatistics having all the required information
    needed to build up the logfile header.
2021-03-15 Switch Logger over to using the new context UUID
    We got a lovely kersplat when Jim rebooted one of the pi's and I tried
    to restart the logger. We've seen this occasionally in a bunch of
    spots randomly.
    F0313 17:40:26.905807 1893 log_writer.cc:677] Check failed: node_state_[f.data_node_index].header_valid : Can't write data before the header on channel { "name": "/pi2/aos", "type": "aos.message_bridge.Timestamp", "frequency": 10, "max_size": 200, "num_senders": 2, "source_node": "pi2", "destination_nodes": [ { "name": "roborio", "timestamp_logger": "LOCAL_AND_REMOTE_LOGGER", "timestamp_logger_nodes": [ "roborio" ], "priority": 1, "time_to_live": 5000000 }, { "name": "laptop", "priority": 1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
2021-03-23 Warn when a channel isn't logged and terminates reading a log
    The Galactic search path message was forwarded to the roboRIO but wasn't
    logged. The end result was that we stopped replaying the log when we
    found the first Galactic search path timestamp. It was very confusing
    to debug.
    The fix is 2 fold.
    1) Log the message.
    2) Warn in log_reader that this is happening to make it much faster to
    debug.
    [configuration.h]
2021-03-25 Disable drivetrain on IMU faults
    If we see any faults in the IMU diagnostics, fault the IMU zeroer and
    disable any drivetrain outputs so long as the IMU is not properly
    zeroed.
    This also causes some slight effect to the localizer in one of the
    tests, forcing me to bump up a tolerance.
    [imu_zeroer.cc]
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2021-03-28 Fix WaitForDistanceRemaining auto check
    The previous check could return true prematurely if the drivetrain
    status message still contained information about the previous spline.
    Add a check to make sure we are checking the distance remaining for the
    current spline.
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2021-04-03 Retry builds on buildkite failure and support rebuilds
    We had the CI service go down when buildkite was having an issue.
    Instead of crashing, we should retry.
    Also, support retesting using the "rebuild" button on buildkite. This
    should be rarely used, but it is helpful.
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2021-04-04 Update galactic search path detection
    This has all of the code that we added today while doing the
    skills competition, such as eroding and dilating the mask
    to amplify the balls and remove noise,
    fixing a bug where camera reader was stopped two times,
    and updating the json with the rects we selected.
    It also adds a feature where you can see the rects you previously
    drew on top of the current image.
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2021-04-08 Squashed 'third_party/rawrtc/re/' changes from f3163ce8b..9384f3a5f
    9384f3a5f Merge branch 'meson' into rawrtc-patched
    9283ee693 Fix version
    d9708ac30 Merge branch 'meson' into rawrtc-patched
    f0cd32702 Remove unneeded define
    bd224386a Rename library to avoid clashes
    66b398f16 Fix comment
    fe728e6db Fix 'fallthrough' warnings
    f0da48e84 Generate pkg-config file
    520a6c4b1 Allow to use as a Meson subproject
    06786bb40 Update Meson build files
    1f5b2b0f3 Fix Windows dependencies
    a812e4ae4 Enhance ifaddrs.h check for Android
    bf45d1b85 Enhance resolv.h check for Android
    5183ad041 Add minimum Meson version
    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
    [main.c]
2021-04-10 Fix check for new data in plotter
    The previous check was overly sensitive--it failed to account for
    situations where there were more data-points than messages (e.g.,
    batched IMU measurements or repeated fields).
2021-04-10 Making image_capture.py executable.
    This is a nice quick easy way to capture images, when wanted
    I've reverted back so we're not deploying this to the robot-- just use
    viewer to view and capture images from a running CameraImage stream
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2021-04-10 Actually shoot when auto tracking
    We were waiting for the velocity goal to be nonzero. This wasn't
    correctly handling autotrack, so we couldn't fire unless the shooter
    button was pressed too.
2021-04-10 Skip printing messages after count in aos_dump
    There are cases where the event loop will attempt to flush pending
    callbacks after Exit. It can do this for quite a while. That causes
    messages to be printed after Exit.
    Skip printing if we get called after we meet our count to prevent that.
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2021-06-19 Validate flatbuffers before printing in aos_dump, log_cat, and simulated_event_loop
    We had a corrupted flatbuffer being logged, and the error was very poor
    when it was being printed. Let's try to catch this a lot earlier.
    Fix 1: log_cat should validate before printing. That'll prevent us
    from wasting time debugging why it is crashing and point the finger a
    lot better.
    Fix 2: aos_dump should do the same. That'll save us from nasty crashes
    there too and focus attention a lot better.
    Fix 3: SimulatedEventLoop sender Send should also validate in debug
    mode. This will avoid too big a performance hit in the fast path, but
    will catch corrupted flatbuffers in any simulations we do, or any log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
    [configuration.h]
2021-06-20 Use event_loop to set realtime priority on y2019 SolenoidWriter
    The event loop wants to be the one who manages RT priority. It crashes
    if Run is called while RT because setup work shouldn't be done while RT
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2021-06-20 Heap allocate the drivetrain to preserve stack
    We were overflowing the stack because the drivetrain code had grown to
    use enough memory to cause problems. Switch to heap allocating the
    object since it can be pre-allocated regardless.
2021-06-20 Rename uptime to uptime
    This prints out a lot shorter on the console
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2021-07-02 Add a BootTimestamp class and move some things over
    This makes it so we can compare timestamps again across boots. Move
    most things over to using it instead so we can more naturally track what
    happens in what order.
    Note: this is not complete and has no tests. Anywhere where I'm not
    comfortable that the code will handle it today should now CHECK that the
    count is 0 so we explode. Tests and tolerance of reboots will come in
    future patches, starting with TimestampMapper and then with the
    time recover code and then LogReader.
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2021-07-14 Add SourceNodeIndex to compute the source node per channel
    We keep doing this type of thing. Time to go write a function. Doing a
    bunch of string compares is slow, so we should really cache it up front.
    It feels like it might be getting close to time to try to write a class
    which will let us compute and cache all these things reasonably
    efficiently and move logger and others over to it. Let's start with a
    function to compute the things we care about.
    [configuration.h]
2021-07-16 Replay logs from both the source and destination nodes
    We had logic for falling back to sending remote timestamps immediately
    when we found a logged timestamp without the timestamp time. This was
    to handle logs from before we started logging the timestamp time.
    This is no longer a case worth worrying about. Instead, when we find a
    message without a timestamp time, that means that the timestamp didn't
    make it across the network successfully and the RemoteMessage shouldn't
    be recreated and sent.
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2021-07-17 Support sorting parts files across reboots
    We have log files where the parts_uuid stays the same across a remote
    node rebooting. The source_boot_uuid changes in this case.
    Since it is hard to change old log files, and this isn't very hard to
    support, let's just support it. Split these into separate LogParts
    entries.
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2021-07-20 Don't queue up the remote when it doesn't exist.
    When constructed normally (in log_reader), we call AddPeer. Based on
    how everything is constructed, this sets 'peer' for any pair of nodes
    which communicate. It is impossible to have a set of nodes which only
    communicate in one way in AOS today.
    In timestamp_extractor, we don't call AddPeer since we don't care to
    match and only want local timestamps in order. Because of this, we
    accumulate up all the timestamps and data into the NodeData
    datastructure until the program shuts down, exploding our memory usage
    for no reason.
    Track when we have a peer who cares and don't bother to queue the
    messages when nobody cares. This saves a massive am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
2021-07-20 Track our time buffer more explicitly
    We were getting crashes because we couldn't register the timer inside
    LogReader because we had forgotten how to translate the current time
    (t=0). That's wrong...
    The root cause was that our concept of how much to buffer was too
    loose. We really needed to be pruning off the current time, not off the
    size of the buffer, since there is nothing saying that we haven't
    buffered too far into the future and forget now. Add a callback from
    the scheduler for this.
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2021-07-31 Replace use of deprecated C Standard library headers in C++ code.
    [configuration.h]
2021-08-01 Handle streams becoming unassociated before the VLOG
    It's annoying when the debug printing code crashes...
2021-08-01 Sundry fixes to statespace controllers
    1) Instead of taking a pointer to arguments, take a r value reference
    and move them. Much more C++ like.
    2) Some controllers don't want a fixed C, D, Q, and R. There is no harm
    in allowing those to be passed in. Expose that intermediate form.
    3) We had uninitialized state variables. Initialize them to something
    sane.
    [hybrid_state_feedback_loop.h, state_feedback_loop.h]
2021-08-02 Correctly format debug message in GetLogName
    The previous iteration would print out that the new logfile was being
    created at fbs_log-1 without adding the correct padding.
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2021-08-03 Prune partially-implemented handling of failed messages in message_bridge
    It stored unbounded numbers of them, which led to running out of memory
    in some situations.
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2021-08-04 Move reboot and header responsibility into DataWriter
    Now that we have a class wrapped around the raw flatbuffer writing to
    disk, we can start to make it responsible for tracking and writing the
    header. It can also track reboots. Each message that is to be written
    now needs to be passed in with the corresponding boot UUID.
    This removes a ton of code in LogWriter since it is simpler to do it in
    DataWriter. We don't need to detect state and then trigger the right
    behavior nearly as much because the bottom layers track it very easily
    now and just work.
    Side effects here of delaying writing a bunch of stuff is that we
    shouldn't write headers with no body because we delay writing the header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
2021-08-07 Correction of switch-case implicit fall through error
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2021-08-09 Track matching forwarded times for log file sorting
    Previously, the only thing we knew was a loose ordering based on part
    index. That isn't very conclusive. This now provides us with
    corresponding timestamps for when things cross the network boundary in a
    way that we think should tell us definitively what came first.
    There are 2 main problem cases. Let's say we have 2 channels. /a which
    is reliable, and /b which isn't, both sent from the same remote node.
    case 1: /a -> boot 0 received on boot 0.
    /b -> boot 1 received on boot 0.
    We start logging after both messages arrive.
    case 2: /a -> boot 0 received on boot 0.
    /b -> boot 0 received on boot 0.
    We log for a bit,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
2021-08-21 Make timestamp_to_csv work with multiple boots
    The old code used a starting monotonic time to sync all the data on the
    same plot. This doesn't work when reboots are at play. Rather than
    fight that, use the distributed clock for everything.
    Rather than push the concept of the distributed clock into the timestamp
    filter, pull the concept of logging CSV files completely into the
    multinode filter code. This actually simplifies things a fair amount.
    The next step is to take this beautiful set of boot/time correspondances
    and plumb it into the simulation code.
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2021-08-31 Support nodes rebooting
    We have log files which span a reboot. We want to be able to replay the
    timeline across that reboot so we can run simulations and everything
    else interesting.
    This requires a bunch of stuff, unfortunately.
    The most visible one is that we need to be able to "reboot" a node.
    This means we need a way of starting it up and stopping it. There are
    now OnStartup and OnShutdown handlers in NodeEventLoopFactory to serve
    this purpose, and better application context tracking to make it easier
    to start and stop applications through a virtual starter.
    This requires LogReader and the simulated network bridge to be
    refactored to support nodes coming and going while the main app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
    [configuration.h]
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2021-09-03 Add TODO on queueing in log_reader
    We currently queue until the end when we find a problem. This explodes
    memory usage. Document that as a future improvement.
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2021-09-12 Use previous pose in seeding the search for the current pose
    Set up as optional via flag, but defaults to on for now
    This seems to help stabilize the estimate, by biasing towards the last one
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2021-09-14 Handle printing realtime_clock::min_time correctly
    We were printing it in the future, not the past. This was due to an
    underflow in the nanoseconds -> seconds calculation. Fix that to make
    the error a lot more meaningful.
2021-09-15 Fix a crash in timestamp_filter when popping the end
    We were hitting a crash here:
    F0915 13:16:26.608079 29868 timestamp_filter.cc:1127] Check failed: pop_filter_ < filters_.size() (1 vs. 1)
    *** Check failure stack trace: ***
    @ 0x5605df3b15ed google::LogMessage::Fail()
    @ 0x5605df3b0a0e google::LogMessage::SendToLog()
    @ 0x5605df3b12c2 google::LogMessage::Flush()
    @ 0x5605df3b4519 google::LogMessageFatal::~LogMessageFatal()
    @ 0x5605df1e24e7 aos::message_bridge::NoncausalTimestampFilter::Pop()
    @ 0x5605df0d2609 aos::message_bridge::MultiNodeNoncausalOffsetEstimator::NextTimestamp()
    @ 0x5605df0c4d08 aos::message_brid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
2021-09-16 log_cat: print out log_start_uuid
    Also fix how we print out logger_instance_uuid.
    This supports understanding our logs.
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2021-09-17 Error out if asked to read the same part twice
    Before, we would get a cryptic error about time going backwards when we
    tried to concatenate the part file with itself. We have UUIDs
    everywhere, so we can pretty easily detect this case. Do that and give
    a more targeted error.
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2021-09-26 Fixing broken calib file and changing to only load calibrated data
    We were sending a default calibration file for every possible pi/robot combo.
    Instead, let's just send only the ones that we have calibrated.
    I've included a default / reference calib file that can be copied
    if we aren't able (or don't want) to do a calibration.
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2021-09-26 Added new daytime target for our power port
    It has only 2 panels taped up, so calling it "partial".
    Preserving the nighttime training image, in case we need to revert to it
    Also, did a little bit of glog info vs. debug cleanup
2021-09-26 Make DMA pulse width work
    The sensors return 1 when there is no ball...
    Also fix a move before get to a get before move to fix a segfault
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2021-10-03 Add a periodic pause to cool the motors
    We were overheating the robot. Pause to cool it.
2021-10-03 Fix turret calibration
    * The calibration for the turret position was messed up following the
    turret work done earlier.
    * The camera extrinsics were absurdly far off.
    [constants.cc]
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2021-10-09 Correctly handle turret-focused image corrections in localizer
    This makes it so that, by default, we will prioritize making localizer
    corrections with the intent of keeping the turret accurate (note that
    this will prioritize whatever image target we are using, even if it
    isn't the actual shooting target). Currently, it allows a small portion
    of correction to creep through to correct for gyro drift, but is on the
    order of <1 deg / minute currently. Given the quality of our gyro, this
    should be fine.
2021-10-09 Fix superstructure replay balls shot test
    Since we modified the interpolation table to have the finisher only
    shoot at 350 rad/s, if we replay the log with auto tracking it will give
    us a different finisher goal from before when we ran this on the robot,
    so the goal will not match the actual velocity.
2021-10-09 Recal the turret again with the new gear
    It shouldn't slip now...
    [constants.cc]
2021-10-10 Relax the shooter ready velocity tolerances
    We were chattering between ready and not ready a *lot*. Open up the
    tolerances a bit so we are faster to get the shot off.
    We should consider hysterisis as well at some point.
2021-10-12 Make initialization of 2020 constants explicit
    By doing this, we will remember to initialize the constants
    before RT so we don't malloc in RT.
    Later we will replace this with the constants in a json file.
    [constants.cc, constants.h]
2021-10-12 Disallow logging timestamps without data
    Nobody has come up with a good use case or a way to read the data
    afterwards. Until we have a use case, it isn't worth spending the
    engineering figuring out how to expose this all.
    Instead, when validating configs, enforce that we can't log timestamps
    without data. Logs with timestamps and no data are possible to read,
    but need --skip_missing_forwarding_entries and are not recommended.
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2021-10-13 Relax aos event loop test latency thresholds
    We are seeing on CI machines that hitting 50ms is not reasonable,
    especially under high load. --runs_per_test doesn't trigger this since
    that doesn't load up the rest of the system heavily.
    Efficiency isn't as big a concern as reliability. Give ourselves much
    more time (10x) for everything by just multiplying all the times by 10
    so we are much more tolerant of a couple ms here and there.
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2021-10-14 Adding targets for night time and far away daytime
    Also fixed a couple lines that weren't printing properly in switch from
    print to glog
2021-10-14 Adding checks to filter out bad pose estimates
    If the distance from the camera is negative (behind the camera)
    or too large (using > 100m), ignore this pose, and reset
    the initial guess, rather than re-using this bad pose on the
    next iteration
2021-10-14 Reverse the intake sensor direction
    Turns out physical testing says it is inverted.
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2021-10-16 Use ADIS16448 in y2020
    This updates the IMU transform to be correct for the yaw axis, but may
    have the X/Y axes/signs wrong if we care about accelerometer or
    roll/pitch data.
    [constants.cc, constants.h, imu_zeroer.h]
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2021-10-16 Change printed info from aos_starter status
    uptime isn't relevant when stopped, so don't print it. Also, put PID in
    there and shorten the titles. This makes it a lot easier to get what we
    want out.
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2021-10-16 Split out ApplicationShouldStart in aos/configuration.h
    This lets us iterate through all applications and see which ones are
    relevant a lot easier with less code duplication.
    [configuration.h]
2021-10-17 Tune shot table for close up
    We needed more points, and I think we tuned for the wrong distance once.
    [constants.cc]
2021-10-17 Update intake gear ratio
    It was too slow, so we sped it up. Retune the loop slightly and update
    the accel in joystick reader now that we can.
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2021-10-20 Add a skeleton extrinsics extractor
    This is meant to be a starting place for the extrinsics code. The
    process will be something like the following when all done:
    1) Extract all IMU readings and board positions and give them good times.
    2) Run an EKF over the readings with a set of both board and camera
    extrinsics and measure the error
    3) Wrap an optimizer around this error measurement to solve for the
    extrinsics.
    4) Figure out how to seed this all with decent initial guesses so
    everything converges easily.
    This only makes progress on 1) and probably has some extra debug code in
    the middle.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
2021-10-24 Improve localizer update debugging
    * Only send LocalizerDebug messages when something interesting happens.
    * On debug field, draw both the implied robot position of the update as
    well as the camera position.
    * Indicate accepted vs. rejected images via red/green colors.
    * Leave old corrections on the display for 2 seconds and gradually fade
    them out.
    * Add aggregate statistics about why we are rejecting image corrections
    to the readouts table.
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2021-10-24 Re-fixing the pitch calculation for extrinsics
    I fixed the pitch calculation for the camera, but forgot to update
    the sign of the pitch values (should be negative)
2021-10-25 Loosen gyro zeroing fault thresholds
    [imu_zeroer.h]
2021-10-25 Recalibrate hood after encoder broke
    It changed.
    [constants.cc]
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2021-10-25 Cleanup of extra call to load_camera_defintions
    We were doing it twice in lots of places.
    Small cleanup of intermittent issue with ints in drawing circles.
    Moved selection of camera_params using pi1, 971 robot to camera_definition
    Added defaults that use and require camera_params for pi1, 971 to be defined
2021-10-28 Correct hood zeroing calculations
    Used trig to find screw length based on hood angle, preventing incorrect
    estops. Calculations based on
    https://slack-files.com/T2752T5SA-F02JJ39RY03-f83f22b78d
    [absolute_and_absolute_encoder.cc, absolute_and_absolute_encoder.h, constants.cc, constants.h, static_zeroing_single_dof_profiled_subsystem.h]
2021-10-28 Lower the acceleration on the intake when jiggling the balls
    This should reduce wear on the pin in the intake by being less
    aggressive. Removing the jiggling causes balls to get stuck. It
    doesn't need to be aggressive to be effective.
    [profiled_subsystem.h, static_zeroing_single_dof_profiled_subsystem.h]
2021-10-29 Restrict turret motion so we don't over-tighten the cable
    We were allowing way too much motion, which was pulling the turret cable
    assembly tight. This was getting it caught. Stop doing that with the
    new range of motion.
    [constants.h]
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2021-10-29 Add SnappyEncoder/Decoder
    The encoder/decoder should work. Haven't actually hooked it into the log
    namer yet, though.
2021-10-30 Pull down noise on turret camera
2021-11-03 Fix reporting errors from ShmEventLoop falling behind before Run
    In this case, we try to send the timing report right before going
    down. If we haven't Run yet, that timing report may not exist.
    Skip in that case to avoid a follow-on and distracting crash.
2021-11-03 Print the path on JSON reading failure
    This makes it a lot easier to debug.
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2021-11-05 Squashed 'third_party/allwpilib/' changes from 66b57f032..e473a00f9
    e473a00f9 [wpiutil] Base64: Add unsigned span/vector variants (#3702)
    52f2d580e [wpiutil] raw_uv_ostream: Add reset() (#3701)
    d7b1e3576 [wpiutil] WebSocket: move std::function (#3700)
    93799fbe9 [examples] Fix description of TrapezoidProfileSubsystem (#3699)
    b84644740 [wpimath] Document pose estimator states, inputs, and outputs (#3698)
    2dc35c139 [wpimath] Fix classpaths for JNI class loads (#3697)
    2cb171f6f [docs] Set Doxygen extract_all to true and fix Doxygen failures (#3695)
    a939cd9c8 [wpimath] Print uncontrollable/unobservable models in LQR and KF (#3694)
    d5270d113 [wpimath] Clean up C++ StateSpaceUtil tests (#3692)
    b209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
    [DriveTrain.h, constants.h, math.h, util.h]
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2021-11-06 Switch away from watchers in autonomous
    Since auto is blocking, they never get run. The end result is that we
    crash auto when it finishes.
2021-11-06 Enable snappy compression in logger
    In doing so, increase the parameterization of logger_test a bit, so up
    the shard count.
    [logger_main.cc]
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2021-11-07 Stop the ball a bit more when preloading
    We've seen a couple of balls trapped past the sensor and jammed into the
    roller. We aren't seeing them too short, so up the limit.
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2021-11-08 Make test interpolation table match replay log
    This broke master
    [constants.cc]
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2021-11-08 Retune finisher to not oscillate
    There is a small overshoot which appears to be battery or falcon
    related, but everything looks a lot smoother and in phase. I don't see
    the wild oscillations we were seeing before.
    The plus side is that this appears to have made the ball counter work a
    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
2021-11-08 Improve the error when you change the TimeConverter
    We were exploding with a miss-matched UUID error when the problem was
    that the time converter changed. Instead, print out a more useful
    error which is easier to fix.
2021-11-10 Add and test TryMakeFetcher, TryMakeSender, and NodeHasTag helpers
    Using a Fetcher for a channel on nodes where it exists and triggering
    logic to handle other nodes based on whether the fetcher is valid works
    well for some use cases. Add a method to EventLoop to support that
    directly, instead of forcing the caller to redo the logic around whether
    a channel exists and is readable. Basing similar logic off whether the
    node has a given tag is also fairly common.
    In the process, fill out the EventLoop tests around channels that don't
    exist or aren't readable/writable a bit better.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
    [configuration.h]
2021-11-10 Combine 2 LZMA encoder errors
    Let's deduplicate these warnings where we can so the actual errors are
    easier to find.
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2021-11-13 Extend the table a bit further
    Vision sometimes reports us being a bit far. Ignore the error and use
    the same far shot.
    [constants.cc, constants.h]
2021-11-17 Make SkipTimingReport and DisableStatistics actually work
    New event loops were not respecting the previous SkipTimingReports on
    the factory. Close that hole.
    DisableStatistics was sending 1 statistics out at the beginning too.
    Close that hole too.
    I want to add a test that requires the following behavior to stay
    working. Let's test that this behavior continues to work as expected as
    well in regards to the MessageBridgeServer and MessageBridgeClient and
    Timestamp and RemoteMessage messages.
2021-11-18 Handle local messages sent before remote messages after reboot
    We only generate points in the time interpolation function (and
    therefore only discover reboots, since a reboot can only happen at a
    point). When there is data in a log before remote data, we don't
    generate these points, and therefore can't replay the log.
    F1118 00:05:39.808653 14 log_reader.cc:690] Check failed: monotonic_now == timestamped_message.monotonic_event_time.time : { "name": "pi2", "hostname": "raspberrypi2", "port": 9971 } Now 107.005000000sec trying to send {.boot=1, .time=107.000000000sec} failure node 1 (pi2) [
    ] queued_until {.boot=1, .time=109.210150000sec}
    node 0 remote_data [
    channel 0 [
    {.channel_i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
2021-11-20 Handle adding boot 0, 0 before boot 0, 1
    Even though we hadn't popped anything, we were unwilling to insert
    anything at the 0th position. This was a bug in the accounting for what
    we have popped. We were unwilling to insert before the *current*
    element, but defaulted the current to 0 even before anything was popped.
2021-11-20 Recal turret after mechanical didn't reset the climber
    Everything slipped...
    [constants.cc]
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2021-11-24 Error more gracefully in logfile sorting if 2 servers fight
    If 2 computers have the same IP address, the client will flip flop
    between them. This could happen if 2 laptops are configured as the
    logger node and are swapped back and forth, or various other patterns.
    In this case, the timestamp problem is poorly formed and ends up failing
    pretty horribly. While we could try to figure out how to replay the
    world during that time, in reality this isn't a problem we should be
    solving. We can catch this during logfile sorting and explode with a
    much better error.
    Connected to node A
    Connected to node B
    10sec - 20sec
    20sec - 30sec
    30sec - 40sec
    In the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
2021-11-27 Create an enum for sender errors
    Will replace usages of bools, and will now currently only be used
    for indicating that messages were sent too fast
    After we merge this commit we will replace this enum with a general
    Status class for all of aos, similar to absl::Status.
    [control_loop-tmpl.h, drivetrain_input.cc, sensor_reader.cc]
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2021-12-07 Prevent Python from importing the host's pip packages
    This patch prevents Python from searching the user's installed pip
    packages as well as the host's `site` package. The host's `site`
    package normally performs the setup necessary to allow importing
    globally installed pip packages. We don't want that.
    From the upstream documentation:
    https://docs.python.org/3/using/cmdline.html
    -s
    Don’t add the user site-packages directory to sys.path.
    See also PEP 370 – Per user site-packages directory
    -S
    Disable the import of the module site and the
    site-dependent manipulations of sys.path that it
    entails. Also disable these manipulations if site is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
2021-12-08 Open up timing parameters for another shm_event_loop_test case
    Been having problems with it missing the second timer iteration (so it
    only gets the first and third ones).
2021-12-11 Inline QueueUntil for performance
    Profiling is showing that there is a std::function being created and
    destroyed in the critical path in the timestamp problem that is consume
    a couple percent CPU. Template it to let the compiler inline it all.
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2021-12-19 Initial schematic and pcb commit for Pico IMU in kicad
    [RspPiPicoIMU-B_Cu.gbl, RspPiPicoIMU-B_Mask.gbs, RspPiPicoIMU-B_Paste.gbp, RspPiPicoIMU-B_SilkS.gbo, RspPiPicoIMU-Edge_Cuts.gm1, RspPiPicoIMU-F_Cu.gtl, RspPiPicoIMU-F_Mask.gts, RspPiPicoIMU-F_Paste.gtp]
2021-12-19 Add boost/buck v2 to enable IMU communications
    This interfaces with the new IMU board over differential SPI
    [RspPiPS.pcb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]
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2022-01-02 Remove blasfeo, boost, ct, cgal, and hpipm
    New Clang disagrees with the cgal version we had. The only reverse
    dependencies were failed experiments anyways, so just remove it.
    Everything else had the removed things as its only dependents, so remove
    it all.
    [dlqr.h]
2022-01-02 Reduce gsl::span usage so we can remove it
    We already have absl::Span, no need to add more animals to the zoo.
    This should let us delete 2 libraries out of third_party.
    While we are here, the teensy code for 2019 wasn't being built. Fix
    that.
2022-01-04 Clean up toolchain_config.bzl a bit
    Upstream removed objcopy_embed_flags:
    https://github.com/bazelbuild/bazel/commit/cc7b7360b0dc9b94caa5bfc587be270d67fe9558
    Fix the formatting of the if statements, to make it easier for me to
    clean them up as I remove the k8 parts while switching toolchains.
2022-01-11 Add backpressure to web_proxy
    Implement things such that the client will send back what it has
    currently processed on a given channel. The server will then avoid
    sending more than 10000 messages ahead of that point.
    Also, fix up some memory management to ensure that data channels
    actually get closed/destroyed at the end of a browser session.
2022-01-14 Fix a comparison error in the timestamp filter
    We had a valid set of timestamps, but they were actually being marked as
    invalid.
    Times can't be compared by 0ns
    {.boot=0, .time=555.300152239sec} vs {.boot=0, .time=555.300152239sec} -> 0ns
    {.boot=0, .time=518.828208361sec} vs {.boot=0, .time=518.828208361sec} -> 0ns
    {.boot=0, .time=518.840353937sec} vs {.boot=0, .time=518.840353937sec} -> 0ns
    {.boot=0, .time=518.693828874sec} vs {.boot=0, .time=518.693828875sec} -> -1ns
    {.boot=0, .time=518.802664705sec} vs {.boot=0, .time=518.802664705sec} -> 0ns
    {.boot=0, .time=518.739140127sec} vs {.boot=0, .time=518.739140127sec} -> 0ns
    (Previous, next is the order that they are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
2022-01-24 Rev 3 with LED driver pwm output
    [RspPiPS.pcb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]
2022-01-25 Replay log files without start times
    We were trying to solve the timestamp problem for them unsuccessfully.
    Turns out our solver isn't a bit fan of solving for min_time...
    These times make no sense to have in our interpolation table, so just
    don't solve for them.
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2022-01-30 Write out correct pathname for image used in training
    For now, this is very helpful in making sure we're training with the
    right images. Changing debug->log, and stripping off path basename
    Also, moving calib info to debug, since this will fail properly in
    runtime if hte calibration isn't there.
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2022-02-04 Don't put reliable timestamps in the unreliable log file header field
    James and I debugged a log file sorting bug which turned out to be a
    logging bug. The SystemParameters timestamp file (which we can all
    agree is a reliable message) had the delivery time in
    oldest_unreliable_remote_monotonic_timestamps, which is only for
    unreliable timestamps.
    This was because reliability was being tracked for the contents channel,
    not the source message. Instead, we need to do the book-keeping to
    track if the source is realiable or not, and update the header
    accordingly. While we don't want to see new combined timestamp logs, we
    still need to support them. We don't mind if they are a bit less
    efficie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
2022-02-05 Make the pico IMU fail more gracefully
    It still sends out encoder values when the checksum doesn't match
    and reset the imu if the checksums are weird for a bit
    [ADIS16505.cc]
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2022-02-05 Fixing a couple small issues with viewer
    Use Fetch() instead of FetchNext(), since we can sometimes fall behind
    and we don't want to be always looking for old images
    Removed default png directory name, so it defaults to doing normal viewing.
    Created return image, since it doesn't properly handle otherwise.
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2022-02-06 Add arm64 support
    This patch adds `--config=arm64` and `--cpu=arm64` flags for users to
    compile for the 64-bit version of the Raspberry Pi.
    The existing 32-bit ARM build should still work. This patch only adds
    additional 64-bit capabilities. Future patches can remove 32-bit
    support.
    Eigen needed some tweaks because we have `LDBL_MANT_DIG` of 113 on
    arm64. None of the code paths that used the parameters `U` and `V`
    actually gets compiled in. Adding `[[maybe_unused]]` fixed the error.
2022-02-07 A couple fixes to viewer
    Changed to use Fetch() instead of FetchNext(), which was crashing
    Properly initialize the target_estimate_fetcher
    Only call DrawBlobs and display blob image if we have estimate
    Send proper size image into DrawBlobs
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2022-02-13 Upgrade bazel to 5.0.0
    These are the commands I used to generate the bazel xz file:
    $ wget 'https://github.com/bazelbuild/bazel/releases/download/5.0.0/bazel-5.0.0-linux-x86_64'
    $ xz bazel-5.0.0-linux-x86_64
    $ mv bazel-5.0.0-linux-x86_64.xz bazel_5.0.0.xz
    I had to tweak `.bazelrc` a bit because some options were promoted
    from experimental status to non-experimental status. A couple of
    incompatible flags are gone now too.
    I had to change some of our Java setup as per
    https://github.com/bazelbuild/bazel/issues/7849. It's not obvious to
    me that I did it correctly, but bazel doesn't seem to complain about
    the new options I added.
    The `--watchfs` in `tools/ci/buildkite.yaml` was g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
2022-02-13 Fix wrapping on pico IMU pwm
    Using modulo to keep the heading between 0 and 360 was allowing it to go
    negative then getting cast to an unsigned int. It *almost* had the right
    behavior, but there was a 16 degree range below zero where it was
    getting rounded to 0.
    [ADIS16505.cc]
2022-02-13 Send 2022 encoder values in meters
    Be more consistent with how the drivetrain position message manages
    things and just convert to meters.
    This doesn't break logs, because no logfiles with the int-based encoder
    counts exist.
    [constants.h, imu.cc]
2022-02-14 Invert Intrinsics Calibration
    Look at camera motion instead of board motion
2022-02-16 Delete platform_mappings and switch to platform suffixes
    As far as I can tell, we only stuck with the `--cpu` legacy mechanism
    to get different output bases for each platform. This can be achieved
    with `--platform_suffix` as well.
    I want folks (especially students) to move away from thinking about
    compiling for specific CPUs. Instead the students should think of
    target platforms. Along the lines of "I want to build for the Pi"
    instead of "I want to build for an armv7 machine". The renaming of
    config options will happen in a future patch. This patch just changes
    everything over to use equivalent config options.
    Sample paths for Linux-based targets:
    $ for config in k8 roborio armv7 arm6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
2022-02-17 Add fbs files and config modifications for localizer
    Creates a LocalizerStatus channel for the status, a LocalizerOutput for
    the minimal output to be forwarded to the roborio for it to correct its
    localizer, and adds an IMUValuesBatch channel on an imu pi.
    Does not yet remove the old IMUValuesBatch channel in y2022.
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2022-02-19 Adding a camera_id to our intrinsic calibration file
    We'll need to manually label and track these, since the pi cameras
    don't have an internal serial number (as best I can tell).
    I think this is important, since we can swap cameras between pi's
    and it's hard to be sure we've got the right calibration based on
    pi hostame.
    Including calibration files for cameras 22-01 to 22-07
    Added a little detail to the CHECK, since it wasn't very clear
2022-02-19 Create y2022 localizer
    TODO:
    * Update Roborio's localizer to listen to LocalizerOutput messages.
    * Actually listen to camera messages.
    * Correct the interface between this and the pico-reading process for
    encoder values.
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2022-02-20 Add the catapult simulation and design code
    This is mostly shamelessly stolen from rotory system. It is different
    enough because we have different control goals to not warrent being
    lumped with the rotory system.
    This lets us compute final speeds given the gear ratio and masses,
    letting us optimize the gear ratio.
    This gives us a model to start using when writing the optimization
    problem for the fixed horizon MPC for shooting.
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2022-02-21 Squashed 'third_party/eigen/' changes from cf794d3b74..3147391d94
    3147391d94 Change version to 3.4.0.
    115591b9e3 Workaround VS 2017 arg bug.
    fd100138dd Remove unaligned assert tests.
    1ec173b54e Clearer doc for squaredNorm
    aef926abf6 Renamed shift_left/shift_right to shiftLeft/shiftRight.
    f1032255d3 Add missing PPC packet comparisons.
    f57dec64ef Fix unaligned loads in ploadLhs & ploadRhs for P8.
    926e1a8226 Update documentation for matrix decompositions and least squares solvers.
    cd474d4cd0 minor doc fix in Map.h
    0b56b62f30 Reverse compare logic in F32ToBf16 since vec_cmpne is not available in Power8 - now compiles for clang10 default (P8).
    44cc96e1a1 Get rid of used uninitialized warnings f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
    [main.h]
2022-02-21 Add LED Driver PCB, Schematic and gerbers. Ver 1.0
    [10 SIZE CODE G-L.stp, 430450601.stp, EEHAZF1E271.step, LED-Current-Regulator.kicad_sch, LUXEON_2835_20160407_STEP.STEP, SRP3020C-1R0M_BRN.step, boost.kicad_sch, led-ring-driver-BOM.xlsx]
2022-02-23 Squashed 'third_party/allwpilib/' changes from e473a00f97..e4b91005cf
    e4b91005cf [examples] Update SwerveModule constructor doc (NFC) (#4042)
    a260bfd83b [examples] Remove "this" keyword from SwerveModule (#4043)
    18e262a100 [examples] Fix multiple doc typos in SwerveControllerCommand example (NFC) (#4044)
    4bd1f526ab [wpilibc] Prevent StopMotor from terminating robot during MotorSafety check (#4038)
    27847d7eb2 [sim] Expose GUI control functions via HAL_RegisterExtension (#4034)
    b2a8d3f0f3 [wpilibc] Add mechanism to reset MotorSafety list (#4037)
    49adac9564 [wpilib] Check for signedness in ArcadeDriveIK() (#4028)
    a19d1133b1 [wpiutil] libuv: Fix sign compare warnings in gcc 11.2 (#4031)
    dde91717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
2022-02-24 Add Flipper Arms Wpilib_Interface
    [constants.cc, constants.h]
2022-02-24 Add current IMU driver to git
    This is a combination of what James, Ravago, Henry, Het and I all wrote.
    It appears to be working well enough.
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2022-02-26 Rename config.json to aos_config.json
    Plenty of other things are called config.json, so let's pick a more
    unique name.
    [configuration.h]
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2022-02-26 Deploy IMU driver and configure IRQs
    The IRQs didn't match the existing IRQs. Update them to be more
    flexible and not depend on IRQ numbers since those appear to change.
    wiringpi wasn't building for me, so I built the .deb and installed that
    in the rootfs so I could make progress again.
    While we are here, deploy to ~/bin instead of ~/robot_code/ so it is in
    the path everywhere. To make things actually easy to use, we need to
    change how the config is found, but until then, this gets us closer to
    easy to use.
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2022-02-26 Remove aos::ComplexThreadLocal
    We no longer need it with the built in language thread_local.
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2022-02-26 Fix y2022 drivetrain encoder ratio
    The encoder is direct-drive off the wheels, not the Falcons.
    [constants.h]
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2022-02-26 Tune down estimator for ADIS16505
    * Update down_estimator_plotter for the ADIS16505 setup (would be
    nice to refactor things to make it so that you can apply a plot
    config to a particular submessage type...).
    * Crank up the threshold to consider the IMU still, to avoid resetting
    in the middle of real motion.
    * Also check in the IMU transform from the jankily-mounted IMU on the
    2020 robot.
2022-02-26 Add catapult MPC and controller class
    We want to shoot with the MPC, but we want to decelerate and reset with
    a more traditional controller. So, transition to the MPC, and back to a
    profiled subsystem.
    This makes some tweaks to the solver to get it to converge more
    reliably. There's apparently a scale factor which was scaling down the
    cost matrices based on the initial p matrix, causing it to not solve
    reliably... Good fun.
    [constants.cc, constants.h]
2022-02-27 Initial tuning/cleanup of 2022 localizer
    This is based on some data collection off of the 2020 robot with the IMU
    somewhat loosely mounted. Should behave reasonably--when the wheels are
    not slipping, this currently tends to be less precise than traditional
    methods, but otherwise behaves reasonably, and does handle substantial
    wheel slip reasonably.
    General changes:
    * General tuning.
    * Update some 2020 references to refer to 2022.
    * Unwrap the encoder readings from the pico board.
    * Make use of the pico timestamps.
    Next steps are:
    * Adding actual connectors for image corrections.
    * Making the turret able to aim.
    * Tuning this against driver-practice based IMU readings--use TODOs
    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
2022-02-27 Set IMU pin as input pin when using camera
    If we don't set this as an input, it interferes with our PWM signal
    Also, setting LED duty_cycle to 0.25, to make it less blinding
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2022-02-27 Add collision avoidance
    Makes sure that the intakes dont collide with the back of the catapult
    [constants.h]
2022-02-27 Create CANPosition sender
    Read the velocity of the integrated sensor on the flipper arms over can
    and send it in it's own position message
2022-02-27 More fixes to make imu node logs standalone
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2022-03-02 Create /home/pi/bin directory and updating some calibration files
    Fixed problem with changing team number for imu line in /etc/hosts
    Things that are coming up during pi bringup / testing
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2022-03-03 Migrate //scouting:scouting_test to Protractor
    This framework automatically takes care of the webdriver/selenium
    setup. It just lets us focus on writing tests.
    This patch migrates the scouting test to use Protractor. It validates
    that the application loads correctly and displays the only message
    that exists so far.
    I can confirm that that test uses a sandboxed version of the chromium
    browser:
    $ bazel cquery 'somepath(//scouting:scouting_test, @org_chromium_chromium_linux_x64//:metadata)' 2>/dev/null
    //scouting:scouting_test (cdf6808)
    //scouting:scouting_test_chromium-local (cdf6808)
    @io_bazel_rules_webtesting//browsers:chromium-local (3ee7ec9)
    @io_bazel_rules_webtestin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
2022-03-04 Adding a few more calibration files
    Identified, but haven't fully fixed the issue that was hanging the
    calibration-- drawAxis unhappy when board origin is near z=0 in camera
    frame
    Also, gave some more indication to user of what needs to be done during
    calibration
2022-03-05 Correct sensor and motor ports
    Set ports as described here:
    https://docs.google.com/spreadsheets/d/13GmcwecwOB2_6oZBmfoExJfj6lFXFfovuppyIwpIxW4/edit?usp=sharing
    Added TODOs for the ones that still haven't been decided.
2022-03-05 Move the spline UI origin to match the localizer
    The origin is now in the center of the field instead of the top left
    The y-axis is also flipped so that up is positive
    And everything is in meters now
2022-03-05 Start up applications correctly on the imu node
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2022-03-05 Fix left and right flipper arms being swapped.
    [constants.cc]
2022-03-05 Calibrate 2022 robot
    Flip the intake up/down direction to be easier to measure.
    [constants.cc, constants.h]
2022-03-06 Fix turret limits for 2022
    [constants.h]
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2022-03-06 Flip heading and yaw rate to match the hardware
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2022-03-06 Clean up some styling in scouting app.
    Correctly set columns for scores.
    Switch margin to padding to not mess up bootstrap styles.
    Add back button on screens that can go back.
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2022-03-06 Expand //scouting:scouting_test to go through almost the full flow
    The test now gets up to the point of submitting the data.
    Unfortunately, the webserver doesn't know how to handle the data yet.
    So we don't actually submit anything.
    I removed the timeouts from the test because protractor appears to
    automatically wait for actions to finish before continuing.
2022-03-06 Fix superstructure ball lost checking
    Before, we were only checking if a ball was lost when we were idle or
    transferring. Handle the case where we loaded one ball, but intaked
    another and lost it.
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2022-03-06 Flip flipper pot direction
    Negative was out...
    [constants.cc]
2022-03-06 Flip drivetrain direction so left is left
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2022-03-07 Limit blob debug output in 2022 camera_reader
    If we got a huge number of blobs, camera reader would crash because of
    trying to allocate too large of a flatbuffer message.
    Also, the TargetEstimate message does need to make it across the network
    without too high of latency, so excessive debug information in it would
    be sub-optimal.
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2022-03-08 Fix logfile sorting to not count boots with no time
    We were getting:
    Check failed: update_count <= node_state.second.boots.size() (3 vs. 2) : Found a cyclic boot graph, giving up.
    @ 0x7de81f google::LogMessageFatal::~LogMessageFatal()
    @ 0x471abd aos::logger::PartsSorter::ComputeBootCounts()
    @ 0x471e36 aos::logger::PartsSorter::FormatNewParts()
    ...
    Digging in, we had max_time in one direction, and were sorting against
    that. This was creating a loop. This was coming from the reverse
    direction (local -> remote, inside reverse_boot_times) instead of the
    normal forward direction.
    Sorted destination tim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
2022-03-09 Bringup progress
    Here's how far I got bringing the robot up. Turret needs to be
    re-calibrated again, it keeps slipping.
    [constants.cc, constants.h]
2022-03-09 Squashed 'third_party/rules_rust/' content from commit bf59038ca
    git-subtree-dir: third_party/rules_rust
    git-subtree-split: bf59038cac11798cbaef9f3bf965bad8182b97fa
    [config.txt]
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2022-03-12 Undelay our status X_hat
    There are 2 steps in the Kalman Filter. Predict and Correct. We
    typically run Correct, compute our controller value, and then run
    Predict.
    Previously, we were grabbing the Predicted value on the cycle before it
    was correct. This means we were publishing our best guess at where the
    state would be next cycle instead of the state we used. This isn't
    particularly helpful...
    [profiled_subsystem.h, static_zeroing_single_dof_profiled_subsystem.h]
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2022-03-12 Wait until the flippers are more open
    This makes the shot more consistent
    [constants.cc, constants.h]
2022-03-12 Add a back button to scouting auto screen.
    Also correctly align next button on initial page.
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2022-03-12 Add flipper voltage to y2022 superstructure plot
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2022-03-12 Fix encoder signs/sides for pi localizer
    [imu.cc]
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2022-03-13 Re-calibrate turret
    No clue why it slipped...
    [constants.cc, constants.h]
2022-03-13 Disable the flipper velocity sensor
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2022-03-13 Fill in contours to avoid holes in blobs
    Prevents us from detecting multiple blobs in one.
    Also don't require more green than blue because of glare.
    Combining these two removes holes in all the images from bellarmine.
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2022-03-14 Don't latch IMU faults in 2022 localizer
    We get occasional checksum failures. Don't brick the localizer because
    of that.
    [imu_zeroer.cc, imu_zeroer.h]
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2022-03-14 Fix all the climber signs and make them all work
    Now that the HW exists, let's do it. Zero is all the way down against
    the hard stop.
    [constants.cc, constants.h]
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2022-03-14 Fix reading gyro on roborio
2022-03-14 Fix roller voltages in autonomous
2022-03-14 Don't give the profile a velocity
    We don't support velocities, and it crashes when we do that. Stop it.
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2022-03-14 Use correct pi index for led output
2022-03-14 Use correct extrinsics in 2022 camera reader
2022-03-14 Fix flakiness of //scouting:scouting_test
    I ran the `//scouting:scouting_test` 10'000 and got 6 failures.
    They all had messages like this:
    2022/03/13 23:41:36 Error calling ListenAndServe(): listen tcp :36144: bind: address already in use
    The protractor framework finds a random port for the webserver to use.
    After it finds an available port, it starts the webserver and tells it
    about the port to use with the `--port` argument. The problem here is
    that before the webserver has a chance to claim the port, another
    process that grabs random ports can come in and claim the same port.
    This patch fixes the race condition by using the fixed port of 6060.
    This port is outside of the random por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
2022-03-17 scouting: Add more high-level fields to the scouting app
    This patch adds the following fields that can be selected by scouts:
    - No show
    - Never moved
    - Battery died
    - Broke (mechanically)
    - Lost coms
    I haven't hooked them up to the database yet because I want
    confirmation that this is what we want first. A future patch will hook
    those to the database.
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2022-03-17 Add client to constructor of led_indicator
    didnt do it in the beginning so it broke
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2022-03-17 Fix auto-aiming when turret range doesn't include [-pi, +pi]
    Rather than assuming 0.0 is the center of the range, actually use the
    middle of the range.
    Also, fixed the fact that we were using the hard stop range instead of
    the soft stop range in software limit calculations.
    [constants.h]
2022-03-18 scouting: Ask the user to reload after submitting match data
    The current "Home" screen doesn't tell folks what to do. It's not
    obvious that they have to reload the page at this point. This patch
    changes the screen to ask the user to reload the page.
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2022-03-22 Squashed 'third_party/flatbuffers/' changes from 338393f85..e5f331db9
    e5f331db9 [TS] Add single-file ts codegen & bazel rule for typescript (#7161)
    2f84c6038 Apply Namer to Go code gen (#7150)
    d64839651 [Lobster] file_identifier support
    777e78d8d [Lobster] support unsigned integer reads
    4016c549d Apply Namer to Python code gen (#7146)
    40827b21b Fix missing 'break' (#7151)
    65a10b6e3 Implement a config based name manager and use it in Rust codegen (#7144)
    8db2fef3f [TS] Escape keywords in typescript object names (#7137)
    9ed132304 Fix 64-bit numeric enum values in typescript (#7135)
    1a4c40566 updated npm to 2.0.6
    318594e4b prevent name clash (#7133)
    3d903302c [Rust] Add length checks to arrays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
    [util.h]
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2022-03-25 Fix browser cache issues with the scouting app
    Before this patch, folks had trouble getting the latest version of the
    scouting app when visiting https://scouting.frc971.org/. The reason
    for that is that they used the `Last-Modified` timestamp of the
    individual files to determine whether they need to be fetched. Because
    of `pkg_tar()`'s reproducibility, the timestamp is always the same.
    This patch works around this by adding a `touch` step to the package's
    `postinst`. This step updates the `Last-Modified` time of each
    deployed file to the current time. In essence, every time the scouting
    app is deployed, users should now see the latest version.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
2022-03-26 Correctly handle corrupted encoder readings in localizer
    Also, tune down image corrections and remap channels in replay.
    This does not fix the yaw issues.
2022-03-26 Better handle missed IMU messages in localizer
    Increase the max dt to better handle dropped messages.
    Also, more explicitly track the reasons why different messages were
    dropped. The current main culprits seem to be (a) messages missing
    entirely and (b) Pi <-> PICO checksum failures.
2022-03-26 Add deadband to pistol grip inputs
    This allows the robot to actually be still when stopped, which helps the
    localization reset when we do stop during a match.
    [drivetrain_input.cc]
2022-03-26 Add climbing level to database
    I spent a lot of time trying to make this use enums for the entire
    data path. Unfortunately, I ran into a few issues. Firstly, I couldn't
    figure out how make our Go SQL code happy with postgresql enums. I
    kept getting errors about `unknown oid`. Secondly, I couldn't figure
    out how to de-duplicate the enum between `submit_data_scouting.fbs`
    and `request_data_scouting_response.fbs`. The generated Go code
    doesn't import the dependency properly.
    All this turned into an enum at the flatbuffer and TypeScript level,
    but just an integer at the Go/postgres level.
    A future patch can deal with this. Perhaps it'd be better to ignore
    this altogether and just switch to a l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
2022-03-27 Fix non-reliable messages in live plotter
    When improving reliability of the plotter, I had added flow-control for
    reliable messages. Unfortunately, this also meant that if you opened the
    plot too long after the queues started, it would spend the entire time
    thinking it was being flow-controlled.
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2022-03-27 Manually compute euler angles from extrinsics
    For pi4 (yaw of -90 deg), the euler angles extracted from the
    extrinsics were offset by pi.
    Compute the euler angles constraining the pitch from [-pi/2, pi/2] so we
    get the correct solution and not an equivalent but incorrect one.
    This is probably the reason all pi4's estimates were 0 confidence, and
    we missed shots that had pi4 pointing at the target before the
    main aiming pi, pi3.
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2022-03-27 Remove 1 cycle delay in FPGA writes
    The FPGA is only taking updates to lengthen the cycle before the next
    cycle starts. This is adding 1 cycle of delay when decelerating our
    catapult.
    The FPGA supports changing the period. So, we can set the period to
    1/2, and then skip every other period. This produces the same waveform,
    but effectively updates the active FPGA value more frequently.
    [sensor_reader.cc]
2022-03-28 Bring back use_outdoors flag
    In the cafeteria the lighting is very different, and color filters and
    exposure need to be changed to lower noise.
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2022-04-01 Handle only one side coming back when rebooting.
    We had a case where messages were only flowing to the logger node after
    a reboot, and the other direction never came back. This was never
    getting observed, so we never solved for the next boot, and failed to
    replay.
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2022-04-02 Make new LED indicator not crash.
    event_loop wasn't being initialized.
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2022-04-03 Recalibrate after intake replacement on comp
    [constants.cc]
2022-04-03 Fix spit button to not be quickturn
2022-04-03 Fix send_too_fast failures in 2022 configuration
    We were a bit close on a couple of forwarded channels. Up the rate.
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2022-04-03 Fix handling of image vs pico timestamps in localizer
    The localizer internally operates off of "pico time" because
    we use the pico timestamps for accelerometer dt. However, since
    we only calculate the pico offset once at boot, we don't
    want to allow pico <-> pi time drift to affect processing of images.
2022-04-03 Let users switch scouting app tabs when on tabs without data entry
    I was getting annoyed constantly clicking OK when switching from Match
    List to Data Entry even though there's no possible data loss. This
    patch makes it so switching away from Match List no longer creates a
    popup. I also added this behaviour for Import Match List because the
    only thing users enter there is the event code. That's nothing to
    worry about in terms of data loss.
2022-04-06 Improve starter_test stability
    If the timing was wrong, we'd query the process name *immediately* after
    the fork(), and then never fix it. Instead:
    (a) Update the name if it ever changes; and
    (b) Make the test ensure that it gives time for a second reading to
    happen before checking the process_info.
    Additionally, there was a race condition in making the calls to
    Cleanup() in the tests. Move that call into the same thread as
    the rest of the starter work.
2022-04-06 Track send failures in timing reports
    Previously, there was no external indication of the number of
    failed sends. Start tracking failures by cause, so that
    we have at least some visibility.
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2022-04-09 Rework primary keys in the match list scouting database
    We don't need a separate ID for the rows in the match list table. We
    really just care about a unique combination of `MatchNumber`, `Round`,
    and `CompLevel`.
    This will make it easier to update an existing match list. We
    currently don't support this.
2022-04-09 Allow users to re-import the match list in the scouting app
    We currently append the match list to the existing data in the table.
    This patch makes it so the entries are replaced instead of duplicated.
2022-04-14 Skip logging the driver camera
    It saturates our USB thumbdrive bandwidth, and the logger gets behind
    and crashes.
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2022-04-15 Speed up catapult
    We got a new gear ratio. Fix some state machine transitions as well to
    let us reload the catapult while grabbing the next ball, and to fire
    immediately too.
    [constants.cc]
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2022-04-16 Fix /camera config remappings for logger node
2022-04-16 Use correct intrinsics for pi-9971-4
    At some point it ended up with che 22-07 camera.
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2022-04-16 Tune new shot table with final battery compensation turned off
    Turns out, battery compensating the last cycle of the control loop was
    causing accuracy problems, especially under load. Turn that off just
    for the end and retune all the shots.
    [constants.cc]
2022-04-17 Recalibrate practice bot after turret slipped
    [constants.cc]
2022-04-17 Fix config for faster vision code
    We can now actually hit 30 hz
2022-05-02 Track separate reliable and unreliable timestamps for sorting
    This sets us up to use unreliable and reliable timestamps for figuring
    out which boot comes first when only reliable timestamps are available
    from a boot. This should be no functional change other than
    book-keeping, and potentially making some older logs with only reliable
    timestamps hard to read. (though those logs have other challenges too)
    Since we are no longer looking at the pre-combined field available in
    older logs, we will only be able to sort logs with just reliable times
    after the addition of oldest_local_reliable_monotonic_timestamp.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
2022-05-03 sctp_client: don't bind to the socket
    Binding to the socket appears to be Mostly Harmless, but
    the proper sequence for a one-to-many client in this style is:
    1. socket()
    2. sendmsg()
    3. recvmsg()
    4. close()
    Per
    https://www.man7.org/linux/man-pages/man7/sctp.7.html
2022-05-03 events/ping-pong: clarify error reporting
    Without this change, late pong packets look like duplicate pong
    packets.
    Add a check for duplicates for pong just in case.
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2022-05-05 scouting: Make /sha256/ requests stricter
    Before this patch, requesting a file via its checksum only required
    the checksum itself. The path specified after the checksum was
    ignored. This meant that it was actually pretty easy to screw up the
    checksum with copy-paste errors.
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2022-05-11 Add logger version and sha1 to the logfile header
    This makes it a lot easier to track down where a failure came from.
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2022-05-12 Recalibrate robot for elims
    Things keep slipping...
    [constants.cc]
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2022-05-17 Clang-format aos
    It has drifted... Clean it up a bit.
    [index.cc]
2022-05-19 Fix aos cli autocomplete config check
    ReadConfig does the work of finding the config path, so it shouldn't be
    assumed to be in the current directory.
    [configuration.h]
2022-06-02 Prevent spurious /dev/shm/PostgreSQL.* files in tests
    By default the postgres server uses `shm_open(3)` to create shared
    memory to talk between workers. This means files directly inside of
    `/dev/shm`. Since that directory is one of the few (maybe only?)
    world-writeable and non-sandboxed directories, that means the server
    can leave behind these useless files.
    I investigated switching postgres to use the `sysv` mechanism for IPC,
    but that doesn't really help us here. That just creates shared memory
    segments that are even harder to track and clean up after a run.
    https://www.ibm.com/docs/en/aix/7.2?topic=s-shmget-subroutine
    > Once created, a shared memory segment is deleted only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
2022-06-23 Add sort capability to aos_starter status.
    Add FLAGS_sort string flag for user to specify column name to sort on.
    Add new SortApplications() helper to key off FLAGS_sort to sort the
    vector of ApplicationStatus structs on correct field.
    Update GetAllStarterStatus() to call sort helper before printing output.
2022-06-25 Allow full expansion of AOS messages
    The -pretty flag in aos_dump is intended to unwrap AOS messages to
    one field per line, but doesn’t fully do so for all messages. Add
    a flag to force unwrapping to one field per line.
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2022-06-28 Add reverse name lookup for channels
    This makes it so that if you know the fully-resolved channel name you
    can figure out all the possible ways that it can be referred to. This is
    potentially useful for a variety of things, including:
    * Config validation (e.g. identifying all the channels that exist
    on the /aos/remote_timestamp/* namespace, to determine if there are
    any extraneous channels).
    * Improving auto-complete for command-line utilities.
    * Adding more options for how channel names are presented in
    log-analysis tools (e.g., currently foxglove doesn't support the
    concept of channel maps/aliases/whatever, so making node-agnostic
    plots is irritating).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
    [configuration.h]
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2022-07-22 Update the constraints to enforce the worst case slew
    When we have a period with no observations in a log file, we used to
    assume that time slewed at a rate that connected the observations with a
    line. For long enough periods of time, this ends up being pretty wrong.
    We need to actually enforce what our guarentees are. That the solution
    is bounded by the worst case slew, which is a V connecting the two
    samples using the max slew rate as the slope. Anything crossing that V
    is wrong by construction, and anything inside it is actually valid,
    though it might be a bit weird.
2022-07-22 Add a way to get the error to the bounds to NoncausalTimestampFilter
    Now that we can compute the worst case offset, we want to be able to use
    that worst case when enforcing bounds. Expose it in a function, and add
    a test.
2022-07-25 Switch from kMaxVelocity to 128 bit math
    We had a lot of dy < dx * kSlope, where we can instead do
    dy * slope_denominator < dx * slope_numerator in full integer math and
    get it to come out perfectly. Since we've already debugged one
    convergance problem caused by rounding, let's not let any more in.
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2022-08-09 Create a Rust API for part of //aos:configuration
    [configuration_for_rust.h]
2022-08-11 Enforce channel message limits when building configs
    We only support 2^16-1 messages/channel. Enforce this when building the
    configuration, rather than at runtime in the simulation. This will
    make the errors cleaner and more direct.
    [configuration.h]
2022-08-12 Fix AOS support for realtime replay
    This patch fixes the use-case where you provide a single event loop and
    just want to replay logged events from the perspective of that event
    loop's node.
    Includes a test running a ShmEventLoop against a single-node logfile,
    and running a multi-node replay into a single EventLoop in
    simulation (the choice of single vs multi node here is arbitrary--it
    should work with both single and multi node configs in both
    simulation and shm).
    This has a few caveats:
    * Doesn't replay remote timestamps currently.
    * Doesn't correct for implied changes in node<->node offsets due to
    changes in the clock.
    * Had to add a flag to choose how to manage fetcher behavior for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
2022-08-12 Require non-negative times for AOS timers
    Linux doesn't like negative monotonic clock times, so disallow them.
    In order to support this, LogReader now does not schedule events at
    times known to be in the past (this should be a no-op for simulated
    event loops, but for realtime replay with non-zero clock offsets will
    avoid scheduling events too far in the past).
    References: PRO-14846
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2022-08-12 Run buffering in separate thread for realtime replay
    This improves timing accuracy in replay substantially
    by running all the buffering up of log messages in a separate thread.
    This adds an additional buffer past the channel_storage_duration
    required for strict correctness, so that the replay has a higher chance
    of keeping up.
    The threading model feels a bit tenuous, since I didn't see an obviously
    clean way to do this in a way that would've been safe in a multi-node
    world.
2022-08-16 Add test case reproducing the log sorting loop problem
    When there's a loop in the graph, and 2 of the 3 legs are tight, but the
    last leg is uncertain and biased to one side, we fail to sort. Add that
    test in.
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2022-08-17 AOSCliUtils - channel filter error message
    Rearranges channel checks in Initialize so user can be notified if a
    channel exists in a config but fails to pass the channel_filter.
    Example output:
    $ ./aos_send /foo Msg '{}'
    F20211210 09:43:42.628487 12011 aos_cli_utils.cc:103] matched channel does not pass the channel filter: "channel is sendable on node" [matched channel info]: { "name": "/foo", "type": "Msg", "frequency": 2, "max_size": 100000, "source_node": "pi0", "destination_nodes": [ { "name": "pi1", "timestamp_logger": "LOCAL_AND_REMOTE_LOGGER", "timestamp_logger_nodes": [ "pi0" ], "priority": 4, "time_to_live": 0 }, { "name": "pi2", "timestamp_logger": "LOCAL_AND_REMOTE_LOGGER", "times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
2022-08-18 Add more helpful Rust Configuration methods
    Also switch where they're attached so they can be used with both
    versions of Configuration we have in Rust.
    [configuration_for_rust.h]
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2022-08-25 Move relavant pcbs to 'circuit boards'
    Add folder for boards
    [10 SIZE CODE G-L.stp, 430450601.stp, EEHAZF1E271.step, LED-Current-Regulator.kicad_sch, LUXEON_2835_20160407_STEP.STEP, RspPiLED_Driver.sch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]
2022-09-01 Expose some Channel strings to Rust from C++ wrappers
    I can't find a better way to do this, so it looks like we have to
    manually wrap each of these with two C++ wrapper functions for now.
    [configuration_for_rust.h]
2022-09-01 Stop popping when finding invalid solutions
    When 2 solutions in the middle of a solve are invalid, we were popping
    one. This can cause some serious issues. Imagine the following case:
    We've got 3 nodes to solve for. Their clocks are all synced for sake of
    explination.
    ta = 5.0
    tb = 5.0
    tc = 1.0
    We really want to solve for tc, but we might learn when solving that ta
    and tb are invalid but close enough to ignore. So, before, we would
    have popped tc, freezing things past the final ta solution. Instead, we
    should just wait to deal with ta and tb until one of them is the best
    solution and has been popped.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
2022-09-01 Track and cache the number of constraints with data
    This sets us up to build constraint matricies to solve the constrained
    optimization problem.
2022-09-01 Fix filter debug print with missing directions
    We were assuming that when printing out the debug problem, if one
    direction exists, the other does too. This causes problems in certain
    test cases and in the real world when debugging.
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2022-09-09 Only solve with the constraints which are relevant
    With a large problem statement, typically only a couple of constraints
    are relevant in the end. Turns out, the set of relevant constraints is
    highly related to the set of constraints which are initially violated by
    the unconstrained solution. So, guess that those are the relevant set,
    and resolve with any constraints which end up being violated. Resolving
    occasionally is cheaper than solving the original problem.
    This reduces the solve time by another 3x. Should be about as good as
    we can do without guessing a better seed.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
2022-09-13 Refactor TimestampProblem into a solver and a problem statement
    This was a great suggestion from Quan and Brian Smartt. This lets me
    write tests easier by injecting example problems. The solver is still
    very much geared towards the timestamp problem, but it has a much better
    hope of working for other problems.
    It is hard enough to separate all this now that I'm not separating this
    out and distributing it into the existing patches and commiting it last.
2022-09-15 Start migrating to upstream pip package management
    Rather than packaging up Debian packages, we can start using upstream
    wheels.
    There are still some issues to figure out. The biggest one is how to
    make the upstream packages reproducible. Some packages like numpy are
    distributed as wheels which should address the majority of concerns.
    Some packages are only distributed in source form though. Those will
    be compiled by rules_python against the host system. We'll need to
    find a better way to deal with those.
    For now you can use the new Python setup if you use
    `--config=k8_upstream_python`. Once the majority of the issues are
    fixed, I will get rid of the special casing. Then you'll only need
    `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
2022-09-15 Squashed 'third_party/flatbuffers/' changes from e5f331db9..bc44fad35
    bc44fad35 UnPackTo disable merge by default (#7527)
    4fca4dc60 [TS/JS] Move TS tests to dedicated folder and deps upgrade (#7508)
    036032373 Bump junit from 4.13 to 4.13.1 in /java (#7526)
    89dfb43f3 Replace `bash JavaTest.sh` with `mvn test` (#7500)
    c49aff4b6 enabled cpp17 tests in CI (#7524)
    56e60223c prevent force_align attribute on enums (#7523)
    89b1f5aa1 remove travis config (#7522)
    b90159823 [Java][Flexbuffers] Add API to add nullables into the buffer. (#7521)
    8cdc6a288 Install BuildFlatBuffers.cmake (#7519)
    a67e35aff Moves all of the swift test code into tests/swift (#7509)
    f124e41ae Updated Readme
    4c954181c [Java][Fle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
    [util.h]
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2022-09-18 Shaft encoder adapter board
    Add kicad files for the shaft encoder adapter board.
    [150080AS75000_Download_STP_WL-SMCW-0805_rev1.stp, 705410074.stp, CRCW08051K20FKEAC.STEP, S1-X-250-X-B-D.STEP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]
2022-09-18 Refactor ErrorCounter out from timing report code
    This is helpful to allow other applications to track error counts in a
    similar manner.
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2022-09-20 Fix use after free in logger_main with --rotate_every
    We were saving it in a lambda and then exiting the scope. Move the
    scope out.
    [logger_main.cc]
2022-09-21 Detect part files missing from the middle of a log
    There are very few use cases where we want to delete part files out of
    the middle. Most of the rest of the code will complain bitterly. Until
    someone comes up with a use case, detect it when sorting and complain
    then.
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2022-10-02 Found a workaround for the camera exposure issues we've seen
    Calling SetExposure before the calls to configure the camera (image height,
    width, frame rate) allows the camera exposure to come up properly.
    If this isn't done, then the camera comes up with images that are darker
    than the desired exposure, and then any following calls to camera_reader
    have a brighter (proper) exposure.
    NOTE: this changes the exposure values that we use, so we need to be sure
    to verify that the exposure settings are still correct for indoor/outdoor
    use in competition.
    I think this also makes auto exposure come up properly-- we were having
    some issues with this before.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
2022-10-15 CAN Terminator board
    [705550036.stp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]
2022-10-15 MAG encoder adapter board
    [20021521-00010XXLFc.stp, 70555-0005--3DModel-STEP-361473.STEP, 705550002.stp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]
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2022-10-22 Filter out blobs with too many points
    Filters out people's hands in the earliest stage, preventing that from
    triggering the vision status led.
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2022-10-24 Potentiometer adapter board
    [Bourns-3547.step, potentiometer_adapter.kicad_pcb, potentiometer_adapter.kicad_sch]
2022-10-25 Encode flatbuffers directly into the encoder when logging
    We were running out of memory when running for many hours. Initial
    debugging looked like it was a heap fragmentation issue. Tracking the
    allocated memory using the malloc hooks wasn't showing any growth of
    memory. The heap was growing though.
    Instead of allocating a FlatBufferBuilder/DetachedBuffer for each
    message to be logged, we can instead have the BufferEncoder provide
    memory to write to, and have it only alloate that buffer space once, and
    allocate it to the maximum size that a writer might see.
    [logger_main.cc]
2022-10-29 Switch to generating pip packages in a Debian container
    This patch switches us to use the upstream Debian Bullseye image for
    building pip packages.
    I couldn't find any specific reason to do this, but I was worried
    about the upstream AlmaLinux-based one causing subtle issues.
2022-10-30 Scouting App: Prevent double tap zoom on counter buttons
    In Rapid React, teams often shoot two cargo in rapid succession so the user of the scouting
    app taps the increment button twice. However, this causes the app to zoom in on the button on
    mobile devices. This causes the user to stop watching the match to undo the zoom-in and
    a lot of frustration. More info on the solution can be viewed at
    https://developer.mozilla.org/en-US/docs/Web/CSS/touch-action#manipulation
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2022-11-05 Import missing pip packages for --config=k8_upstream_python
    There are still a bunch of packages that were not available for
    `rules_python`. This patch imports them.
    I was running into some trouble with pip insisting on listing
    `pyyaml_env_tag` as `pyyaml-env-tag` in the lock file. This caused
    some trouble in the interaction between our wheel override and
    rules_python. I adjusted both to use the same name.
2022-11-08 Squashed 'third_party/flatbuffers/' changes from bc44fad35..8aa8b9139
    8aa8b9139 Fix handling of +/-inf defaults in TS/rust/go/dart codegen (#7588)
    001adf782 Add support for parsing proto map fields (#7613)
    dbc58ab77 Fix help output for --gen-includes (#7611)
    2facfeec7 Fix missing spaces in flatc help text (#7612)
    4de2814c7 Fix: arduino platform build (#7625)
    37b1acdaf Fix current official name of macOS (#7627)
    a22434e2a Add missing #include <algorithm> for std::min/std::max uses, and #include <limits> for std::numeric_limits<> (#7624)
    214cc9468 Bump Rust version to 22.10.26 before publication (#7622)
    a4ff275d9 Added option to not requires an EoF token when parsing JSON (#7620)
    15f32c690 pyth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
    [util.h]
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2022-11-19 Search through config for schema of specified flatbuffer type
    Allow user to call function that returns a schema reflection in
    the config for flatbuffer type instead of having to find a
    matching schema manually.
    [configuration.h]
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2022-11-24 Import GTK in preparation for rules_python
    We currently import GTK libraries as part of the "python_gtk" repo.
    That pulls in GTK, but also Python and a bunch of pip packages.
    This patch makes it so that GTK is pulled in via a dedicated repo.
    That allows us to have dedicated repos for pip packages via
    rules_python.
    Future patches will make use of the new GTK import.
    I had to modify `download_packages.py` in order to ensure that `libc6`
    really got excluded from the final tarball. On James' personal
    machines, he observed stack smashing crashes when `libc` is in the
    tarball. The `force_includes` usage pulled in `libc6` even though we
    don't want it to.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
2022-12-04 Scouting App: Add keyboard shortcuts for note scouting
    With keyboard shortcuts, note scouts don't have to stop watching the match
    to switch between textboxes, they can just do Ctrl + 1/2/3 to switch
    to the corresponding textbox.
    Hovering over the textbox, will display a tooltip with the
    shortcut to switch to that textbox.
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2022-12-05 Solver with turret fixes and visualization
    Converges generally well, but still has sensitivity to some parameters
    In addition to turret and visualization, significant changes include:
    -- Added quaternion parameterization for pivot_to_imu
    -- Filtering out of bad gyro readings
    -- Scaling of rotation error (residual)
    Visualization tool is really just a set of helper routines to plot axes
    in 3D space in a projected 2D virtual image
2022-12-06 Scouting App: Add Keyboard Shortcut tests
    Add a test to scouting_test.ts that checks if switching between
    note scouting text boxes with keyboard shortcuts (ex. ctrl + 1) works.
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2022-12-08 Check that subsystem range is within pot voltage range
    This checks that the subsystem range is within the potentiometer
    voltage range, ensuring that the potentiometer won't break, even
    at range extremes. The range that the potentiometer can handle
    is 0 to 5 volts or -5 to 0 volts, so the subsystem positional
    limits should be within these bounds.
2022-12-10 Get matplotlib working with upstream Python
    This patch adds support for using matplotlib plus its Gtk backend with
    `--config=k8_upstream_python`. Unfortunately, the Tk backend doesn't
    work because of how Python is packaged. See the following issue for
    more information:
    https://github.com/matplotlib/matplotlib/issues/23074
    Separately, we need to patch pygobject and matplotlib for various
    hermeticity reasons. To accomplish this, I've added patching support
    for wheels downloaded via rules_python. I should have set it up to use
    annotations (the same mechanism we use for injecting deps), but it was
    a little cumbersome. Annotations are not set up for using in arguments
    to repository rules. I inst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
2022-12-14 Rock Pi 4 Power Board
    [3V3-3V0-power-supply.kicad_sch, 3V3-power-supply.kicad_sch, 705550001.stp, 705550002.stp, 705550003.stp, 705550011.stp, 744031001_Download_STP_WE-TPC-3816_rev1.stp, ECS-5032MV-400-CN-TR.STEP]
2022-12-14 Hall Effect Sensor Board
    [015913034.stp, hall-effect.kicad_pcb, hall-effect.kicad_sch]
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2022-12-15 Revert "Added units per volt ratio constants"
    This reverts commit 7fdbd66e319a465d1b2c3871cd89dc55d7d7900d.
    Reason for revert: Breaks master
    [constants.cc, constants.h]
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2022-12-17 RRIB2
    roboRIO interface board 2
    [705410001.stp, 705410002.stp, 705410003.stp, 705410004.stp, 705410005.stp, 705410006.stp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]
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2022-12-25 Make matplotlibcpp work with upstream Python
    This patch doesn't work on its own because the users of matplotlibcpp
    often still depend on "debian_bundled_python" packages. If you want to
    test locally, run with Ic7a8ba6110516aa2446ad2ad4e2495fab62d824c.
    I can't get the version from master working. I'm assuming that's
    because it refers to Python 3.5 instead of our current Python 3.9.
    Regardless, you can see the plots with the new setup like so:
    $ bazel run //frc971/control_loops/drivetrain:line_follow_drivetrain_test -- --plot --gtest_filter=LineFollowDrivetrainTest.BasicGoalThetaCheck
    (Note that you need `--config=k8_upstream_python` if running without
    Ic7a8ba6110516aa2446ad2ad4e2495fab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
2023-01-03 Fix mirroring for non-platform source-only Python packages
    I ran into an issue with gflags where the wheel wasn't getting
    mirrored properly. This is the first wheel that we built ourselves
    that didn't have any native extensions. I.e. it's a non-platform
    wheel. The logic accidentally disregarded them when figuring out which
    wheels need to get mirrored.
    This patch fixes the error. `gflags` now gets mirrored properly.
2023-01-03 Fix dependencies in //frc971/control_loops/python
    The rules_python toolchain is stricter about some of this stuff.
    Switching to it revealed some misspecified dependencies. This patch
    attempts to fix some of those dependencies.
    Separately, quite a bit of code relies on Python's
    hermeticity-breaking behaviour of adding the fully resolved path of
    the file's directory to the import search path. That will be fixed in
    a separate patch.
2023-01-03 Fix FatalUnsetRealtimePriority
    Errno was getting modified, so PCHECK wasn't printing the right thing.
    Save it and restore it around the scheduler restore.
    While I was debugging this with strace, I noticed that we weren't
    switching to SCHED_OTHER properly, and that syscall was returning an
    error (which was the errorno being displayed with PCHECK).
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2023-01-10 Add option to map without robot position
    We currently don't have a reliable way of getting the box of pis
    position (need to put down estimator on IMU pi, or come up with a
    different solution). For testing, we will just assume that two
    images captured within a short amount of time have no robot motion
    between them.
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2023-01-10 Add field for image channel in charuco lib
    Allows us to easily send it to /camera/decimated for mapping, which is
    what we're using until we start logging at full frequency.
    Also, move some command line flags out of charuco lib to avoid manually setting flags.
2023-01-11 Correctly initialize legacy v4l2 reader image size
    Fixes v4l2 crash for raspberry pis.
2023-01-11 Migrate everything to upstream pip packages
    This patch migrates all the Python packages I could find to the
    packages provided by rules_python. It's possible that there are some
    that I missed. In that case, the finder will have to migrate it on
    their own.
    A future patch will remove the remaining references to the
    Debian-packaged Python packages in future patches. This patch here is
    solely focused on migrating the existing users.
2023-01-14 Make 2023 camera start first try
    We had an order of operations problem with some of the pin
    configuration. Fix that and set an exposure + gain as well.
2023-01-14 Squashed 'third_party/allwpilib/' changes from e4b91005cf..83f1860047
    83f1860047 [wpilib] Add/update documentation to PneumaticBase and subclasses (NFC) (#4881)
    9872e676d8 [commands] Make Subsystem destructor virtual (#4892)
    25db20e49d [hal] Fix segfault in various HAL functions (#4891)
    b0c6724eed [glass] Add hamburger menu icon to titlebars (#4874)
    f0fa8205ac Add missing compiler flags and fix warnings (#4889)
    42fc4cb6bc [wpiutil] SafeThread: Provide start/stop hooks (#4880)
    cc166c98d2 [templates] Add Command-based skeleton template (#4861)
    3f51f10ad3 [build] Update to 2023v3 image (#4886)
    1562eae74a [ntcore] Refactor meta-topic decoding from glass (#4809)
    b632b288a3 Fix usages of std::min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
    [util.h]
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2023-01-19 Fix potentiometer offset constants
    Fixed the potentiometer offset constants to work with
    superstructure_lib_test.
    [constants.cc]
2023-01-19 Added units per volt ratio constants
    This reverts commit 00c730d45e241e494d8c22b52340769ea9a83a9a.
    Reason for revert: Works again.
    [constants.cc, constants.h]
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2023-01-22 Fix mag encoder board
    [MAG_encoder_adapter.kicad_pcb, MAG_encoder_adapter.kicad_sch]
2023-01-22 Solve mapping problem in 3d
    Solving for z, pitch, and roll will help us get better estimates for
    the 2d pose that we actually care about.
    Also, since we are only using the box of pis for mapping, deleted
    functionality for mapping with robot position so I didn't have to
    support that in 3d.
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2023-01-24 Fix race in ShmEventLoop
    The logic in ShmEventLoop is trying to make sure messages are replayed
    in order, and wakeups aren't dropped. It does this roughly by:
    * Grab the time
    * Process all the wakeups
    * Look at all the queues for new messages
    * Process messages (and timers) up until the time grabbed above
    * Repeat until there is nothing to do
    * Go back to sleep
    There is a small race. If a message is published after the time is
    grabbed but before wakeups are processed, we won't process it and will
    go to sleep. The fix is to retry in that case.
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2023-01-24 Add utility function for appending channel to a config
    This is helpful for certain log-replay tasks.
    [configuration.h]
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2023-01-30 Log camera images at full speed
    We no longer need the /camera/decimated channel
    And give the TargetMap channel more headroom
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2023-02-04 Make max image age a parameter in code
    Remove the flag and put it in the constructor for ImageCallback, so that
    intrinsics calibration can define a much shorter age. This shorter age
    is needed so that the watcher doesn't get too far behind and we aren't
    able to quit the application.
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2023-02-12 Add foxglove_image_converter to camera pis
    This makes it so that we can more readily debug issues live by sending
    JPEGs across the network instead of attempting to forward raw images and
    then requiring the browser to handle them.
    Also add the foxglove_websocket binary so that you can connect to the
    pi.
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2023-02-13 Squashed 'third_party/pico-sdk/' changes from 2062372d20..2e6142b15b
    2e6142b15b SDK 1.4.0 release
    5e9a5e827b Add Pico W and lwIP support
    77c04e458c revert TinyUSB update (#889)
    bc5d1b8485 Add channel_config_set_high_priority (#888)
    85dbbfdf4d Update TinyUSB to commit 39069cf4b to pick up recent RP2040 fixes (#886)
    e7267f99fe Fix GPIO # callback parameter (#880)
    4c49427bf3 Fix auto_init_recursive_mutex definition for C++ (#875)
    33818dd0bd Increase PLL min VCO from 400MHz to 750MHz for improved stability across operating conditions (#869)
    8f09099757 sem_acquire has no reason to do a notify! (#857)
    9644399993 Suppress new GCC 12 warning (#842)
    b3c56e7169 Add stderr support and remove 1us timeou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
    [index.h]
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2023-02-18 Switch to relative imports in .ts files
    With the upcoming rules_js switch, I could only get relative imports
    to work reliably. The absolute imports didn't work in some
    circumstances. This patch gets all non-scouting directories moved to
    relative imports. The motivation here is to keep the final switchover
    patch as small as possible.
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2023-02-21 Add missing Publish to drivetrain spline_test
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2023-02-21 Add a steps version of a time varying runge kutta
    Aaand turns out the test was wrong... We had the wrong solution
    function. I thought I was integating dx/dt = -x, and instead was
    integrating dx/dt = exp(x). Integrate that for real.
    [runge_kutta.h]
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2023-02-23 Small tweaks to get extrinsics to work and add some debugging info
    Added workaround to support foxglove-- still need to figure out annotations
    Remove fixed extrinsics from initial calibration file
    Use charuco_diamond by default for extrinsic calibration
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2023-02-23 Add roll joint to superstructure and arm UI
    Arm UI changes:
    - Update robot dimensions
    - Support visualizing roll joint
    - Add roll joint collision detection
    Superstructure changes:
    - Adding roll joint feedback loop and zeroing estimator
    [constants.cc, constants.h]
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2023-02-23 Fix arm UI spline editing
    - Fix angle inversion when clicking
    - Display spline handles
2023-02-23 Fix signs on superstructure motors.
2023-02-23 Fix roll gear ratio in y2023 constants.
    [constants.cc]
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2023-02-23 Actually check roll joint collision for generating
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2023-02-23 Full calibration files for 971 bot
    Includes both intrinsic and extrinsic
    I will probably want to update these, but they should be good enough to get started
    (For example, the x location of pi1 camera doesn't seem right, but most of the other data
    looks reasonable)
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2023-02-23 Allow aprilrobotics to start without camera extrinsics
    This makes it so that it doesn't crash-loop prior to having extrinsics.
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2023-02-24 Fix the target orientations for 2023 target map
    The aprilrobotics detector reports targets with a different reference
    frame than what the target map was assuming.
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2023-02-25 Make LogMessgae queue have enough memory to print out CAN errors.
    Beats crashing...
2023-02-25 Fix DMA pulse width reader
    Didn't work with multiple readers because we were using the last sample
    time, not the last time the reading went high.
2023-02-25 Reset DMA pulse width reader state when stale
    We should always be updating at a regular interval.
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2023-02-25 Fix roll joint collision detection
    Switch to a simpler check between the min amd max coordinates in each of
    the 3 dimensions.
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2023-02-26 Add code to intake a cube
    Voltage is flipped for cubes.
    [constants.h]
2023-02-26 Add cube pickup path
    Turns out the link lengths in python didn't match C++... Sigh. I
    updated all the trajectories to be equivilent to what they were before
    the constant switch.
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2023-02-26 Create a reusable cypress_test() macro
    I want to write a couple of tests for some plotting web pages. I keep
    asking other folks to validate that I didn't break anything. It's time
    to automate this.
    This patch creates a new macro that will make it easier for everyone
    to write such tests. We're also converting the one existing Cypress
    test to use the new macro.
2023-02-27 Scale distortion factors to a reasonable amount
    Based on detections at driver practice, the distortion factor shouldn't
    go above 0.0005 (didn't see any above 0.0002).
    Scale factors so that 0.0005 (and anything higher) goes to 1,
    so we can intuitively interpret these.
    A detection heavily affected by distortion should have a factor of
    around 0.1 or greater. Ones closer to the center of the image are
    usually less than 0.01.
2023-02-27 Allow using shortened channel names in foxglove_websocket
    This makes the websocket server's defaults consistent with log_to_mcap.
    By using shortened channel names, we make ti easier to reuse layouts
    across nodes (e.g., this way, the /piX prefix will be removed for
    the channels available on the current pi being debugged).
2023-02-27 Configure rockpi rootfs to be synchronous
    This makes sure that it doesn't get corrupted when we pull power.
    We only ever write to it to deploy things so writing doesn't need to be
    fast.
2023-02-27 Yet another wrist recal.
    We need to make this harder to slip/move the wrist.
    [constants.cc]
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2023-03-01 Fix //scouting/deploy
    The deployed binary currently prints the following error:
    ERROR: cannot find bazel_tools/tools/bash/runfiles/runfiles.bash
    This is a side effect of Iaac8b3fbe76182859962e0d60a68fe3de0fe34cb
    which started using the runfiles API. The final deployed binary did
    not have the same runfiles layout. The `pkg_tar` rule unfortunately
    does not recreate the same runfiles tree. The workaround here is to
    fake it with some symlinks.
    The scouting server starts up again.
2023-03-01 Add ability to query falcon configuration dynamically
    Sometimes, one of the motors appears to not invert correctly. CTRE is
    advising us to double check the config is applying correctly, and try
    re-applying it. This lets us trigger that by hand so we can more easily
    detect if it is happening and fix it.
2023-03-02 Use ErrorList in estimators
    Support it in both the abs + abs, and pot + abs and just abs.
    [absolute_and_absolute_encoder.cc, absolute_and_absolute_encoder.h, absolute_encoder.cc, absolute_encoder.h, pot_and_absolute_encoder.cc, pot_and_absolute_encoder.h]
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2023-03-02 Fix sign error in practice robot wrist offset
    Also recal the roll joint a bit.
    [constants.cc]
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2023-03-03 Scouting: Fix button spacing
    Requested by Tea, less accidential button clicks.
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2023-03-04 Fix drivetrain randomly freezing
    Omar noticed that there was a neutral command fighting the control
    command. Neither of us know why, so we are no longer doing anything
    with neutral... We ran 100 reboots without the diag server and 100 with
    and it worked in both cases.
    He's going to file an internal ticket to debug it on Monday. This
    should get us through the rest of the season.
2023-03-04 Flip roll joint direction
    New sensing strategy flips roll's sensing direction. Rezero while we
    are here.
    [constants.cc]
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2023-03-04 Configure rockpi to flush dirty pages faster
    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
2023-03-05 Add all the rest of the upright and fallen over cone positions
    This doesn't do the point towards us positions, but does the easy ones.
    It also adds some direct connections between score positions.
    [constants.cc]
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2023-03-05 Fixing /camera channel issue on GamePieces
    Without /logger, it was trying to send to the pis, too
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2023-03-05 Support selecting drivetrain side in TargetSelector
    In doing this, I am thinking that we'll probably want to make the
    hysteresis in the target selector *much* less aggressive so that we can
    allow the manipulator to make mistakes.
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2023-03-05 Loosen threshold for max dt between mapping images
    This allows us to connect observations between different cameras.
2023-03-05 Filter out large pose errors in target mapping
    Following same logic as the localizer.
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2023-03-05 Support both the new intake and old intake
    The gear ratio is like 2% different, not worth stressing about. The mag
    encoder moved though, so it has 2 different ratios.
    Calibrate the bot since everything got replaced...
    [constants.cc, constants.h]
2023-03-05 Updated extrinsic calibration for 9971 cameras 1, 3, 4
    Camera 2 optimization not working, so will try to get this working or collect a
    new log
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2023-03-06 Flip left and right for scoring positions
    The driver's perspective is better.
    Note that human player station does not flip.
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2023-03-06 Get ready to deploy DriverRank.jl as part of the scouting app
    This patch almost sets us up to run the DriverRank.jl script on the
    scouting server. There are a few pieces still missing though:
    - The scouting server actually needs to call into the new
    `driver_ranking.GenerateFullDriverRanking() function.
    - We need to get Julia working on the scouting server.
    - The `DriverRank.jl` script needs to parse command line arguments to
    specify input and output CSV files.
    All that work will be done in future patches. This patch here just
    sets up the wrapper logic for Go code to communicate with the Julia
    code via CSV files.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
2023-03-08 Deploy the DriverRank.jl script as part of the scouting app
    The script still can't run for a few reasons, but at least it's
    deployed now. The next step is to figure out how to run it properly.
    The current scouting server will print something like this at a 10
    minute interval:
    2023/03/07 19:09:37 Failed to run the driver ranking script: fork/exec /home/jenkins/repos/971-Robot-Code-2/scouting/DriverRank/src/DriverRank.jl: permission denied
2023-03-08 Upgrade rules_pkg
    The old rules result in this weird error that I can't figure out when
    deploying the Julia runtime:
    $ sudo dpkg -i /tmp/frc971-scouting-julia_1_amd64.deb
    (Reading database ... 124346 files and directories currently installed.)
    Preparing to unpack .../frc971-scouting-julia_1_amd64.deb ...
    Unpacking frc971-scouting-julia (1) ...
    dpkg: error processing archive /tmp/frc971-scouting-julia_1_amd64.deb (--install):
    corrupted filesystem tarfile in package archive: unsupported PAX tar header type 'x'
    dpkg-deb: error: paste subprocess was killed by signal (Broken pipe)
    Errors were encountered while processing:
    /tmp/frc971-scouting-julia_1_amd64.d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
2023-03-08 Deploy the Julia runtime to the scouting server
    This patch creates a .deb package to deploy Julia and the
    DriverRank.jl dependencies to the scouting server.
    This should let the deployed scouting server run the script without
    too much trouble.
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2023-03-11 Add inidicator switch and colors to ArmUI
    Added a purple-ish color for controlpoint 1 and an
    orange-ish color for controlpoint 2. This is just
    so they don't get accidentally swapped/confused.
    An inidicator switch was also added incase you
    need to turn off the indicators with I.
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2023-03-11 Force the DriverRank.jl script to parse team numbers as strings
    We're currently seeing this error on the scouting server:
    ERROR: LoadError: MethodError: Cannot `convert` an object of type Int64 to an object of type String
    Closest candidates are:
    convert(::Type{T}, !Matched::Union{InitialValues.SpecificInitialValue{typeof(*)}, InitialValues.SpecificInitialValue{typeof(Base.mul_prod)}}) where T<:Union{AbstractString, Number} at /var/frc971/scouting/julia_depot/packages/InitialValues/OWP8V/src/InitialValues.jl:258
    convert(::Type{String}, !Matched::WeakRefStrings.WeakRefString) at /var/frc971/scouting/julia_depot/packages/WeakRefStrings/31nkb/src/WeakRefStrings.jl:81
    c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
2023-03-12 Fix crashing issue in led_indicator
2023-03-12 Reject TargetPoses that imply a high yaw error
    We trust the localizer's yaw estimate and any vision estimates
    suggesting a very high yaw error are likely outliers.
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2023-03-12 Log CAN frames to the event loop
    This will make it easier to debug CAN problems in the future.
2023-03-12 Crank down gains on roborio puppet localizer
    It turns out that the roborio had some much slower-than-expected time
    constants on accepting corrections from the localizer pi. It should be
    treating the localizer pi as ~ground truth.
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2023-03-23 Make sure all loggers rotate frequenty to prevent corruption
    This way, we guarentee everything gets to disk in a timely manner, so we
    can survive power off without much data loss.
2023-03-23 Recalibrate both bots yet again
    Wrist slips and arm movement...
    [constants.cc]
2023-03-23 Tune drivetrain controller
    Sigh, no IMU, and the gear ratio was wrong.
2023-03-23 Make the analog gain configurable in camera_reader
    This lets us trade noise for exposure.
2023-03-23 Intake even when spitting
    We were missing cubes in auto because the 2 second spit timer was long
    enough that we were at the next piece already. Instead, always respect
    the request.
    [constants.h]
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2023-03-23 Wait for drivetrain constants before starting
    Otherwise we crash and confuse all sorts of things with a single bad
    drivetrain status message...
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2023-03-24 Allow ImuWatcher to ignore pico timestamps
    We observed an issue with pico timestamps during a match; for what we
    are doing, we don't need them.
    [imu_watcher.cc, imu_watcher.h]
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2023-03-24 Make it so fadvise works in the presence of ResetStatistics
    ResetStatistics was resetting the number of bytes written, which was
    then messing up which portion of the file we were flushing.
    While we are here, make it so that encoder_->Clear() works properly with
    partial writes at the beginning of the queue. This wasn't being
    triggered because we typically only write 1 chunk at a time.
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2023-03-25 Recalibrate wrist on comp after fixing rubbing
    [constants.cc]
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2023-03-26 Add pose error ratio to target poses
    This lets us filter out estimates that had a secondary pose
    estimate which was almost as good as the best one. We should
    throw out such estimates, they have been causing one tag-based
    implied robot position that is completely different from the others.
    Adding this filter to target_mapping prevents jumping implied robot
    positions, at least at distances from the charge station and closer.
    Also makes it so that all our HP-based estimates are accurate.
2023-03-26 Add pose error ratio filtering to localizer
    Using same logic as target_mapping in the parent commit.
2023-03-26 Updating 971 robot calibration and some filtering parameters for april tags
    Improved calibration estimate for pi-971-2 (referenced to pi-971-1)
    Also loosen decision_margin to 50 based on the same data
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2023-03-26 Updated pi-971-3 camera extrinsics based on charuco calibration
    This is based on fixing pi4, and then using single board charuco cal process
    to redo the pi3 calibration (since pi3 was replaced).
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2023-03-27 Fix problems with memory ownership in message filters
    The channel names and types from log replayer were not copied
    to log reader because it was defined as string_view. Changing
    the type to string resolved that for now.
2023-03-27 Add missing nullptr check in LogReader::State constructor
    This change only affects the code which uses replay filters.
    We ran into the path where construction of State happens with no
    timestamp_mapper while running log_replayer on single node logs.
    The timestamp_mapper does not exist when there are no communications
    with other nodes as no filters are needed for logfile sorting. This has been
    reproduced by creating a unit test with a single node which has been blocked
    of any communication with other nodes and by calling Register on the logged files.
2023-03-27 Make LogReader test fail if EndTimer is called in single node replay test case
    The relevant timer was not actually needed in order to terminate the
    test. Make the test fail if the timer is called.
2023-03-27 Log config extractor fixed to make compressed bfbs
    If you didn't use MergeConfiguration(), then you didn't get schemas
    properly deduplicated in the resulting flatbuffer, causing you to end up
    with massively oversized configs.
    [log_config_extractor.cc]
2023-03-28 Make zero straight up and fix all the positions.
    This makes it so we can swap arms and everything works. Also, add a
    scale factor to the distal to manange the difference in pulley sizes.
    [constants.cc]
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2023-04-06 Send less data to the RIO
    The wakeups were slaughtering the CPU load on the RIO. Most things only
    need to talk to the IMU pi, so drop the connection to the RIO. This
    saves 20% CPU usage, making it so we no longer get disabled
    periodically.
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2023-04-08 Recal after cables were swapped on the comp arm
    [constants.cc]
2023-04-08 Gentle introduction of log backend
    The goal is to be able to write short logs to the pre-allocated
    memory. To do that, we want to decouple file operations from logs
    behind light abstraction.
    There are a couple of TODO added. I hope to fix them with next iteration
    where actual memory log backend will be implemented.
    [logger_main.cc]
2023-04-09 Add logic to read out of order joysticks
    If joysticks get out of order on the driverstation, we won't
    get the wrong inputs.
    The id is encoded as a two bit number in buttons 14 and 15.
    [constants.h, driver_station_data.h, drivetrain_input.cc]
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2023-04-09 Fix button mapping for redundant joysticks
    We accidentally submitted with the old buttons...
2023-04-09 Add pico/imu reset counters to IMU status
    Attempt to track when the pico and/or IMU reset based on when the data
    counter and pico timestamps jump unexpectedly.
    Notes:
    * Not actually tested on robot.
    * It would be good to get these values exposed on a webpage.
    [imu_watcher.cc, imu_watcher.h]
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2023-04-09 Recalibrate practice robot after roller fix
    [constants.cc]
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2023-04-10 Calibrate wrist after improved clearance.
    [constants.cc]
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2023-04-13 Fix arm freakout
    There was an uninitialized variable which James found. Manually setting
    it to a bad value triggers the arm to freak out when disabled, and the
    code below didn't clear it. I confirmed that initializing it to 0 fixes
    it...
    I have no clue how to write a test for this reasonably. We'd need
    sanitizers working.
2023-04-13 Recal pot after weird pot slip event
    [constants.cc]
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2023-04-13 Create camera_monitor to restart camera_reader when stuck
    Apparently camera_reader can sometimes end up in a state where it stops
    sending any images. Create a process that restarts camera_reader when we
    stop observing new camera images.
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2023-04-15 Make the scouting webserver accept prescouting data
    This patch makes it so that the webserver parses the pre-scouting bit
    when actions are submitted. The web page doesn't currently support
    this, but will in a future patch.
2023-04-16 scouting: Convert actions to stats when submitted
    Now that actions are submitted, we need to convert them into stats.
    This patch does that by calling the correct conversion function and
    then inserting the result into the database.
    I had to adjust the scouting_test slightly because the behaviour
    changed slightly. The test doesn't clear the database between test
    cases. So the one test case submitting scout data means it can't be
    scouted again. The button is now disabled.
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2023-04-16 Prevent scouts from scouting a non-existent match
    We used to let people enter arbitrary match information, but the web
    server rejects that information. It's better when we don't let people
    enter arbitrary match information. This patch makes it so the "Next"
    button is disabled on the "Team Selection" screen unless the match
    information is correct.
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2023-04-20 scouting: Fix docking/engaged data collection during auto
    Looks like in a recent patch, we violated the scope of the template
    variables that represent the checkboxes for docking, engaged, etc.
    https://angular.io/guide/template-reference-variables#template-variable-scope
    I.e. the button to submit the data could not access the checkboxes
    because it was in its own, distinct `ngIf` scope.
    This patch fixes the issue by putting the buttons in the same scope as
    the checkboxes.
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2023-04-26 Calibrate practice robot after arm gearbox replacement
    [constants.cc]
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2023-05-04 scouting: Fix style in some flatbuffer files
    We're currently seeing warnings like this when compiling the
    flatbuffer files:
    warning:
    /home/jenkins/repos/971-Robot-Code-2/scouting/webserver/requests/messages/request_shift_schedule_response.fbs:5: 13: warning: field names should be lowercase snake_case, got: R1scouter
    /home/jenkins/repos/971-Robot-Code-2/scouting/webserver/requests/messages/request_shift_schedule_response.fbs:6: 13: warning: field names should be lowercase snake_case, got: R2scouter
    /home/jenkins/repos/971-Robot-Code-2/scouting/webserver/requests/messages/request_shift_schedule_response.fbs:7: 13: warning: field names should be lowercase snake_case, got: R3s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
2023-05-04 Close previous encoder before opening a new one
    This reduces peak memory usage slightly. This is better than the
    previous problem where we would keep *all* encoders open when rotating
    the log file.
2023-05-05 Fixed bug in aos::starter::StarterClient::Succeed
    To enable support for chaining commands with StarterClient,
    it was necessary to change the order that StarterClient::Succeed
    was performing its cleanup operations. With the new change,
    a downstream function can call StarterClient.SetTimeoutHandler
    inside their function that was set as the success callback.
    A unit test was added to starter_test.cc to demonstrate that
    this change fixes the issue.
2023-05-05 Hint on a couple of NPE crashes during log reading.
2023-05-15 Only allow message_bridge to connect with matching config sha256
    We've been seeing a ton of crashes becasue the config doesn't match, and
    a node is out of range, or the client is asking for a channel which
    doesn't exist. Honestly, there is no real use case at this point in
    time for accepting connections from clients who aren't running the same
    code. We can't read the logs if we were to allow it, and the effort
    required to support that is massive. We'll probably run into send too
    fast issues, would run into flatbuffer version problems (maybe), and all
    sorts of other problems. The cost to reward ratio doesn't work.
    So, as part of connecting, send the sha256 sum of the config. The
    server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
2023-05-25 Change docked and engaged checkboxes to radio buttons
    Checkboxes allowed the user to select multiple choices, which can cause illogical combinations to be made. Changing the checkboxes to radio buttons will prevent combinations like these from being made, since they only allow the user to select one choice.
2023-05-27 Scouting App: Fix bootstrap icons CDN
    Currently, the scouting app fails to load the bootstrap icons resource. This patch
    fixes this issue so icons, like the delete icon in the view tab, are displayed
    properly.
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2023-05-28 Make starter_test reliable
    We were setting a success bool in another thread, but weren't
    synchronizing with that thread. Join the thread before reading the
    success variable to synchronize that variable.
    This makes starter_test go from 1-2% failure to 0% failure on my
    machine.
2023-06-22 Add statistics and filter outliers in mapping
    Compute the standard deviation and error for each position and rotation
    element in our constraints, so we can understand how good the resulting
    solved target map will be. Then, filter based on these stats to get rid
    of constraints with large errors, and resolve for a better target map.
    Also, delete the constraint seeding because these get flagged as
    outliers.
2023-07-08 Squashed 'third_party/rules_rust/' changes from 078c6908f..bf9ddeb7c
    bf9ddeb7c Release 0.25.1 (#2049)
    db5b2fd65 Update tinyjson (#2050)
    6a7872ae3 Fix prost proto packages not sanitizing to valid module names (#2044)
    c080d7bfa Moved legacy protobuf rules to `proto/protobuf` (#2043)
    1281cc051 Remove debug code. (#2048)
    cd126be1f Fix build failure finding crate_roots when mixed with generated sources (#2041)
    7f751cddd Consolidate rust_prost_library and fix extension-only proto generation. (#2047)
    6118c81f2 Release 0.25.0 (#2042)
    a6f29fd07 Add Prost and Tonic rules. (#2033)
    9442aed8c fix: `crate_type` more accurately corresponds to CC linking actions (#1975)
    4f4e2b17b Re-enable zig example on CI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
    [config.txt]
2023-07-19 Run clang-format on the entire repo
    This patch clang-formats the entire repo. Third-party code is
    excluded.
    I needed to fix up the .clang-format file so that all the header
    includes are ordered properly. I could have sworn that it used to work
    without the extra modification, but I guess not.
    [absolute_encoder.cc, algorithms.h, c2d.h, coerce_goal.h]
2023-07-20 Rename timer `Setup` function to `Schedule`
    This patch was motivated by my desire to fix a typo in the function
    name. The noun "setup" is 1 word. The verb "set up" is 2 words. All
    other member functions are verbs, so this one should be a verb too.
    That means that the function should be called `SetUp`. During the
    discussion that resulted from the rename, James Kuszmaul pointed out
    that "setting up" a timer can be confusing. It implies that you can
    only "set up" a timer once. But the intent is to let users set up
    timers as many times as they like. So we decided on renaming the
    function to `Schedule`. That conveys the purpose and intent better.
    I took this opportunity to fix some other typos i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
    [sensor_reader.cc]
2023-07-20 Make jinja2_template properly declare its output
    Previously, the `name` attribute was being used for the jinja output,
    however that attribute one is a default bazel attribute that is
    not marked as an output. This was a weird bazel edge case which was ok
    to be used in genrules, but the generated files could not be accessed in
    a py_binary because the outputs weren't declared correctly.
    Add a separate `out` field that is explicitly declared as an output.
    To keep the API call the same, make a wrapper macro that fills this
    field out, given a name parameter.
    Additionally, add a `list_parameters` field to the build rule.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
2023-07-21 Maybe fix zero sized messages
    We are seeing occasional zero sized
    messages. The only place I can guess these are coming from is a
    "partial" buffer from the lzma encoder which is actually 0 length. Add
    in both more debugging, and code to potentially fix that cause. We'll
    want to revert parts of this patch if this proves not to be the issue
    (and make it a CHECK).
    F20230502 20:28:21.927556 5914 log_backend.cc:65] Check failed: size > 0 (0 vs. 0) : Nobody should be sending empty messages.
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2023-07-21 Disconnect instead of crashing if a client sends a large Connect
    We were rejecting connections if the sha256 didn't match, but generally
    when the sha256 doesn't match, someone has changed the size of the
    Connect message. This was resulting in the Read call overflowing the
    buffer and CHECKing. Instead, trigger an abort in this case, and boot
    the client safely.
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2023-07-21 Fix null pointer dereference if node isn't in the node list
    *** Aborted at 1684438270 (unix time) try "date -d @1684438270" if you are using GNU date ***
    PC: @ 0x0 (unknown)
    *** SIGSEGV (@0x0) received by PID 17002 (TID 0x7f90778700) from PID 0; stack trace: ***
    @ 0x7f907856a0 ([vdso]+0x69f)
    @ 0x270a3c aos::message_bridge::MessageBridgeServer::MaybeIncrementInvalidConnectionCount()
    @ 0x2701c4 aos::message_bridge::MessageBridgeServer::HandleData()
    @ 0x26f840 aos::message_bridge::MessageBridgeServer::MessageReceived()
    @ 0x277954 std::__1::__function::__func<>::operator()()
    @ 0x2b0e78 aos::internal::E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
2023-07-21 Size WMem large enough to hold all published messages at once
    If the server sends a message to all the clients at once, it overflows
    the kernel tx queue for message bridge. We used to account for things
    poorly enough that it would mostly work. We now are much tighter about
    our needs, so we don't. Track the memory required more explicitly here.
2023-07-21 Add ChannelIsForwardedFromNode to aos/configuration.h
    [configuration.h]
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2023-07-23 Added the non-fatal MaybeReadFileToString() function
    Applications which read files to string typically had to previously
    die upon encountering an error, which could sometimes be unideal in
    the larger scope of the program. A MaybeReadFileToString() function
    was added for cases where a program must read from a file, but shouldn't
    ever die.
2023-07-23 Add library function to lookup storage duration per channel
    This sets us up to actually add configuration per channel and have all
    the call sites automatically update.
    [configuration.h]
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2023-07-23 Switch to 32 bit message indices when possible in aos
    Larger queues need larger indices. Everything is 32 bits to support old
    32 bit CPUs. Conditionally use 64 bit atomics when we can on 64 bit
    processors so we can have more messages. 32 bit processors are becoming
    pretty old, so no sense hamstringing the rest of the system based on
    their constraints.
    This also runs both tests on 64 bit processors to maintain coverage of
    the 32 bit code.
    [configuration.h]
2023-07-23 Statically initialize mersenne twister for UUID::Random()
    By re-seeding the pseudo-random number generator on every call to
    Random() we were effectively limiting ourselves to at most 2 ** 32
    possible UUIDs (because std::random_device only produces 32 bits).
    By making the pseudo-random number generator thread_local, subsequent
    calls to UUID::Random() in the same thread will cover additional bit
    space and get us closer to an "actual" 128 bits of randomness.
    This alone is *probably* sufficient to remove any potential for hash
    collisions in the foreseeable future, but we probably should more
    properly initialize the random number generator.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
2023-08-05 Add emtpy rustfmt.toml to project root
    If you have a rustmt.toml along your path, it will try to use
    that configuration when running rustfmt. This is fixed by adding
    a rustfmt.toml which is currently empty but which could be used
    later on for setting up formatting rules.
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2023-08-17 Ignore `ipc_lib::kWakeupSignal` by default
    This patch came out of trying to make `message_bridge_test` less
    flaky. The test currently fails occasionally without an error message.
    It just stops.
    When run under `gdb`, we see the following:
    [New Thread 0x7fffeda496c0 (LWP 59)]
    I20230806 21:23:50.636907 59 message_bridge_test_lib.cc:28] Started pong
    [New Thread 0x7fffed3e06c0 (LWP 60)]
    I20230806 21:23:50.648432 60 message_bridge_test_lib.cc:28] Started ping
    [New Thread 0x7fffecd776c0 (LWP 61)]
    I20230806 21:23:50.658921 61 message_bridge_test_lib.cc:28] Started pi1_message_bridge_server
    I20230806 21:23:50.702045 61 shm_event_loop.cc:1026] Setting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
2023-08-25 Add a continuous absolute encoder zeroer
    For swerve modules, we need to be able to zero a system where the
    absolute encoder has a 1:1 ratio to the output and the output can spin
    infinitely. Create an altered version of the AbsoluteEncoder zeroer to
    do this.
    Tests basically just steal from the absolute encoder tests, with an
    extra test to check that it handles multiple revolutions correctly.
    [constants.h, continuous_absolute_encoder.cc, continuous_absolute_encoder.h]
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2023-08-29 Remove old thread_local.h
    This was to work around a clang 9.0.0 bug. We are on clang 13. Make
    things simpler by removing it.
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2023-09-13 Make AOS starter print out application version on crashes
    This way a journal log parser can unambiguously know what application
    crahsed. Note that when an application crashes before it can send a
    timing report out (e.g., if it crashes during initialization), this will
    not end up helping.
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2023-09-13 Track which types of data are stored in which files
    This sets us up to pre-load timestamps but not data when sorting log
    files by recording the types of messages in each log file. The goal is
    to be able to load all timestamps and remote timestamps completely into
    RAM at the beginning if they are in separate files, and then reduce our
    data buffers to something small. By loading all timestamps into RAM at
    the beginning efficiently, we should be able to solve the entire class
    of frozen bugs.
2023-09-13 Make starterd less likely to crash when under stress
    When I added information to the starter daemon to allow it to more
    easily print out the versions of applications that had crashed, this
    inadvertently created a scenario where the starterd would crash if the
    system was under heavy load and the starter fell behind on watching
    timing reports. We really shouldn't do this in starterd, so alter it so
    that if the code that looks for timing reports observes that we have
    fallen behind significantly, it skips over all the old data rather than
    trying to read every single old message.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
2023-09-14 Add AOS docs covering ShmEventLoop & multi-node constructs
    Add a few thousand words covering the ShmEventLoop and the basics of how
    multi-node systems work.
    Still a fair amount to be written on multi-node systems overall.
    This also updates/adds to some of the example code we have:
    * Add options that allow for experimenting with higher rates & fetchers
    in ping/pong (since I talked about performance benefits of watchers vs
    fetchers in the docs).
    * Update the starter_demo script to no longer call `aos_starter`
    `starter_cmd` and to provide the `aos_timing_report_streamer`.
    * Add sample code for using the `ServerStatistics` clock offsets.
    This change is primarily meant to put factually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
2023-09-14 aos: Let log_stats find inefficiently packed flatbuffer messages
    James Kuszmaul found that some messages are inefficiently packed. This
    was causing unnecessary CPU usage increases of the logger.
    In order to find any other channels with inefficiently packed
    messages, this patch adds a new `--print_repack_size_diffs` flag. This
    flag prints the number of bytes saved when messages on the
    corresponding channels are naively repacked. The repacking method is
    currently _very_ naive. Only use it when necessary. Otherwise, it'll
    take a long time to analyze your log. I recommend using it with the
    `--run_for` flag.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
2023-09-14 Clean up previous test artifacts in multinode_logger_test
    Not all tests use the fixture, and we had a couple of logs made in the
    main tmp folder, so they weren't being cleaned. Fix that all so
    --test_output=streamed works.
2023-09-14 Disable timers on aos::Application on drop
    The issue occurs when an application doesn't live for the duration
    of the event loop. Originally, we were seeing segmentation faults
    due to timer handlers being called after the application had been
    dropped. We now do the proper cleanup to avoid this.
2023-09-14 Read all timestamps into RAM where possible when reading logs
    There are cases where we fail to buffer far enough in the future to
    solve the timestamp problem, or where we end up choosing to buffer until
    the end of time to solve the timestamp problem. These both result in
    log reading failures either through CHECKs or OOMs.
    Timestamps are tiny. The existence of timestamp_extractor proves that
    we can store the whole timestamp problem in memory relatively easily.
    When timestamps are stored in separate files, let's just load them at
    the start.
    This also adds flags to force this behavior on and off. When a log with
    data and timestamps mixed in it is found, and the flag forces it on, we
    will r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
    [configuration.h]
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2023-09-14 Retry remote timestamps from message_bridge_client
    Mithun and I debugged a log file bug to be that the timestamp didn't get
    delivered. James confirmed that under heavy CPU and network load, this
    can happen and it never gets retried, even though we are sending it with
    a ttl of 0.
    When the Send call fails, we should instead put the message in a FIFO
    and try it again later. That will let us recover in this case somewhat
    sanely.
    This turns out to be fiendishly hard to test in a robust way. I
    hand-coded fault injection but don't have a good way to check it in yet.
    Coming in a future patch set...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
2023-09-14 Register Subprocess timer callbacks prior to OnRun()
    This prevents dangling pointers in cases where a Subprocess instance is
    created/destroyed prior to EventLoop creation.
2023-09-14 Allow non-fatal timestamp solver failures
    This refactors the timestamp filters so that it is possible to observe
    timestamp solver failures without having the application crash.
    This also makes it so that the timestamp_extractor code gets at least
    somewhat exercised by our tests.
    The only behavioral change this should cause for normal users is that
    the stack trace will look slightly different when errors occur, because
    the LOG(FATAL) now occurs when evaluating the result of QueueNextTimestamp()
    instead of deep in the code (the prior LOG(FATAL)'s are replaced by
    LOG(ERROR)'s to keep them visible).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
2023-09-14 subprocess: retry killing stopped process on failure
    Sometimes we fail to stop a process with EPERM, maybe
    because it's in an uninterruptable state in the kernel?
    Keep trying.
    This creates log messages like:
    Failed to send SIGKILL to 'foobar' pid: 17341: Operation not permitted [1]
2023-09-21 Remove std::ref in shm_event_loop
    For some reason, this triggers a crash trace on the roboRIO, but on no
    other processor.
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2023-09-24 Fix drivetrain jittering during placing
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2023-09-24 Update arm paths to be more correct
2023-09-25 Fix HP and Ground pickup
2023-10-02 Prevent starter from killing itself accidentally
    This patch aims to fix a race condition where a user of subprocess.cc
    (e.g. starter) and `shm_event_loop` can kill itself accidentally. This
    generally happens when the user attempts to kill the child before the
    `exec()` call has happened. In that case, the
    `SignalHandler::DoHandleSignal()` function from `shm_event_loop.cc`
    runs inside the child, but actually writes the quit event to the pipe
    that the parent is listening to.
    The fix here is to block the signals before the fork. The parent
    process will unblock the signals before exiting from the `DoStart()`
    function. The child will first restore the default signal handlers and
    _then_ unblock th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
2023-10-02 aos: Detect lockless queue owner death more reliably
    When the OOM killer kills us, or the process otherwise dies
    aggressively, the robust futex cleanup doesn't happen. This results in
    senders, watchers, or pinners getting leaked until reboot.
    Fix this by both checking that the tid exists, along with tracking and
    confirming that it's start time matches the original start time. That
    should let us catch the PID collision case reliably. We only need to do
    the exhaustive check when constructing the queue, so it is OK to be
    expensive.
    Because we're changing the format in the SHMEM files here (i.e. adding
    the `start_time_ticks` field) we need to bump the queue version
    number.
    Mostly written by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
2023-10-02 Fix sctp_test flakiness
    We open an SCTP socket before trying to enable sctp authentication
    to force the kernel to bring the sctp module.
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2023-10-21 Adding multi-camera extrinsic calibration between cameras
    Uses pair of Aruco Diamonds to build extrinsics between neighboring cameras
    Small refactor of charuco_lib to allow construction without requiring event_loop
    Change max_pose_error to 1e-7 based on data from SFR match
    Small cleanup/typos in target_mapping
    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
2023-11-05 Have Application class watch for binary file changes
    It would be nice to have a mode for `aos_starter` that lets you readily
    restart all changed applications. It's also good to know if the
    applications running are the ones on disk. Track whether the file has
    changed since we forked the application (as implemented, I have an
    "unknown" state for if the file changed while forking--it should be
    possible theoretically to detect this, but I don't want to deal with the
    complexity, and it seems generally unlikely for the file to have changed
    in the short window while it is fork'ing).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
2023-11-08 Fix message_bridge_auth_client crash
    When we lose connection to the message bridge authentication server
    (maybe from a reboot or network going down), the client's watcher
    can block for long until we get the gRPC response back from the server.
    This leads to 2 follow-up crashes.
    1. We crash because the watcher tries to read the next message but it's
    long gone (because we blocked for so long)
    2. We restart and we have a full queue of messages to handle which we do
    as soon as possible and crash because we sent too many messages too fast.
    This change adds deadline to the gRPC request which helps prevent the
    bottle-up. Additionally, it switches the request/response model of
    message bridge authe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
2023-11-23 Squashed 'third_party/allwpilib/' changes from 83f1860047..f1a82828fe
    f1a82828fe [wpiutil] Add DataLog and DataLogManager Stop() (#5860)
    2a04e12c6f [apriltag] AprilTagFieldLayout: Add accessors for origin and field dimensions (#5869)
    33e0089afb Cleanup usages of std::function<void(void)> (#5864)
    d06fa633d5 [build] Fix protobuf generation when building with make (#5867)
    049732afb8 [cscore] Make camera connection logging clearer (#5866)
    87f7c19f90 [wpimath] Make InterpolatingDoubleTreeMap constructor public (#5865)
    6b53ef47cf [wpimath] Don't recreate TrapezoidProfile in ProfiledPIDController calculate() (#5863)
    8a3a268ae6 [commands] Add finallyDo with zero-arg lambda (#5862)
    1c35d42cd0 [wpilib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
2023-12-02 Fixed issue found with upside down target at madtown
    Was referencing the wrong pose when remapping the board.
    Seems to work in other cases because this branch isn't taken
2023-12-02 Add script for ssh forwarding configuration
    The ssh config that this script creates enables team members who are
    unable to build robot code locally to build and deploy robot code.
    [local_config_template.txt, remote_config_template.txt]
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2023-12-26 Fix converting CAN position to meters
    HighOutputRatio already multiplies by the wheel_radius when it generates
    the code, so we don't need to multiply it again.
    [constants.h]
2023-12-26 Remove pivot, end_effector, and rollers from bot3
    This is done because the 3rd robot no longer has them on it,
    it won't run without removing them in the code.
    [constants.cc, constants.h]
2023-12-28 Add a script to allow more users to easily upload artifacts
    This makes it so that anyone with access to buildkite can upload an
    artifact to the build server. Existing protections entail:
    1. Doesn't allow users to run this against anything other than the
    master branch.
    2. Does not allow overwriting existing files.
    3. Does not touch files outside of the
    /data/files/frc971/Build-Dependencies/ directory.
    Certainly no riskier than our regular CI at this stage.
    This does cause a surprising amount of disk usage on the software971
    server, due to bazel it extracting the amd64 toolchains.
    Steps required to get this set up were:
    1. Install the buildkite-agent apt package.
    2. Configure the toke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
2024-01-01 Instrumentation to debug epoll socket errors
    * Adding debug statements to help diagnose socket errors
    specifically in the case when no error handling function
    is registered.
2024-01-01 Make starterd print out its own version on failed applications
    We already printed out application versions if they had self-reported a
    timing report before crashing; however, it is useful to always have
    _some_ version information, so include the starterd's own version in the
    log message.
2024-01-01 Fix an msan violation in AOS controls code
    In a move, the destination can be uninitialized prior to the move (and
    the origin should be considered uninitialized after the move).
    A swap however assumes that both are initialized before (and thus after
    as well).
    The ::std::swap was ok with msan in clang 17, but the Eigen-swap was
    not.
    This is in preparation for updating to clang 17.
    [hybrid_state_feedback_loop.h]
2024-01-01 Upgrade arm-none-eabi compiler
    It was 5 years out of date and didn't fully support C++20.
    In doing so, flip off "freestanding" mode for the cortex-m4f compiler's
    use of libstdc++.
    This is because some libraries appear to have been using STL headers
    that cannot be safely linked against in freestanding mode (e.g.,
    <ostream>). I am unsure why the prior compiler was not catching this.
    If this becomes a problem, we can disable it.
    [constants.h, motor.cc]
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2024-01-09 Squashed 'third_party/allwpilib/' changes from f1a82828fe..ce550705d7
    ce550705d7 [ntcore] Fix client "received unknown id -1" (#6186)
    3989617bde [ntcore] NetworkTable::GetStruct: Add I template param (#6183)
    f1836e1321 [fieldImages] Fix 2024 field json (#6179)
    d05f179a9a [build] Fix running apriltagsvision Java example (#6173)
    b1b03bed85 [wpilib] Update MotorControllerGroup deprecation message (#6171)
    fa63fbf446 LICENSE.md: Bump year to 2024 (#6169)
    4809f3d0fc [apriltag] Add 2024 AprilTag locations (#6168)
    dd90965362 [wpiutil] Fix RawFrame.setInfo() NPE (#6167)
    8659372d08 [fieldImages] Add 2024 field image (#6166)
    a2e4d0b15d [docs] Fix docs for SysID routine (#6164)
    0a46a3a618 [wpilib] Make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
    [2024-crescendo.csv]
2024-01-11 Python: Sandbox the requirements update script a bit
    We currently get errors trying to run the requirements update process.
    The issue is that pip tries to set up packages that require various
    host tools just to run the setup.py script.
    The patch here runs the update process in a container.
    $ bazel run //tools/python:requirements.update
    WARNING: Overflow when watching local filesystem for changes... temporarily falling back to manually checking files for changes
    INFO: Build option --compilation_mode has changed, discarding analysis cache.
    INFO: Analyzed target //tools/python:requirements.update (84 packages loaded, 27041 targets configured).
    INFO: Found 1 target...
    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
2024-01-15 Swap SZSDPS to use ProfileParametersT
    [constants.cc, static_zeroing_single_dof_profiled_subsystem.h]
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2024-01-20 Swap y2023 wrist over to the constants.json
    There are a couple of awkward constants that show up in json_codegen.cc
    as still being managed from the C++ end; there are also a couple of
    codegen'd constants from the wrist python code that we use in
    constants.h. However, this does move *all* of the per-robot
    configuration into the constants JSON file and should allow us to remove
    the superstructure's dependency on the constants.h (if the arm were also
    converted over).
    [constants.cc, constants.h]
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2024-01-21 A few more changes to support change to orin
    Starter needs to accept orin hostname
    foxglove_image_converter was missing
    image_logger needed JoystickSTate to be shared
    argus_camera had wrong parameter being set for picking the camera dev ID 0
2024-01-21 Update DMA code to match NI-Libaries change
    An update in NI-Libraries made the timestamp out of DMA to be 64 bits,
    this issue was reported here:
    https://github.com/wpilibsuite/allwpilib/issues/6276,
    and a fix was made on the wpilib side here:
    https://github.com/wpilibsuite/allwpilib/pull/6278,
    Which we copied the fix over from.
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2024-01-28 Swap y2024 drivetrain to use ConstantsFetcher
    Simultaneously, remove the line following configuration from the y2024
    drivetrain, since that code will not be relevant to this year.
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2024-02-03 actions and control loops: frc971 shall depend on aos
    And not the other way around.
    Define the loop frequency in actor.h and use that in
    control_loop.h. Fix dependencies (and add missing dependency of
    actor on event_loop).
    [control_loop.h]
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2024-02-07 Combine AbsoluteEncoderAndPotentiometer setters
    Intake pivot will be change to an AbsoluteEncoder however this lays a
    good groundwork to avoid having 3 functions for every AbsoluteEncoderAndPotentiometer
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2024-02-12 Adding reprojection error as an output to calibration
    Also, bumping the threshold default to 2 pixels, since we're
    using higher resolution images, and it generally fails with errors
    close to 2 pixels (when it probably shouldn't)
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2024-02-15 [orin] Add missing null check in argus_camera
    imetadata can be NULL according to the docs at:
    https://docs.nvidia.com/jetson/l4t-multimedia/classArgus_1_1IBuffer.html#a2ad43954937515a506206e3fcbe7228e
    so ensure we check the value before using it.
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2024-02-16 Fix undefined behaviour in `aos/time/time.cc`
    We're currently seeing the following undefined behaviour in the code
    that converts `realtime_clock::time_point` values into human-readable
    strings. The issue is that the computation overflows what we can
    represent in 64 bits when stringifying `realtime_clock::min_time`.
    $ bazel test --config=ubsan @aos//aos/events/logging:logfile_utils_test --test_filter=PartsMessageReaderDeathTest.TooFarOutOfOrder --test_output=streamed --test_env=UBSAN_SYMBOLIZER_PATH="$(readlink -f external/llvm_k8/bin/llvm-symbolizer)"
    [ RUN ] PartsMessageReaderDeathTest.TooFarOutOfOrder
    external/aos/aos/events/logging/logfile_utils_test.cc:169: Fa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
2024-02-18 Add basic imu calibrator
    This provides a ceres-based solver to take in values from multiple IMUs
    and estimate the relative orientations and time offsets of the IMUs.
    It still would need to be hooked up to an AOS log, and doesn't have
    great hooks for visualizing the results.
    [imu_calibrator-tmpl.h, imu_calibrator.cc, imu_calibrator.h, imu_calibrator_solver.cc, imu_calibrator_solver.h]
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2024-02-19 Fix output ratios in wpilib_interface
    [constants.h]
2024-02-19 Fix climber pot/encoder reduction
    [constants.h]
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2024-02-19 Make Rust FlatbufferBuilder realtime
    We do this by changing the internal vectors used to ArrayVec
    (https://docs.rs/arrayvec/latest/arrayvec/) which are effectively
    a direct replacement to a Vec but backed by a statically
    defined buffer, similar to an array but with variable size (note that
    it's the capacity that is constant).
    This is most likely just a workaround. Having looked at the C++
    implementation of flatbuffer, it seems like they use the same
    Allocator API to store this metadata as well. We probably will
    want to do this in Rust as well at some point. For now we just
    set hardlimits on the arrays.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
2024-02-20 Disable audio and trigger an interrupt on each CAN packet
    Audio was causing spurrious interrupts. Exclude the kernel module to
    fix it.
    CAN was waiting until 1ms of deadtime on the bus, or 16 packets then
    delivering them... I patched the kernel to make it a module option, and
    this sets it to deliver every packet.
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2024-02-22 Make profile type a template parameter
    We'd like to be able to swap in more complicated profiles for the
    catapult. To do that, make it a template parameter.
    AdjustProfile went away because the more complicated profiles don't have
    to have the same concept of what the parameters are.
    [profiled_subsystem.h, static_zeroing_single_dof_profiled_subsystem.h]
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2024-02-24 Account for socketcan providing realtime timestamps
    We are getting realtime timestamps back, but were treating them as
    monotonic times. Fix that.
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2024-02-24 Change the way we set the climber position
    This fixes the logic to set the value of absolute encoder
2024-02-24 Flip motors to be accurate to the positive direction
2024-02-24 Use correct current limits in the retention roller
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2024-02-26 scouting: Don't ask for confirmation when leaving the View tab
    Since there's really no risk when navigating away from the View tab,
    it's pretty annoying to confirm the action. This patch makes it so the
    user doesn't see the confirmation dialog anymore. They can switch away
    from the View tab without issues.
2024-02-27 Create y2024 localizer
    This is primarily a copy of the y2023 localizer, with updates to
    better characterize the noise of the april tag readings (by separating
    out heading/distance/skew measurements).
    It also listens to the drivetrain Position message for encoder readings
    rather than relying on the IMU board to send them.
    This adds a few things:
    * The main localizer libraries and processes themselves.
    * Updates to the AOS configs to pull in the appropriate localization
    channels.
    * Creates the typescript plots for localization debugging.
    * Creates some dummy camera extrinsics for use in the tests.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
2024-02-27 Further robot bringup
    * Add some basic buttons for controlling the superstructure.
    * Put climber into brake mode.
    * Tune intake a bit.
    * Add more information to superstructure.
    * Improve sequencing to match robot's behavior better.
    * Add slightly better collision avoidance for turret/extend, until
    a more proper solution is implemented (see
    https://software.frc971.org/gerrit/c/971-Robot-Code/+/8184).
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2024-03-01 Set calibration visualizer image channel correctly
    This makes the calibration visualizer take in a channel name, and
    doesn't leave it hardcoded.
2024-03-01 Helper program to rename calibration files and add extrinsics
    Could likely replace rename_calibration_file.sh script, since I think
    it does all the same (though the script is a little simpler to use)
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2024-03-02 Fix catapult absolute encoder in field webpage
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2024-03-02 Disable voltage error on 2024 intake pivot
2024-03-02 Swap to combined voltage/encoder message for localizer
2024-03-02 Remove unused calibration files
    This got made irrelevant by Jim's fixes to modify_extrinsics.
2024-03-02 scouting: Fix debug message in requests.go
    The `request.TeamNumber()` field is returned as a byte sequence in Go.
    That is very hard to read. This patch fixes the issue by converting
    the team number to a string before printing it.
2024-03-02 Tune loops on 2024 bot
    Rollers were going too fast, current limits were bad. This mostly
    works.
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2024-03-04 Scouting: Update dead screen and dropped
    Revive and undo should be separate because we need to make a distinction between a scouter accidentally pressing the dead button vs the robot dying and then reviving. Scouters should also be able to end the game from the death screen.
    An N/A radio button was added for robot position in endgame to allow scouters to unselect Park, Harmony, etc.
    Previous implementation of dropped was based on if there are two picked up actions in a row. Since scouters currently press undo if the robot drops the note, this will never happen. A separate dropped button fixes this.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
2024-03-14 Stop rollers with coast to stop skipping belts.
2024-03-16 Swap can_translator to batched frames
    This makes it so that the IMU can use standard CAN rather than CANfd.
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2024-03-16 Fix handling of encoder initialization in HybridEkf
    We were handling it oddly---we should not have been indicating that the
    encoders were initialized when we first initialized the state.
    Also, add a force_dt parameter to be used as mitigation for some other
    timing issues in the y2024 localizer.
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2024-03-16 Various y2024 localizer updates
    * Make use of ignore_tags list to deweight/ignore some april tags.
    * Pull in y2022/3 corrections style where we use implied robot x/y/theta
    for corrections rather than heading/distance/skew (this may not
    be necessary any more, as I believe the original reasons
    for switching are largely resolved).
    * Fix up the replay binary
    * Various tunings.
    * Mitigation for Orin timing issues.
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2024-03-16 Add application for measuring inter-packet jitter live
    This lets us stop ftrace when we see a high inter-packet latency event
    for debugging.
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2024-03-16 Turn the orin fan on full
    It uses an un-measurable amount more power and cools the chip down quite
    a bit more. We hit thermal limits on pi1 on the box of pi's (it was a
    airflow problem, but more fan doesn't hurt).
2024-03-16 Add jitter analysis
2024-03-16 Update jitter analysis to print less often
    1000 milliseconds instead of microseconds
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2024-03-17 Improve handling of absent encoder values
    This is the first year that we have relied on the network to forward
    encoder values to the localizer, which makes it so that we can no longer
    rely on encoder values being available. Improve our behavior in these
    cases to prevent us from destroying the localizer's state too much when
    we lose encoders/network.
2024-03-17 Expose more gyro zeroing parameters
    These tuning values are somewhat hardware-specific. Don't actually use
    this yet, since it didn't turn out to be necessary for what I was trying
    to accomplish.
    [imu_zeroer.cc, imu_zeroer.h]
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2024-03-17 Tweak 2024 robot drivetrain radius
    From spinning the robot in place, we observe a shorter effective radius
    (the actual measured radius also is much closer to the updated value
    than the old one).
2024-03-17 Explicitly set matplotlib backend in drivetrain.py
    Otherwise --plot doesn't work great.
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2024-03-17 Remove PEAK pci-e card CAN busses.
    We unplugged the card, teach the code to no longer expect it to be
    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
2024-03-17 scouting: Enable strict template checking
    I kept making mistakes that the compiler wasn't catching. Only when
    you run the actual app do you see the errors (in the console).
    This patch makes Angular actually check the code inside the template.
    This required fixing up some code. Most notably, I switched some
    things around so they use data bindings more.
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2024-03-18 Add drivetrain_replay binary for y2024
    This lets us debug drivetrain/controller issues offline.
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2024-03-18 Sundry extrinsics/target mapping fixes.
    * Rate-limit foxglove image converter.
    * Don't log foxglove image channels.
    * Make pose error more permissive to allow for better matches covering
    gaps in field.
    * Allow matching between more than just the immediately previous target
    detection for situations where multiple cameras see multiple separate
    targets.
    * I mucked around with --outlier_std_devs; idk how much impact it has.
    * Fix event loops & distributed clock calculation in extrinsics.
    * Update box of orins calibration appropriately.
    * Fix FindCameraCalibration call in y2024 target_mapper.
    * Generate a misnamed map of the blue-side [6, 10] tags on the EPA field.
    The variations f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
2024-03-18 [orin] Bump max orin camera frequency to 70
    We're seeing some errors in `argus_camera` from sending frames too fast.
    Bump the limit a bit.
2024-03-18 Handling naming of IMU Orin and exiting data collection
    Orin2 changed to imu, so need to find way to handle it. This won't
    work for other years that have 2 cpus named orin, but will for 2024
    Also, when trying to quit, we need to shut down processing to give
    the event loop time to exit.
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2024-03-21 Small changes, like changing drawn_nodes -> drawn_cameras
    Changing to use camera_name instead of node_name
    Optionally splitting field, based on alliance-- grouping all targets
    on each side of the field as belonging to one alliance
    Fixed typo in set_orin_clock.sh and do it for both orins
2024-03-22 Updating robot extrinsics and /orin1/camera0 intrinsics
    From data collection at EPA on 3/17/2024
    Includes updated intrinsics for /orin1/camera0
    Also, cleaned out old calibration files and renamed cam-24-08 to remove
    sub-second timestamp, which we no longer use
2024-03-22 Add "disable_climber" and "disable_extend" to robot json files
    This allows for disabling the climber and extend through robot.json files. Since the climber currently does not work it will be set to true.
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2024-03-23 Increase RemoteMessage frequency to stop crashing
    We were overwhelming the channel with timestamps when the network would
    back up. There's no need to cut this fine, increase the frequency.
2024-03-23 Disable voltage monitoring in hardware_monitor
    It was locking up the i2c bus and blocking us from reading images.
    Disable voltage monitoring by a flag for now and we can debug it later.
    There were some flatbuffer construction issues, fix those too while we
    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
2024-03-24 Tweak auto splines
    * Update starting position
    * Remove sleep that is made unnecessary by velocity thresholds on
    turret/altitude convergence.
    * Speed up three-piece pickup spline.
    * Slow down outward spline (TODO: I am not sure this is buying us
    much).
    * Increase sleep to fire final gamepiece to give extra time for
    localizer to stabilize.
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2024-03-24 Use the imx296 fixed exposure kernel driver change
    Exposure wasn't doing the right thing in the kernel. Now that it is
    fixed, update the values in use by argus_camera.
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2024-03-25 Print out the diffs between ideal and solved
    For each target in the target map, print the difference between
    the solved map and the ideal (given target map), from the perpsective
    of the ideal reference frame
2024-03-26 scouting: Fix naming of assemble_static_files rule
    Originally, we only had pictures in that rule so naming the attribute
    `pictures` made sense. But now we have a bunch of other kinds of files
    in there. Let's rename it to `srcs` to be more consistent with other
    rules.
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2024-04-04 Add yaw corrections to plot, normalize angles in status message
2024-04-06 Update some tunings & swap to heading/distance/skew
    * Tune down the velocity offset variances, which significantly
    reduces the odds of horrible corrections killing the robot's
    position.
    * Swap over to using heading/distance/skew for localizer corrections.
    * Tune noise values associated with the heading/distance/skew.
    Had to lazily make some of the tests pass....
2024-04-06 Make spline drivetrain code not move once stopped
    This year we don't want to have the robot twitching at the ends of
    splines. Ideally this might be configurable, but this exact code is
    likely not long for this world.
2024-04-06 Don't disable drivetrain outputs on missing IMU
    This also makes it so that the down-estimator doesn't assume that the
    2024 robot exists in simulation....
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2024-04-18 scouting: Fix duplicate StartMatchAction submissions
    When the user hits the "Undo" button right after hitting the "Start
    Teleop" button, they get put back to the "Init" screen. But we've only
    removed the `EndAutoPhaseAction`. Instead, we need to go back to the
    "Pickup" screen.
    The fix here is to properly undo just the `EndAutoPhaseAction` action.
2024-05-04 Sandbox gstreamer
    We were leaking out to the system libraries for a couple more things.
2024-05-04 Add force preload button
    This was useful when testing with a broken intake.
    Defaults to disabling the button.
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2024-05-05 Fix drivetrain current limit setting
    Drivetrain goes vroom-vroom now
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2024-05-11 aos: Make SetCurrentThreadAffinity errors a bit nicer
    When the SetCurrentThreadAffinity call fails, it prints this error
    message:
    Check failed: sched_setaffinity(0, sizeof(cpuset), &cpuset) == 0: Invalid argument [22]
    It doesn't actually tell you what CPUs you tried to set. That can make
    debugging harder. This patch fixes that by enhancing the error message
    to print the set of CPUs that were pass in.
2024-05-11 Reduce discrepancies between FlatbufferToJson versions
    This:
    * Causes NaNs to always be printed as "nan" or "-nan".
    * Makes whitespace printing more consistent.
    Additionally:
    * Adds several TODOs regarding remaining discrepancies.
    * Swaps an argument type to a const char * to improve overload
    resolution.
2024-05-11 Fix AOS logging when using non-EventLoop configuration
    Fixed crash in aos::Logger when reading back a log that was made
    by providing a different configuration to the Logger than was
    used by the event loop.
    Change event_loop_to_logged_channel_index_ to use
    `std::optional<uint32_t>` instead of `int`. Channel indices
    should be uint32_t. Changed to optional because the channel can
    be missing from the configuration specified in the logger
    Constructor.
    [configuration.h]
2024-05-11 Fix handling of empty C++ comments in JSON parsing
    When AOS parses a JSON file, it first performs some preprocessing
    to remove comments before passing the document to the real parser.
    The removal of C++ style comments using // had a corner case. If
    you had a comment that had no content, just //\n, then the \n was
    being swallowed and the next line was commented out too.
    This change reorganizes the handling of C++ comments to allow this
    to be correctly handled, including if the document ends with an
    empty comment.
2024-05-11 Fix possible data race in `aos/network/multinode_timestamp_filter.h`
    When debugging why the pylogcat tests time out sometimes, I ran the
    tests with the thread sanitizer enabled. It complained about this data
    race:
    WARNING: ThreadSanitizer: data race (pid=23)
    Write of size 8 at 0x7f01f677e810 by thread T3:
    #0 aos::message_bridge::NewtonSolver::NewtonSolver() /proc/self/cwd/external/aos/aos/network/multinode_timestamp_filter.cc:88:62 (libexternal_Saos_Saos_Snetwork_Slibmultinode_Utimestamp_Ufilter.so+0x7facc) (BuildId: 125f6a2edddf59a1a30e77e67718c89d)
    Previous write of size 8 at 0x7f01f677e810 by thread T4:
    #0 aos::message_bridge::NewtonSolver::NewtonS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
2024-05-11 Fix Python wheel generation
    We were seeing this error when importing the `thrift` package:
    Repairing wheel artifactory-0.1.17-py3-none-any.whl
    INFO:auditwheel.main_show:This does not look like a platform wheel, no ELF executable or shared library file (including compiled Python C extension) found in the wheel archive
    Assuming artifactory-0.1.17-py3-none-any.whl is a non-platform wheel. Skipping.
    Repairing wheel thrift-0.16.0-cp310-cp310-linux_x86_64.whl
    thrift-0.16.0-cp310-cp310-linux_x86_64.whl is consistent with the
    following platform tag: "manylinux_2_34_x86_64".
    The wheel references external versioned symbols in these
    system-provided shared libraries: l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
2024-05-11 Fix crash in message_bridge_server
    * The crash in `message_bridge_server` was due to an
    attempt to access an unset or empty `std::optional`
    that led to an exception being raised.
    * The fix here is to access the `std::optional` only
    if a value had been set.
    * The function `MaybeIncrementInvalidConnectionCount`
    has been moved from `MessageBridgeServer` to
    `MessageBridgeServerStatus` since it was altering
    only the state of `MessageBridgeServerStatus`.
    * A unit test has been added for coverage of this
    function.
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2024-05-11 Logger: Print solve number along with candidate solution for debug info
    While solving the timestamp problem in log reader, print the solve
    number for a candidate solution. This can be helpful to dig into the
    details of a particular solve.
2024-05-11 Add a test reproducing a log reading failure
    We saw a case where we only had a reliable message for the second boot.
    on pi2 from pi1 { "name": "/atest1", "type": "aos.examples.Ping" }
    .monotonic_event_time={.boot=0, .time=99.000150000sec},
    .monotonic_remote_time={.boot=0, .time=99.000000000sec},
    .monotonic_timestamp_time={.boot=0, .time=99.000250000sec}
    on pi2 from pi1 { "name": "/atest2", "type": "aos.examples.Ping" }
    .monotonic_event_time={.boot=1, .time=0.000100000sec},
    .monotonic_remote_time={.boot=0, .time=1.000000000sec},
    .monotonic_timestamp_time={.boot=0, .time=100.000200000sec},
    This ends up resulting in it looking like the second boot happened 50
    seconds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
2024-05-11 aos: Fix `--force_timestamp_loading` for single-node logs
    We're currently seeing a bunch of segfaults in log-reading code.
    This is happening because the timestamp loading code
    performs some checks against a list of source nodes. This list was
    only populated for multi-node logs.
    The fix here is to populate the list (with zeroes) even for
    single-node logs. That lets the code proceed happily.
    Before this patch I got the following crash for the new test:
    $ bazel test --config=strict_ubsan @aos//aos/events/logging:logfile_utils_test -c opt
    [ RUN ] SingleNodeTimestampMapperTest.QueueTimestampsForSingleNodes
    external/llvm_k8/include/c++/v1/vector:1548:12: runtime error: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
2024-05-11 Fix transmit timestamp logic in SimulatedNetworkBridge
    We were seeing a case when monotonic_remote_transmit_times_ got out of
    sync with the fetcher. This happened when another spurrious wakeup
    triggered us to FetchNext out of sync with the actual wakeups.
    This really just points to the logic being overly convoluted. Use
    monotonic_remote_transmit_times_ as the source of truth for everything
    and sync the fetcher to it instead, and only feed it with timestamps on
    the actual wakeups (reliable messages at startup + reconnect need some
    special handling, but everything else is easy).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
2024-05-11 Only schedule OnRun callbacks right after construction in aos
    OnRun is meant to be a place to do work right before the event loop
    starts to run. On ShmEventLoop, this is the case, and restarting the
    loop isn't all that well supported, so this doesn't make sense there
    either. A lot of our tests have used this behavior since it was easy
    and not disallowed.
    A follow-up commit will explicitly dis-allow this behavior.
2024-05-12 Fix flake in mutex_test due to threading
    gtest's detection of multiple threads isn't perfect and sometimes
    detects that the joined thread is still running. There is no reason to
    create the thread before the fork, so just don't.
2024-05-12 Logger: Print timestamps used for solve for more debug info
    Viewing what timestamps are being used by the solver can be useful
    to debug timestamp solver issues. Include this as part of the debug
    prints.
2024-05-12 Add ability to get source aos::Node* from a Channel*
    This makes it a lot easier to index by Node given a channel. And this
    should be shared code anyways, not in an application.
    [configuration.h]
2024-05-13 aos: Clean up the jinja2_template rule a little bit
    I made some enhancements for custom filters and generated
    replacements. It was easier to implement those after cleaning up the
    code a bit first. This patch does that.
2024-05-13 aos: Support generated replacements in jinja2_template
    I have a rule that generates replacements for a Jinja2 template. I
    can't use any of the current mechanisms to do this so I decided to
    enhance the rule.
    You can now specify a `parameters_file` attribute whose contents will
    be added to the available variables inside the template.
    This came up when I wanted to copy the spyglass colors into a foxglove
    script.
    I couldn't figure out a good way to write a build test for this
    because the //build_tests package in BRT's vendored copy of AOS
    doesn't load properly.
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2024-05-22 Buildify some hand-written BUILD files
    We currently exclude third_party BUILD files from buildifier, but some
    of these are hand-written and so can be reasonably formatted.
    Also, fixes a random flatbuffers BUILD file that I believe had randomly
    diverged from upstream for some reason.
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2024-05-26 Adding support for image_streamer
    Creating new arm64_debian_sysroot to support this
    Added new virtual packages and dependencies for a few gstreamer1.0-...-dev's
    Modified a couple outputs from build_root.py to make it a little
    less verbose and to check for missing yocto debs
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2024-05-30 Revert "Move cameras to RobotConstants in y2024"
    This reverts commit bf8cb9e31fb6715c56a6a01f8f3653660c361f6a.
    Reason for revert: Misread y2024 as y2024_swerve; I don't want to change the y2024 code at this stage.
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2024-06-26 Squashed 'third_party/ceres/' changes from 399cda773..7f9cc571b
    7f9cc571b Set CMAKE_CUDA_ARCHITECTURES depending on CUDAToolkit_VERSION
    6a74af202 Remove a level of indirection when using CellInfo
    f8c2994da Drop Ubuntu 20.04 and add Ubuntu 24.04 support
    20954e693 Eliminate CUDA set but unused variable warning
    57aba3ed0 Enable Apple linker library deduplication
    1f15197be Drop macos-11 runner and support macos-14 instead
    5de0fda0f Update Github actions
    308a5bb43 Add missing include
    715865101 Remove 32-bit MinGW from CI matrix
    f71181a92 Remove remaining references to CXSparse
    522210a08 Reuse macro to format version string
    cd2dd06e9 Fix clang16 compiler warnings
    1f2e6313a Add missing std qualifie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
    [constants.h]
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2024-07-05 Add constructor new to MultiNodeFilesLogNamer
    Add a constructor to MultiNodeFilesLogNamer allowing a aos
    configuration to be specified. This is necessary when doing a
    rerun and saving a log while using MultiNodeFilesLogNamer.
    [configuration.h]
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2024-07-09 Force static flatbuffer memory to be aligned
    For buffers which required lots of alignment, we were allocating more
    space than needed, and manually aligning inside that space. That
    doesn't have a good enough contract to ensure that if the flatbuffer is
    loaded back into RAM, it would still be aligned well enough for the
    requirements.
    Instead, we need to push the alignment requirement out to the allocator,
    and then make sure we stay aligned inside the buffer. The std::vector<>
    allocator isn't guarenteed to be aligned, so switch everything over to
    the AlignedVectorAllocator instead which is aligned.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
2024-07-09 Reduce memory usage of the static flatbuffer API
    This contains a couple of changes, which work together and are a bit
    hard to separate out.
    1) Instead of requiring the whole contents of a sub-message or vector to
    be aligned, split the alignment requirement up into an alignment
    requirement at an offset into the message. This lets us leave the
    length field in a message, for example, at 4 byte alignment when the
    body requires 8 byte alignment. This enables better packing of
    fields.
    2) From James, don't pre-reserve space for vectors with 0 length. They
    will trigger a re-allocation anyways when they are used since there
    is no space allocated, so pre-allocating doesn't hel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
2024-07-10 Remove usage of CHECK_NOTNULL
    We want to switch to absl logging instead of glog. gtest and ceres are
    going there, and we already have absl as a dependency. ABSL doesn't
    have CHECK_NOTNULL, and we can move things over in an easier to review
    fashion.
    [config_remapper.cc, hybrid_state_feedback_loop_converters.h]
2024-07-14 Generate functions to compute swerve internal state
    It is helpful for both debugging and the cost function to be able to
    compute slip angles, slip velocities, etc. Export those to python too.
2024-07-14 Fix and test swerve physics mistakes
    This fixes an x, y, theta mixup so that toeing the modules in or out
    results in the robot aligning them and changing speed accordingly, but
    not spinning.
    It also fixes an issue where the self aligning torque was backwards, and
    tests it.
2024-07-18 Fix fbs sizes for /imu/aos in y2024
    - aos.timing.Report
    - aos.starter.Status
2024-07-20 Adds button board code from 2024 Champs
    Replaces button_board.cc from 2023 to support new hardware
    [driver_station_2.cc, driver_station_2.h]
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2024-07-20 Fix signs on wheels pointed backwards
    When we go backwards, we want to flip the sign of the lateral force, and
    want to also flip the direction of the contact patch piece of the self
    aligning moment.
    The easiest way to do this is to take the sin of the angle, rather than
    doing a piecewise linear function of the angle to flip the sign.
2024-07-28 Fix current related issues
    The Sign of the drive current was flipped and steer current was being multiplied by the motor inertia instead of Kt
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2024-08-04 Add initial velocity MPC
    We actually get to a speed! Need to sort out why steering
    overshoots/undershoots, and test more cases when changing direction.
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2024-08-10 Correct motor inversion on y2024_swerve
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2024-08-10 Create/support "continuous" control loops
    This supplies a wrap_point argument to the control loops code that
    makes it so that you can have a system that spins infinitely (as the
    swerve modules do) and still control them.
    TODO: I observed some idiosyncracies in wrapping behavior during
    testing; this likely requires additional tests to be written to validate
    that we handle wrapping correctly.
    [state_feedback_loop.h, state_feedback_loop_converters.h]
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2024-08-18 Clean up problem initialization in casadi velocity controller
    This makes it a lot easier to read and modify by using symbolic
    names for the states.
2024-08-22 Remove circuit_boards/ directory
    This should be entirely superseded by
    https://github.com/frc971/electrical, maintaining this just creates
    potential for confusion regarding the source of truth.
    [015913034.stp, 10 SIZE CODE G-L.stp, 150080AS75000_Download_STP_WL-SMCW-0805_rev1.stp, 20021521-00010XXLFc.stp, 3V3-3V0-power-supply.kicad_sch, 3V3-power-supply.kicad_sch, 430450601.stp, 705410001.stp]
2024-08-22 Remove motors/ schematics
    These circuit boards are no longer relevant to anything that we are
    doing and tend to bloat the size and folder structure of the repo.
    [board-connectors.sch, board-main.sch, board-motors.sch, board-switcher.sch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]
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2024-09-03 python: Fix issues with top-level deps that have extras
    I824d9ec51c562f0a06b8d2ec1fc27a0e1c8a2ad9 imports the `jax[cuda12]`
    module. That's currently encountering this error:
    $ bazel build --repo_env=FRC971_RUNNING_IN_CI=1 @pip_deps_jax//...
    ERROR: Traceback (most recent call last):
    File "/bazel-cache/buildkite-agent/builds/frc8971-1/spartan-robotics/971-robot-code/WORKSPACE", line 96, column 17, in <toplevel>
    install_pip_deps()
    File "/bazel-cache/buildkite-agent/builds/frc8971-1/spartan-robotics/k8_output_base/external/pip_deps/requirements.bzl", line 70, column 21, in install_deps
    fail("Failed to find an override for \"{}\" in the \"overrides\" JSON f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
2024-09-03 Add sigmoid to replace abs(x) in atan2(y, x) to keep it smooth on the x-axis
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2024-09-03 Fix array indexing warning in y2014 claw.
    Numpy has moved on since we wrote that code. Another warning gone.
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2024-09-21 A few small random changes
    Fix description in printed text in set_orin_clock.sh
    Put a print statement in image_logger that alerts to not starting logging
    until the joystick enabled is pressed
    Added more info about format of channel required to use viewer for
    orins that have multiple cameras attached
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2024-09-22 scouting: Make the deployment work with new rules_pkg
    The rules_pkg upgrade from a couple of months ago broke the scouting
    deployment. The behaviour of the `include_runfiles` attribute changed.
    Instead of flattening the runfiles tree, it now creates a dedicated
    ".runfiles" tree for a binary. This is great, but unexpected.
    This patch fixes the code to work with the new directory layout.
2024-09-23 Scouting app: fix action submission
    In the Review screen, ending the teleop phase showed up as "9" since it was not caught in the switch case in entry.ng.html. Additionally, if
    the scout switched between the endgame and review screen multiple times,
    there would be multiple penalty actions since the penalty action created
    when they went to the review page would not be deleted when they go back
    to the endgame screen. This patch addresses these problems.
2024-09-26 Fix bug in physics and a few in physics_debug
    It turns out we didn't rotate the mounting location when crossing it with force to get torque. We also didn't use calculate current using the PID when calculating the xdot after integrating it. I also added a few more plots that may be useful for debugging in the future.
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2024-10-17 Fix nullptr dereference in dlqr()
    [dlqr.h]
2024-10-17 Remove deceptive velocity physics codegen for C++
    I had added some "velocity" physics which just stripped out non-velocity
    related states, which doesn't make sense for what is *actually* implied
    by the velocity phsyics we refer to (which *also* implies that we are
    not doing a slip ratio calculation and instead assume that the torque
    from the drive motors passes through perfectly to the ground).
2024-10-20 Add error message for no schema in aos/logging/config_remapper.cc
    [config_remapper.cc]
2024-10-26 Add JAX cost, and test to verify correctness
    Turns out there's a bug in the casadi too, so fix that while we are
    here. We were using the unrotated radius for computing the cost
    function torque instead of the rotated radius.
    Split the MPC code out into a separate file as well to make it easier to
    pull into other things.
2024-10-27 Switch to using tensorflow_probability
    This is technically less accurate, but is a lot less to validate since
    we are having trouble getting this to converge.
    To try to adhere to the "unit gaussian" assumption that neural networks
    like, make the physics account for the action limit instead of the actor
    network. We can undo this after things work if we find it doesn't make
    it converge better.
    Also, switch from talking about "cost" to "reward" to adhere to other
    implementations closer too.
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2024-10-27 Add flag to use the swerve model instead of turret
    Velocity swerve, here we come. Doesn't converge yet.
    [plot.py]
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2024-11-06 Configure watchdog on IMU
    Watchdog triggers system reset after 100 ms. Addresses issues such as
    processor or interrupt overload. See doc for details:
    https://docs.google.com/document/d/1XBOxFHc8P92KlShVC_kKH3husulU-NNYZqSwnIabMKc/edit?usp=sharing
    Testing:
    - Check that system runs with no resets under ~5 mins of normal operation.
    - Manually trigger timeout by starving each interrupt loop.
    [Dual_IMU Debug.cfg]
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2024-12-01 Implement faster DARE solver
    Now that SLICOT is no longer used, the slycot, slicot, and clapack dependencies were removed. Furthermore, the Fortran build rule and f2c were removed since SLICOT was the last Fortran dependency.
    DARE solver and c++ tests were made by Tyler Veness <calcmogul@gmail.com>. A python scipy parity test was added on top of this.
    [dare.h, dare_python_bindings.cc, dlqr.h]
2024-12-01 Mark sandbox-breaking calibration test "manual"
    This test went outside of the bazel sandbox to try to locate files on
    the local filesystem; mark it manual to prevent it being run by default
    until we can move the log dependency into a proper dependendency.
    Also, make it so that we actually print out stdout/stderr from the
    process that was failing to make error messages clearer.
2024-12-05 Fix not adding forces and torque
    The jax dynamics was not adding external forces and torques causing the validate dynamics to sometimes not pass.
2024-12-08 intrinsic calibration test and move to 8 parameter model
    Adding an intrinsics test
    For now, leaving off the test that loads from disk
    Move to 8 parameter intrinsics
    Adding test of Distort/Undistort functions (which were slightly broken)
    Adding loading of images into intrinsic calibration (NOTE: still uses
    charuco_lib for this, so commenting out this test)
    Increase min # charucos per image from 10 to 15
    Changing naming of image -> board transforms to make it slightly clearer
    Improved termination criteria to get better convergence to correct values
    Relaxed reprojection error to 5 pixels, so we at least get an file out
    BUT, warn if reprojection error is > 1 pixel
    Added more getters/set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
2025-01-06 Fix setting the CAN Tx priority
    We set the Tx priority in 2024 and 2024_bot3 using
    kDrivetrainWriterPriority when we should've been using
    kDrivetrainTxPriority
    [constants.h]
2025-01-06 Fix up swerve joystick handler code
    This makes it so that the joystick code correctly handles auto mode
    (i.e., does not send joystick-based goals in auto) and fixues up some of
    the sensitivies and axes.
    [drivetrain_input.cc, drivetrain_input.h]
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2025-01-21 Revert "Implement faster DARE solver"
    This reverts commit 12aebae3300d8eaa5ae67e9cf075f95f20692594.
    We're doing this because we aren't really sure how the new solver
    effects swerve and we aren't having many timing issues on our existing
    solver. This should be addressed later in the season.
    [dlqr.h]
2025-01-24 Add position estimation to naive estimator and switch autonomous to use positional error
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2025-02-03 Creates driverstation code for swerve
    - All the 'enc's were swapped for 'adc's
    - The CAN packet and HID packets were altered based on the commented chart in the code
    - To test it, you flash the code to the buttonboards, but the pistol grip that we have isn't compatible(button 17 that
    indicates if the buttonboard is a swerve is broken on the pistol grip)
    - The pistol grip can be flashed the old version of the code, and it will work with other buttonboards with this new code
    - Except for that, this code should work with both swerve and tankdrive
    [driver_station.cc, driver_station.h]
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2025-02-08 Add 2025 localizer
    The goal of this is to give us robust localization on the field this
    year, but because we haven't done full localization with swerve yet
    we're implementing it using wpilib, weighted averaging, and a kalman
    filter. More is explained in the comment in localizer.h
    This also removes the x, y, and theta estimation in naive_estimator. It
    no longer outputs x and y and the theta it uses for correction in the
    lqr is taken from the localizer.
    Furthermore this commit also edits autonomous to properly send out its
    starting position when we press the user button.
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2025-02-11 Fix imu_zeroer not un-faulting
    We used to use FaultBehavior::kLatch but now we switch to
    FaultBehavior::kTemporary and test that we fault in the middle of
    getting a significantly offset zero but not at the end after we
    re-zero.
    Also, fault on recieving too many identical measurements, and add a
    allow_duplicate_samples flag to toggle this behavior to use in tests
    that use duplicate samples.
    [imu_zeroer.cc, imu_zeroer.h]
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2025-02-17 Add nonlinear cost with slip
    Adds a cost to slip which is nonlinear since it's divided by the
    velocity. This also makes it easy to add nonlinear costs in the future
    such as nonlinear cost of omega.
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2025-02-22 Update eigen to version 3.4.90
    Ran `./doc/allwpilib_subtree.sh add third_party/eigen_test https://gitlab.com/libeigen/eigen master`
    Fixes due to updating
    * Updated third_party/eigen/BUILD to have headers from `Eigen/src/plugins/**`
    * Suppressed deprecated warnings in //y2017/vision:target_finder
    * Removed unused variable in y2024/localizer/localizer.h
    * Removed unused variable in y2023/localizer/localizer.h
    * Removed unused variable in y2023/control_loops/superstructure/arm/arm.cc
    * Used CHECK over assert in y2016/vision/blob_filters.cc
    * Added patch file for polynomial test that fails(More here: https://github.com/ceres-solver/ceres-solver/issues/1062)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
2025-02-22 Re order calibration and intrinsics to match robot
    The cameras swapped sides, this commit updates the camera ids and
    intrinsics to match that.
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2025-02-23 Do better error handling in led indicator
2025-02-25 Add debugging visualization to localizer
    This commit visualizes each cameras pose estimation to help show which
    cameras could be causing issues.
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2025-02-25 switch flipping to happen when reading joysticks
    [drivetrain_input.cc, drivetrain_input.h]
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2025-02-27 Add velocity error to autonomous controller
2025-02-27 Fix kalman filter localizer
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2025-03-01 Add flip to autonomous webui and add more autos
    [autonomous_main.cc]
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2025-03-02 Make various splineui improvements
    changes:
    - Added highlighting to selected actions
    - Added contextual editing and highlighting to rotations
    - Fixed undo/redo of actions
    - Added ability to delete actions and rotation breakpoints
    - Changed button appearance when mode is active for better UX
    - Changed README to be more accurate for the current robot
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2025-03-04 Remove led indicator due to unreliability
    It was crashing while testing different things and we don't want that
    for Ventura
2025-03-04 Add initial 3xL4 auto
    This runs a little tight but seems reliable
    [autonomous_main.cc]
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2025-03-05 Pre-Ventura DP changes
    This makes some fixes to auto align, fixes reef mirroring, and does some joystick and setpoint
    tuning.
    [drivetrain_input.cc]
2025-03-13 Update 971 orin1 camera1 with 9971 imu camera1
    The cameras had to be physically switched, this change fixes that
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2025-03-22 Fix FOC button on joystick
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2025-04-01 Use correct noise in kalman filter localizer
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2025-04-01 Add missing ground intake code
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
