frc971/971-Robot-Code/(notices)

Notices in the files:
frc971/imu_fdcan/Dual_IMU/Core/Inc/main.h:
Copyright (c) 2023 STMicroelectronics.
All rights reserved.
This software is licensed under terms that can be found in the LICENSE file
circuit_boards/BuckBoost/RockPI-Power-Board/3dModels/SH-7010TA.stp:
author */ ('License CC BY-ND 4.0'),
parts and their libraries:
Copyright 2021 Accelerated Designs. All rights reserved.
SparkFun-Connectors: Licensing: CC v3.0 Share-Alike You are welcome to use this library for commercial purposes.
SparkFun-LED: Licensing: Creative Commons ShareAlike 4.0 International - https://creativecommons.org/licenses/by-sa/4.0
